FromAIToReality/OpenMicroDuck/hardware/imu_to_dxl/README.md

> **上游技术参考，不是本项目实测结论。** 来源：[fanhao375/microduck-replica](https://github.com/fanhao375/microduck-replica/blob/a23f4c18a4741a3cde5257e639960ea37bbadd8d/hardware/imu_to_dxl/README.md)。保留原作者及贡献者署名；正文中的“本项目”、实物、照片和测试记录属于上游。与我们的硬件不一致时，以[本项目说明](../../docs/hardware.md)为准。

# imu_to_dxl 原理图 + PCB · 求评审

> ⚠️ **这是第三方复刻件，不是官方设计。**
> 官方从未公开这块板的原理图、Gerber 或外形（全网零命中，见
> [硬件方案逆向](../../docs/硬件方案逆向.md)）。本目录是根据 MJCF 模型、官方运行时源码
> 和已开源的 HAT 工程反推 + 自行选型的结果，**未经打样、未经实物验证**。
> 发现问题请开 [issue](https://github.com/fanhao375/microduck-replica/issues)。

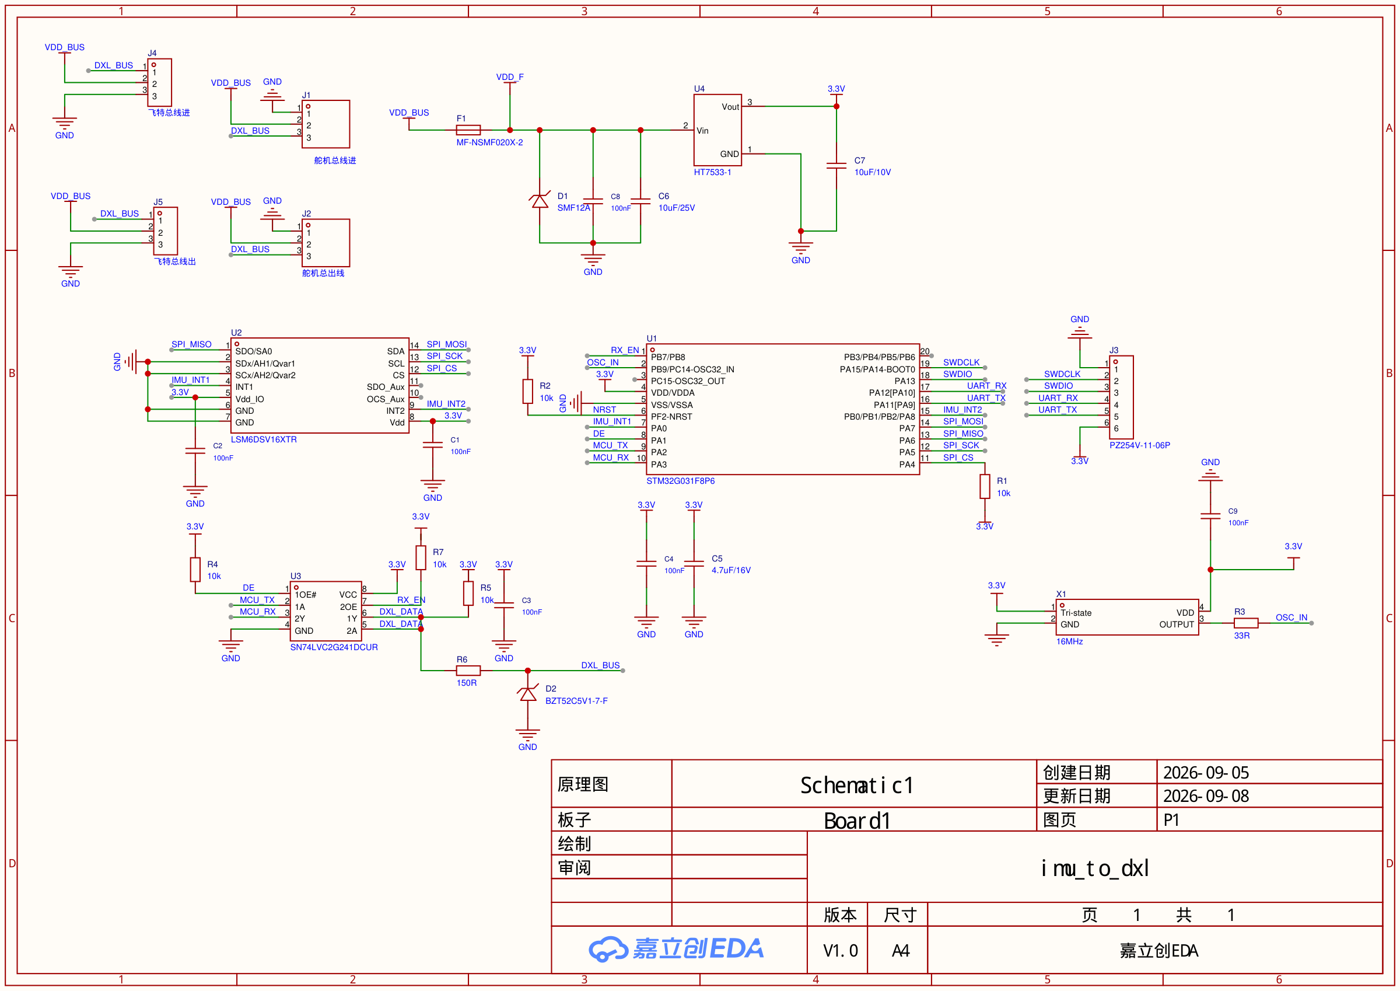
[picture p8: assets/hw/imu_to_dxl-原理图.png]
imu_to_dxl 原理图


| 文件 | 说明 |
|---|---|
| [`imu_to_dxl-原理图.pdf`](https://github.com/fanhao375/microduck-replica/blob/a23f4c18a4741a3cde5257e639960ea37bbadd8d/hardware/imu_to_dxl/imu_to_dxl-%E5%8E%9F%E7%90%86%E5%9B%BE.pdf) | 矢量 PDF，放大看细节 |
| [**`imu_to_dxl-交互式BOM.html`**](https://github.com/fanhao375/microduck-replica/blob/a23f4c18a4741a3cde5257e639960ea37bbadd8d/hardware/imu_to_dxl/imu_to_dxl-%E4%BA%A4%E4%BA%92%E5%BC%8FBOM.html) | **焊接用**：嘉立创 EDA 导出的交互式 BOM，下载后浏览器直接打开（离线可用）。点料号，板图上高亮对应位号，焊一种勾一种。GitHub 页面上直接点只显示源码 |
| [**`firmware/`**](firmware/) | STM32G031 + LSM6DSV16X 固件、Keil 工程、主机测试及一个预编译 HEX；0.2.0 起是飞特 SCS/STS 协议（ID 200），真总线尚未实测 |
| [**`总线协议.md`**](总线协议.md) | **给写固件的人**：15 字节块逐字节定义、时序要求、排队规则、主控的判据、测试向量、验收方法 |
| [`imu_to_dxl-接线表.md`](imu_to_dxl-接线表.md) | 逐网络列出每个引脚，可以直接对着核 |
| [`imu_to_dxl.eprj2`](https://github.com/fanhao375/microduck-replica/blob/a23f4c18a4741a3cde5257e639960ea37bbadd8d/hardware/imu_to_dxl/imu_to_dxl.eprj2) | 嘉立创 EDA 专业版工程，可直接打开改 |
| [`../../BOM.md`](../../BOM.md) | 完整 BOM，含立创编号与每颗器件的选型理由 |

**固件与姿态查看入口：** [`firmware/README.md`](firmware/README.md) 记录单板启动、IMU采样和验证范围。
通过 [`tools/servo-web`](../../tools/servo-web) 可将小板姿态叠加到舵机调试台的 3D 鸭子：关节角来自舵机，躯干四元数来自 IMU。
三种读法：`--imu-bus`（舵机总线，跟主控同一条 sync_read，读 ID 200 地址 56 的 15 字节块）、`--imu-swd`（ST-Link / DAPLink）、`--imu-jlink`（J-Link）。
真总线的 `imu200.py check` 验收还没做。

---

## 这块板干什么

官方 Microduck 的 15 个舵机挂在一条 Dynamixel 半双工总线上。这块小板
**作为第 16 个设备挂在同一条总线上**，对外表现成一个 Dynamixel 从机（ID 200），
主控用读寄存器的方式向它要姿态数据。

板上的 IMU 用的是 **LSM6DSV16X**，它片内有 **SFLP 硬件融合块**，
直接输出游戏旋转四元数 —— 姿态解算不占主控算力，也不占总线带宽。

```
主控（树莓派/泰山派）
      │  1 Mbps 半双工单线
      ├── 舵机 ×15
      └── imu_to_dxl（本板，ID 200）
             ├── LSM6DSV16X   SPI 四线 + 两路中断
             ├── STM32G031F8P6 收包 / 组包 / 读 IMU
             └── SN74LVC2G241 半双工收发缓冲
```

## 核心选型与理由

| 位号 | 器件 | 为什么选它 |
|---|---|---|
| **U1** | STM32G031F8P6 | ① USART 有**硬件 DE**（RS485 Driver Enable）—— 1 Mbps 下一个比特只有 1 µs，软件翻方向脚的抖动就在这个量级。对照：**STM32F401 手册全文没有 "Driver Enable"**，只能软件切<br>② 与 IMU 同厂，ST 的 `lsm6dsv16x-pid` 驱动和 SFLP 例程现成 |
| **U2** | LSM6DSV16XTR | 片内 SFLP 融合，直接出四元数 |
| **U3** | SN74LVC2G241DCUR | 双缓冲做单线半双工。通道 1 左进右出、通道 2 右进左出，正好对着走线。3.3 V 供电时**输入耐 5.5 V**，扛得住舵机 5 V 的信号 |
| **U4** | HT7533-1 | **耐压 30 V** —— 前两道保护都失效时它自己还活着 |
| **F1** | PPTC MF-NSMF020X-2 | **24 V / 200 mA 保持**。本板故障时先断自己，不拖垮整条舵机总线 |
| **D1** | TVS SMF12A | 截止 12 V > 满电 8.4 V，钳位 19.9 V < C6 的 25 V 耐压 |
| **C6** | 10 µF / **25 V** | 挂在 8.4 V 母线上。MLCC 有直流偏压衰减，6.3 V/10 V 的余量不够 |
| **C5** | 4.7 µF | 与 C4 的 100 nF 组成 ST 要求的组合 —— **DS12992 Rev 3, Figure 13** 对 `VDD/VDDA` 明确标注 `1 × 100 nF + 1 × 4.7 μF` |

## 几个可能有争议的决定

### 1. `2OE` 接常高，发送时会听到自己的回显

`U3.1 (1OE#)` 接 DE 控制发送缓冲，`U3.7 (2OE)` **直接接 3.3 V，接收缓冲常开**。

- 代价：发送时 MCU 会在 RX 上收到自己发的字节，固件按发送长度丢弃
- 好处：PA3 永远有人驱动，**不会悬空**

备选是 `2OE` 也接 DE（发送时关掉接收），但那样发送期间 RX 浮空，
重新使能时可能产生假起始位。我选了前者，**欢迎反驳**。

### 2. 没有晶振，只留了焊盘

TSSOP-20 封装**没有引出 `OSC_OUT`**（DS12992 Rev 3, Table 12：2 脚 `PC14` 的附加功能有
`OSC_IN`，3 脚 `PC15` 只有 `OSC32_OUT`），所以**无源晶振根本接不了**。

HSI16 精度（Table 41）：出厂 −0.75%/+0.5%，0–85 °C 温漂 ±1% → 最坏约 **−1.85%/+1.55%**。
1 Mbps 异步 UART 典型容差 ±3%，够用但余量不多。

板上有 **X1（16 MHz 有源晶振，HSE 旁路）+ C9 + R3**，最初默认不贴，2026-09-08 起改为**默认贴片**（固件仍以 HSI16 起步，实测 1 Mbps 有误码再切 HSE 旁路）。X1 的使能脚固定接 3.3 V，PC15 没接到它，MCU 关不掉晶振，见「评审记录 · 2026-09-16」。
另外固件可以用定时器输入捕获测主机来的比特周期，反调 `HSITRIM`（步进 0.2–0.4%/档），
误差能压到 0.3% 以内，不花钱。

### 3. J1 / J2 保留两个，靠铜皮解决过流

J1 和 J2 三根线一一并联。**本板若在链条中间，下游全部舵机电流都流过本板的连接器和铜箔。**

飞特 HD-1910-C001 官方参数：额定 **500 mA** / 堵转 **1.8 A**。

但这个约束**不是本板独有的** —— 舵机之间本来就是菊花链，它们自己的连接器承受同样的电流。
HAT 有 **4 个舵机接口**，15 个舵机分在 4 条支路上，每条最多 4 个，一条支路额定约 **2 A**，
在 3 A 以内。官方设计能接受，本板用同样的座子不会更差。

**所以保留两个座子**：想挂末端就不装 J2，想串中间就装上，灵活性几乎零成本。
PCB 上把 `VDD_BUS` 与 `GND` 从 J1 到 J2 走**大铜皮**（≥ 2 mm 或直接铺铜）即可。

> 曾有评审意见建议「只留一个 3P 座子」。那在本板确定是叶子节点时成立，
> 但**如果它是链条第一个节点**（HAT 出来先进本板、再出去给舵机），就必须两个。
> 官方拓扑无从确认，保留两个更稳。

### 4. 协议靠软件自动识别，没做跳线/拨码

飞特与 Dynamixel 的物理层完全相同（半双工单线 / 1 Mbps / 3 线 / GND-VCC-DATA），
差别只在包格式：

| | 包头 | 后续 | 校验 |
|---|---|---|---|
| Dynamixel V2 | `FF FF` | **`FD 00`** | CRC-16 |
| 飞特 SCS | `FF FF` | `ID` + `LENGTH` | `~(ID+LEN+INST+参数)` |

飞特官方协议文档写明 **Length = 参数个数 N + 2**，所以最小为 2、**永远不会是 0**；
ID 范围 0–253。→ `FF FF FD 00` 只可能是 V2，**判别无歧义**。

固件收到第一包校验通过就锁定协议，之后按锁定的收发，**运行中不自动解锁**（原想"连续 100 包失败重判"，2026-09-17 评审指出总线噪声会让小板哑 2 s、主控 3 tick 没读数就 hold，改掉；见 [`software/飞特适配架构.md` §3.5](../../software/飞特适配架构.md)）。
比拨码开关可靠（会走路的机器人里，拨码触点是振动失效点）。

### 5. J3 用 6P，把串口 printf 也引出来

按2026-09-08原理图 PDF，脚序为
`1=GND 2=SWDCLK 3=SWDIO 4=UART_RX 5=UART_TX 6=+3V3`。
SWD用 **1、2、3、6** 脚；第6脚供调试器电压参考。**旧四针排线不能整排插到1–4脚**，
第4脚是串口输入，不能当作3.3V。接线前核对实板的一脚标记与调试器引脚定义。

UART 来自 U1 脚 16/17（`PA11[PA9]` / `PA12[PA10]`），经 `SYSCFG_CFGR1` 重映射成
`USART1_TX/RX`。

**不上 USB**：G031 没有 USB 外设（手册 Development support 只写 "serial wire debug (SWD)"），
加 USB 要多一颗 CH340/CP2102，45 × 22 mm 板上不划算。
调试走 SWD + RTT（`probe-rs` 支持在 CMSIS-DAP 上跑 RTT，不停 CPU）。

> Cortex-M0+ **没有 SWO/ITM**，别指望 SWO printf。

---

## 板框与安装孔

| 项 | 值 |
|---|---|
| 板框 | **45 × 22 mm**，2 层板 |
| 四角 | **R2 圆角** |
| 安装孔 | **2 × M2 非金属化孔 φ2.2 mm**，走对角 |
| 孔位（板左下角为原点） | MH1 (2.667, 2.413)、MH2 (42.672, 19.685) mm |
| 孔距 | X 向 40.00 mm ／ Y 向 17.27 mm ／ 对角 43.57 mm |
| 孔到板边 | MH1 **1.31 mm** ／ MH2 **1.22 mm**（嘉立创要求 ≥0.4 mm） |

两孔中点 (22.67, 11.05) 与板心 (22.50, 11.00) 相差 0.17 mm，**转 180° 装基本还能对上**（偏差 0.34 mm）。

> ⚠️ **孔位在 2026-09-08 改过。** 原设计是 MH1 (5.5, 3.5) / MH2 (39.5, 18.5)、X 向 34 mm，
> 刻意对齐原版 `banana_pcb_locker` 打印件的两个定位耳间距。
> **加 `J4`/`J5` 时 MH2 的让位圈正好卡住右边那条唯一能放插件的空白带**，
> 于是把两个孔都往角上挪，X 向变成 40 mm。
> **代价是不再与原锁扣通用 —— 机械侧同步改压条。**
> 反正逆向文档里「锁扣压的就是 `imu_to_dxl`」本来也只是推断
> （见 [硬件方案逆向](../../docs/硬件方案逆向.md)），硬约束只有「IMU 刚性固连在 `trunk_base` 上」这一条。

板框文件：`imu_to_dxl-板框-45x22-R2.dxf`（单位 mm，8 段闭合：4 直边 + 4 段 90° 圆弧）。

> **为什么单独给 DXF**：这版立创EDA专业版的图元接口只接受铜层，
> 往板框层（layer 11）建线/弧一律报「参数不正确」，改层、改文档源都被挡，
> 所以板框走 DXF 导入（`文件 → 导入 → DXF`，目标层选**板框层**，单位 mm，原点对齐 0,0）。
> 两个 M2 孔不在 DXF 里 —— 它们已经作为真实的 NPTH 焊盘建在 PCB 上了。

## PCB：布局与布线

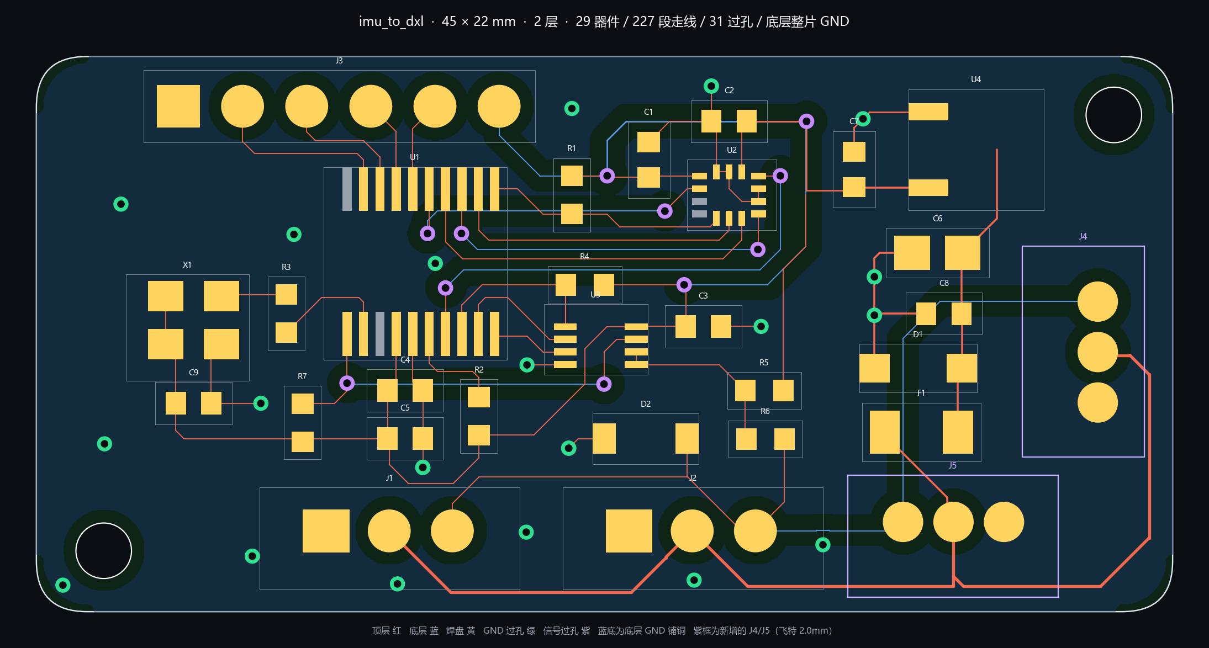
[picture p9: assets/hw/imu_to_dxl-PCB.png]
imu_to_dxl PCB 顶层装配图


*布线图，由工程实测数据渲染（顶层红 / 底层蓝 / 焊盘黄 / GND 过孔绿 / 信号过孔紫，蓝底为底层 GND 铺铜，紫框为 `J4`/`J5`）。*
*状态 2026-09-08：29 器件 · 227 段走线 · 31 过孔 · 172 泪滴，含 `R7`、`J4`、`J5`，`X1`/`R3`/`C9` 已改为实贴。*
*本目录的 `.eprj2` / PCB PDF / 原理图 PDF / STEP 与 `assets/` 下两张图，**全部已更新到 2026-09-08 的最终版**。*

**45 × 22 mm，2 层板，1 oz 铜**，四角 R2 圆角，两个对角 M2 非金属化孔。
贴片件全在正面；3 个插件连接器分两条边：`J1` `J2`（舵机总线）在下边，
`J3`（SWD + 串口）在上边。

### 分区

| 区 | 内容 | 为什么 |
|---|---|---|
| 下边 | `J1` `J2` 总线连接器（JST EH 2.5 mm） | 线束从躯干走线，就近出线 |
| 右下 | **`J5` 飞特总线出**（2.0 mm） | 与 `J1`/`J2` 同侧，四个座子的 `VDD_BUS` 直通铜皮连成一条 |
| 右边缘 | **`J4` 飞特总线进**（2.0 mm） | 全板唯一放得下插件的空白带；为它让路才把 MH2 挪走的 |
| 右侧 | `F1` → `D1` → `C6`/`C8` → `U4` → `C7` | 电源链一条路走到底，跟数字区隔开 |
| 中部 | `U3` 缓冲 + `D2` 钳位 + `R6` 串阻 | 夹在 MCU 和总线连接器之间，收发路径最短 |
| 中上 | `U1` 主控、`U2` IMU 及各自去耦 | |
| 左侧 | `X1` / `R3` / `C9` 时钟位 | 已改为实贴，放在边角不占好位置 |
| 上边 | `J3` 调试排针 | 插拔方向朝外 |

### 布线

| 项 | 值 |
|---|---|
| 元件 | **29 个**（含 09-07 新增的 `R7`、09-08 新增的 `J4`/`J5`） |
| 走线 | **227 段**（顶层 197 / 底层 30） |
| 线宽 | 信号 0.25 mm 为主；**总线直通 0.76 mm** |
| 过孔 | **31 个，φ0.6 / 孔 0.3 mm** |
| 泪滴 | 172 个 |
| 铺铜 | **底层整片 GND**，顶层不铺 |

底层 30 段走线，**地平面基本完整**——这是给 SPI 和 1 Mbps 半双工总线留的回流路径。
顶层的 GND 焊盘各自就近打过孔下到地平面。

### 复查结果 · 2026-09-08

除立创自带 DRC 外，另用脚本按**真实焊盘形状**（圆形 / 跑道形 / 矩形）重新栅格化，
独立复核了一遍：

| 检查项 | 结果 |
|---|---|
| 立创 DRC | **0 违规** |
| **连接器脚序** | **四个全对**：`J1`/`J2` = `GND`/`VDD_BUS`/`DXL_BUS`；`J4`/`J5` = `DXL_BUS`/`VDD_BUS`/`GND`（**反序**，见下方脚序一节） |
| 网络连通性 | **23 个网络全部连通**（栅格连通域 + 过孔/插件孔跨层，含底层铺铜） |
| 异网最小间距 | **0.152 mm ＝ 5.98 mil**（精确几何，非栅格）。嘉立创双面板下限 0.127 mm，余量 20% |
| 铜到板边 | 最小 **0.37 mm** |
| 孔到孔（孔壁间） | 最小 **0.751 mm**，要求 ≥0.4 mm |
| 孔到板边 | MH1 **1.31 mm** / MH2 **1.22 mm** |
| M2 让位 | MH1 让位圈 2.5 mm 内只有一个 **GND** 过孔（1.81 mm）—— 螺钉压到地还是地，无害；MH2 最近 4.59 mm |
| 过孔规格 | φ0.6 / 孔 0.3 mm，符合嘉立创双面板下限 |
| 去耦距离 | `U1.4`→`C4` 2.27、`U2.8`→`C1` 2.00、`U2.5`→`C2` 2.01、`U3.8`→`C3` 1.96、`X1.1`→`C9` 2.39 mm，均 <2.4 mm；`U4.3`→`C7` 2.94 mm。⚠️ `U4.2` LDO 输入侧的 100nF `C8` 为 **6.64 mm**（偏松，但管瞬态的 10µF `C6` 在 4.29 mm，且 LDO 是线性的无开关） |

**载流核算**：四个座子之间的 `VDD_BUS` 直通链
`J1.2 → J2.2 → J5.2 → J4.2` **全程 0.76 mm**，1 oz 铜下 ΔT=10K 约 2.0 A、ΔT=30K 约 3.2 A。
JST EH 单触点额定 3 A，**走线与连接器基本同一量级**，加宽并不能抬高整条链路的上限。
另有 4.7 mm 的 0.51 mm 段在 `J1.2 → F1.1` 这条**只喂本板自己**的支路上，
前面是 200 mA 保持的 PPTC，够用。

> **2026-09-08 抓到并修掉一处**：布 `DXL_BUS` 去 `J4`/`J5` 时，有一个 φ0.3 过孔
> 落在了 `J2.3` 的 φ1.0 插件孔正上方（孔心距 0.001 mm）。立创 DRC 报
> `Hole to Hole (DXL_BUS): J2_3 ↔ e75` —— 钻孔是机械工序，同网络也不允许重叠。
> `J2.3` 本身是贯穿孔、顶底早已连通，该过孔纯属冗余，删除后连通性不变、DRC 归零。

**仍未验证**：**没有打样，没有实物**。以上全部是几何与规则层面的核对，
不能替代实测。

### 待办

- 下单前跑一次**器件标准化**（原理图 DRC 报过「元件属性与供应商编号不匹配」）
- 丝印复核：位号是否压焊盘、`U1` 一脚 / `D1` `D2` 阴极 / `J1` 一脚标记是否齐全
- **连接器高度**：`J1`/`J2`/`J3` 是 JST EH / 2.54 排针直插，本体约 **8 mm**。若躯干内腔
  确实只有 6.65 mm，需换卧式 `S3B-EH-A`，封装与 BOM 都要跟着改 —— 用导出的 STEP 在
  装配体里比一下即可定论。
  **`J4`/`J5` 反而不用担心**：`B3B-PH-K-S` 本体约 **6.0 mm**，塞得进 6.65 mm 的内腔
- **板端座子型号待确认**：飞特规格书只写了线端是 `AMP2.0-3P`，**板端型号没给**。
  本板暂用 `B3B-PH-K-S`（JST PH，2.0 mm 立式）。焊盘阵是三孔 2.0 mm 间距，
  与其它 2.0 mm 系列通用，**将来换系列只改封装、不动焊盘、不重布线**
- **下单前重导生产文件** —— 器件从 27 变 29，立创那边的 Gerber / BOM / 贴片坐标都要重传

## 想请你重点看这几处

1. **`2OE` 常开这个取舍**（上面第 1 条）—— 回显 vs RX 悬空，哪个更糟
2. **J1/J2 过流与铜皮宽度**（第 3 条）—— 2 mm 够不够
3. **HSI16 跑 1 Mbps 的余量**（第 2 条）—— 有实测经验的说一声
4. **三道过压防线够不够** —— 8.4 V 母线 + 舵机反电动势
5. **连接器**：见下方「⚠️ 飞特脚序按型号不同，而且是反的」。`J4`/`J5` 两个 2.0 mm 座子
   已在原理图与 PCB 上落位（2026-09-08），但**板端座子的确切系列还没拿实物比过**
   —— 飞特规格书只写了线端 `AMP2.0-3P`，板端型号待厂家确认

## ⚠️ 飞特脚序按型号不同，而且是反的

**这是本板最容易致命的一处，两份厂家规格书各自都没错 —— 是两个型号真的相反。**

| | 连接器 | 脚 1 | 脚 2 | 脚 3 |
|---|---|---|---|---|
| **`HD-1910-C001`**（本仓库选用） | **`AMP2.0-3P`**（2.0 mm） | **Signal/TTL** | Vcc | **GND** |
| `HL-2915-C002`（另一型号，勿照抄） | `AMP-3` | **GND** | Vcc | **Signal/TTL** |
| 本板 `J1`/`J2`（JST EH 2.5 mm，同官方 HAT） | `B3B-EH-A` | GND | VDD_BUS | DXL_BUS |
| 本板 `J4`/`J5`（2.0 mm，对口飞特） | `B3B-PH-K-S` | **DXL_BUS** | VDD_BUS | **GND** |

四个座子的脚序已从 PCB 网表反读复核过，全部落对（2026-09-08）。
**两种间距插不进对方（2.0 vs 2.5 mm），物理上杜绝了插错，只剩「画错」这一种可能。**

出处：飞特《HD-1910-C001 串型规格书》**A/0，2026-09-07** 第 3/7 页 6-7 项；
飞特《HL-2915-C002 串型规格书》A/0，2026-02-27 第 4/8 页 6-7 项。
两份都是厂家发给客户确认的规格书，**本仓库按惯例不转载 PDF**，需要请向飞特索取。

> 本仓库此前只记了 `HL-2915` 那一行、却推荐 `HD-1910` 作为替代型号，**是个坑**，
> 2026-09-08 按 A/0 新规格书更正。
>
> ⚠️ **`HL-2915-C002` 是 9–14 V（典型 12 V）舵机，挂不上本方案的 2S 母线（6.6–8.2 V）**
> —— 它 9 V 才开始工作。当初拿它当「飞特接口惯例」的样本是权宜之计，别照着选型。
>
> ⚠️ **间距也对不上**：`AMP2.0` 是 2.0 mm，`JST EH` 是 2.5 mm，**插不进对方**。
> 好在这一点反而是保险 —— 物理上杜绝了插错，只剩「画错」这一种可能。

## 已确认 / 未验证

**已确认（一手资料）**

- **HD-1910-C001** 接口 `1=Signal/TTL · 2=Vcc · 3=GND`，连接器 `AMP2.0-3P`，线长 15±0.5 cm
  —— 飞特《HD-1910-C001 串型规格书》A/0 (2026-09-07) 第 3/7 页 6-7 项
- HD-1910-C001 走 **TTL 三针总线**，**4–8.4 V**，堵转 9/12/15 kg·cm @4.8/6/7.4 V，
  额定电流 **500/690/900 mA**，堵转电流 **1.2/1.6/2.0 A**，静态 20 mA，12 bit 磁编码，
  减速比 1/320 —— 同上规格书第 2/7、3/7 页
- **电机自带三道电子保护**（同上第 4/7 页 7-11）：
  **过流**（>0.5 A 持续 2 s 关输出，阈值与时长可自定义，**出厂默认关闭**）·
  **过压**（>10 V 或 <4 V 保护，范围可自定义，**出厂默认关闭**）·
  **过热**（>80 ℃ 关扭矩输出，**出厂默认开启**）。
  **装机前应把前两条打开** —— 异常检测在电机里做，主机不必轮询
- 反馈六项齐全：输入电压 / 负载 / 工作电流 / 工作速度 / 工作温度 / 位置（同上 7-10）。
  官方运行时确实在用：`present_current` 每 tick 随位置一起读，电压+温度约每秒一次，
  且**电压是整机唯一的电池计量手段**（`duck-control/src/{bus,model}.rs`）
- 出厂默认运行模式是**模式 4「纯位置 PD（Sim2Real）」**，正对强化学习落地（同上 7-12）
- 包格式、`Length = N+2`、校验算法、同步读 `0x82` —— 飞特官方《舵机SCS通信协议》
- 包格式、`Length = N+2`、校验算法、同步读 `0x82` —— 飞特官方《舵机SCS通信协议》
- STM32G031 无 HSE 引脚、HSI16 精度、`100 nF + 4.7 µF` 去耦要求 —— ST DS12992 Rev 3
- 原理图连通性 —— 已用脚本逐网络核对，无悬空脚、无短路、无重名网络

**未验证**

- **整块板没打样过**，没有实物
- 板框 45 × 22 mm 与 M2 孔 X 向 34 mm 间距是从打印件 `banana_pcb_locker` 反推的，非官方尺寸
- MCU 型号是本仓库的选型建议，**不是逆向所得** —— 官方那块板用什么 MCU 无从还原

---

## 评审记录

### 2026-09-16 · 外部评审八条 + 自查发现 X1 使能脚没接上

板子已在立创生产，这些都算「首板回来验什么」。

| 评审意见 | 结论 | 依据 |
|---|---|---|
| ① X1 接 PC14/OSC32_IN 是错的，PC14 只是 LSE 脚 | **不采纳，评审错了** | DS12992 Rev 3 Table 12（p.36）：TSSOP20 第 2 脚附加功能为 `OSC32_IN, OSC_IN`，两个都有；p.60：HSE 旁路模式下振荡器关闭、输入脚按普通 GPIO 电平收外部时钟。小封装不引 PF0/PF1，HSE 外部时钟输入就是安排在 2 脚。无源晶振接不了（缺 OSC_OUT）这点本目录一直写着 |
| ② U2 的 OCS_Aux / SDO_Aux 悬空是漏接 | **不采纳**，文档措辞统一 | DS13510 p.10 / p.48：两脚均「接 Vdd_IO 或悬空」，默认内部上拉（PIN_CTRL.OIS_PU_DIS = 0）。悬空是手册标准做法。v2 可留 0 Ω 位 |
| ③ 2OE 常开有回显，建议默认发送时关接收 | 硬件已支持两种，固件决定 | 9 月 7 日已把 `2OE` 改成 `RX_EN` 网络接 PB7，见下方记录 |
| ④ 逻辑支路保护不等于整机过压保护 | 同意，本就这么写的 | TVS 管尖峰、PPTC 慢、LDO 只护逻辑支路，见「对照官方 HAT 复审」 |
| ⑤ J1/J2 直通电流是系统级限制 | 同意，已写明 | 本板做链尾，EH 座 3 A |
| ⑥ J4/J5 板端座子未经实物验证 | **同意，首板前就该做** | 飞特只确认线端 AMP2.0-3P，`B3B-PH-K-S` 能不能插、锁扣方向、脚序，买几个座子拿舵机线试 |
| ⑦ 布局建议（IMU 居中、LDO 远离、测试点、J3 加 NRST） | v2 采纳 | — |
| ⑧ 首板验证清单 8 条 | 采纳，作验收 | 复位期间总线高阻、1 Mbps 收发 00/FF/55/AA、30 000 次通信统计 CRC/超时/overrun、IMU 零偏随温度、逐针测极性、X1 未装时 PC14 不被驱动 |

**自查（2026-09-16）**：按原理图 PDF 的矢量线段逐脚核对，没有接线的只有本来就该空的四个脚：U1.3（PC15）、U1.20（PB3–PB6）、U2.10（OCS_Aux）、U2.11（SDO_Aux）。X1 第 1 脚 `Tri-state` 接的是 3.3 V 常使能（符号上的小红圈是 EasyEDA 的 1 脚标记，不是未连接）。接线表里写的「3 脚（PC15）可作 `OSC_EN`」**没有画进图**：PC15 空着，X1 关不掉。首板要 MCU 能控晶振的话，飞一根线 PC15 → X1.1 并去掉 3.3 V 那根，或者不贴 X1 用 HSI16。

### 2026-09-17 · 首板到货实测

- 5 块板到货，上电 **3.3 V 输出正常**（F1 → D1 → U4 这条链没问题）。
- **J4/J5（`B3B-PH-K-S`）外壳跟飞特线插头不配**：间距 2.0 mm 是对的，插头外形进不了 PH 座的外壳。评审第 ⑥ 条说中了。首板把座子外壳削掉、只留针，能插能用。**v2 换座**：拿飞特线实物配（问飞特板端座子型号，或买几种 2.0 mm 3P 卧式座子试插）。
- X1 时钟、NRST、IMU 供电、SWD 通断还没量；固件要做什么、主控对它的全部要求在 [`software/飞特适配架构.md` §4](../../software/飞特适配架构.md#4-小板固件方案-a--imu_to_dxl)。

### 2026-09-22 · 固件跑起来了（ST-LINK/V2）

- 固件在 [`firmware/`](firmware/)（同学写的底子，PR #32；0.2.0 起是飞特协议）。ST-LINK/V2 经 J3 的 1/2/3/6 脚烧录、读回校验通过，IMU 实测：WHO_AM_I=0x70、约 121 Hz、静止时加速度合成 1.007 g、错误计数 0。
- **G0 空片的坑**：第一次烧完软件复位，程序不跑，停在 ST 自带 Bootloader（PC=0x1FFF…）—— `FLASH_ACR.EMPTY` 只在上电时更新。**断电重启一次**就好。按复位键（NRST）不重新检查，解决不了这个。
- **v2 要加**（首板调试时缺的）：
  - **复位按钮 + NRST 引到 J3**：跟评审第 ⑦ 条一起做。程序跑飞、SWD 连不上时可以按住复位再连（under-reset）救砖，也方便让固件重新跑一遍。
  - **运行指示灯**：接 **U1.20**（PB3–PB6，现在唯一完全空闲的 GPIO）+ 限流电阻。固件加心跳：正常慢闪、IMU 出错快闪，不接调试器也能一眼看出板子在不在跑。

### 2026-09-07 · 三条布局/选型建议（都不采纳，理由记下来）

评审人看了图纸提了三条：阻容换 0402、IMU 放板心、LDO 远离 IMU。逐条量了数据，
**结论是维持现状**，但每条的理由值得记下来 —— 尤其第二、三条其实指向同一件事。

**① 阻容换 0402 —— 不换，理由不在「能不能手焊」**

对方补充说「别折腾自己焊接，团一下上立创贴片省心」。这个建议本身对，但换不换 0402
的判据不在这儿：本目录 2026-09-06 那条记录第一句就写了「**理由不是 0402 手焊不了**」
—— 板上有 LGA-14 的 LSM6DSV16X（底部焊盘 3×2.5 mm），本来就必须上热风。

真正的理由是**调试期返修**：`R6` 串阻要从 150 Ω 试到 33 Ω、上拉可能要摘、去耦可能要补。
**第一版没验证过的板子必然要改几次**，这一点不因为找立创贴片而改变 —— 贴片厂只负责
第一次，改还是得自己动烙铁。

代价那边：16 个阻容换 0402 省 **12.5 mm²，占板面积的 1.3%**，而这块板**只用了 36%
的面积**，根本不缺地方。0402 的 10k/100nF 在立创同样是基础库，省料费这条对两边都成立、
不构成理由。

**② IMU 放板心 · ③ LDO 远离 IMU —— 方向都对，但量级不同**

先量数：

```
板心 (22.5, 11.0) = 两个 M2 孔的中点（当初就是这么设计的）
U2 (IMU)  离板心 7.47 mm，离两螺钉连线 3.00 mm
U3 (缓冲) 离板心 0.41 mm      ← 最刚的位置被逻辑芯片占了
U2 ↔ U4 (LDO) 中心距 6.37 mm
```

**热的量级**：板上总电流约 5–10 mA（G031 约 3 mA + LSM6DSV16X 约 0.65 mA + 缓冲约 1 mA
+ 上拉），LDO 压降 8.4 − 3.3 = 5.1 V → **耗散约 51 mW**（满电最坏）。SOT-89 在小铜箔上
θJA 约 100–160 °C/W → 结温升 **5–7 °C**；隔 6.4 mm、中间一整片底层地铜散热，传到 IMU
处**温差约 1–3 °C**。LSM6DSV16X 陀螺零偏温漂约 0.05 °/s/°C → **约 0.1 °/s 偏置**。
走路时陀螺是几十 °/s 量级，且躯干里 15 个舵机吃安培级电流，热源比 51 mW 大两三个数量级。
**方向对，但不是主导项。**

**真正值得动的是第②条的另一面**：板心正好是两螺钉中点，是全板最不易形变的位置，
而现在坐在那儿的是不在乎位置的 `U3`。把 `U2`/`U3` 对调可一箭三雕 ——
IMU 离板心 7.47 → 0.4 mm，同时离 LDO 6.37 → **11.3 mm**（翻倍）。

**为什么这次仍不动**：板子已 DRC 0 违规、全部布通；对调意味着中间区域重排 + 重布
SPI×4、2 个中断、缓冲的 DE/TX/RX/DXL_DATA。按上面的量级估算，收益是"更稳妥"而非
"解决已知问题"。**留到打样后拿实测数据再决定** —— 若实测陀螺零偏随 LDO 负载明显漂移，
或振动噪声偏大，v2 一并改。

**一个更重要的提醒**：IMU 在**机器人里**的位置与朝向是训练模型定死的，比它在板上偏
7 mm 重要得多。那个由板子怎么装进躯干决定，已查证并记在
[`docs/硬件方案逆向.md`](../../docs/硬件方案逆向.md)：`trunk = [+raw_z, +raw_y, −raw_x]`，
绕 Y 轴 +90°。板上挪位置不影响这条。

### 2026-09-07 · 给 `2OE` 留一根控制线（R7 + RX_EN）

有人建议把「那个 EN 脚」预留一根线到 MCU。指的是 `U3.7 (2OE)` —— 接收缓冲的输出使能，
此前硬接 +3V3、接收常开。**已采纳。**

**改动**

| | |
|---|---|
| 断开 | `U3.7 (2OE)` 与 `+3V3` 的直连 |
| 新增 | **R7 = 10 kΩ 0603**（`C25804`，与 R1/R2/R4/R5 同一颗料，不新增料号） |
| 新网络 | **`RX_EN` = `U1.1 (PB7/PB8)` · `U3.7 (2OE)` · `R7.1`** |
| 保留 | `R7.2 → +3V3`（上拉） |

**为什么选 U1.1**：U1 空闲的是 1 脚 (PB7/PB8)、3 脚 (PC15)、20 脚 (PB3/PB4/PB5/PB6)。
3 脚是 PC15，在 G0 上与 LSE 共用、驱动能力受限；20 脚并了四个口最灵活，留着。
1 脚是普通 GPIO，且与 `DE`/`MCU_TX`/`MCU_RX` 同在下排，走同一条通道。

**默认行为完全不变** —— MCU 复位期间 PB7 高阻，R7 把 `2OE` 拉高，接收缓冲照常开着。
固件一行不写，跟改动前一模一样。这是**预留**：想消掉发送期间的回显时，把 PB7 配成推挽
输出拉低即可，同时打开 `MCU_RX` 脚的内部上拉，避免 `2Y` 高阻时 RX 浮空 ——
这正是此前否掉「`2OE` 接 DE」方案的那个顾虑，用独立 GPIO + 内部上拉就解决了。

**改后复查**：元件 26→27、网络 23→24，`RX_EN` = 3 个脚，`+3V3` 里 `U3.7` 已移出、
`R7.2` 顶上。立创 DRC **0 违规**，异网最小间距 **0.160 mm**（改前 0.153），
其余各项与 2026-09-07 首次复查一致。

**顺带更正**：本目录 `imu_to_dxl-接线表.md` 的「悬空脚」清单此前误列了 2、16、17 脚
（它们分别接 `OSC_IN`、`UART_TX`、`UART_RX`），已改。现在真正空闲的只有 3 脚与 20 脚。

### 2026-09-07 · 关于 U3 缓冲器的三个疑问（两条不采纳，一条改画法）

评审人查了 SN74LVC2G241 手册，对 U3 的接法提了三点。逐条核过 —— 网表是从
PCB 里现读的（PCB 网络由原理图导出，等价于原理图连接）：

```
U3 脚1  1OE#  → DE          脚5  2A   → DXL_DATA
U3 脚2  1A    → MCU_TX      脚6  1Y   → DXL_DATA
U3 脚3  2Y    → MCU_RX      脚7  2OE  → 3.3V
U3 脚4  GND   → GND         脚8  VCC  → 3.3V

DXL_DATA  4 脚：R5.2 R6.1 U3.5 U3.6     ← 不含 U3.7
DE        3 脚：R4.2 U1.8 U3.1
MCU_TX    2 脚：U1.9 U3.2
MCU_RX    2 脚：U1.10 U3.3
```

**① 「A 是输入、Y 是输出，所以脚3 该接 DXL_DATA、脚5 该接 MCU_RX」—— 前提对，结论反了**

手册原文没错：器件是两路独立使能的 1 位线路驱动器，数据方向恒为 **A → Y**。
但据此换线就错了：

- `MCU_RX` 是**要被缓冲器驱动的**网络（送进 MCU 的接收脚），必须落在**输出脚 Y**
  → 现在在脚3（2Y）✅
- `DXL_DATA` 是**要被读进来的**网络（总线上舵机发的），必须落在**输入脚 A**
  → 现在在脚5（2A）✅

按建议对调后，通道2 变成 `MCU_RX(2A) → DXL_DATA(2Y)`，等于从 MCU 的接收脚
往总线上发数据 —— RX 是输入脚不输出电平；而且 `1Y` 与 `2Y` 会同时驱动
`DXL_DATA`，两个驱动器直接对打。

现在的分工是标准半双工接法：**通道1 = 发**（`MCU_TX → 总线`，受 DE 控制），
**通道2 = 收**（`总线 → MCU_RX`，常开）。**不采纳。**

**② 「2OE 该串个上拉电阻，否则上拉太强」—— 电气上不成立，但画法要改**

`2OE` 是 CMOS 逻辑输入，输入电流量级 ±1 µA，直接接 VCC 是手册的标准用法。
串电阻没有任何收益，反而给高阻输入引入干扰耦合。

「上拉太强」这个担心，只有当该节点是**数据线**时才成立 —— 它不是：
`DXL_DATA` 网络只有 4 个脚（`R5.2` `R6.1` `U3.5` `U3.6`），**不含 `U3.7`**。
总线上拉是 `R5 = 10 kΩ`，值也合适。

**但这条提醒有价值**：会产生这个误解，是因为图上「2OE 的 3.3V 符号」正好压在
`DXL_DATA` 节点正上方，视觉上像连成一片。**已列为待改项：把该 3.3V 符号移开、
走线绕行**，消除歧义。属画法问题，不改电气连接。

**③ 「要默认导通的话，1OE# 应该接低电平」—— 默认不导通是有意的，不采纳**

`1OE#` 低有效，`R4` 把它**上拉到高**，意味着通道1（`MCU_TX → 总线`）
**默认关闭**。这是刻意的：

- 上电到固件跑起来之前，以及 MCU 死机 / 复位期间，本板**绝不能驱动总线**。
  总线是 15 个舵机共用的，一旦被钉住，整条链路通信全废。
- 若把 `1OE#` 常接低，`MCU_TX` 会一直往总线上灌，空闲高电平把总线拉死，
  舵机永远回不了包 —— 半双工不成立。

发送时由 MCU 把 `DE` 拉**低**。STM32 的 USART 硬件 Driver Enable 支持该极性，
`CR3.DEP = 1` 一个位搞定，外面不用加反相器。

> 这条与 2026-09-06 第 ① 条（社区反馈要求 DE 上拉）方向一致 ——
> 那次加 R4 正是为了保证「默认不驱动总线」，此处不能反过来。

**待办**：原理图上把 `U3.7` 的 3.3V 符号挪开，避免与 `DXL_DATA` 节点视觉相连。

### 2026-09-06 · 社区反馈（三条，两条已改）

**① DE 脚要上拉 —— 已改，这是漏项**

`U3.1 (1OE#)` 是低电平使能发送。上电与复位期间 MCU 的 **PA1 是高阻**，此脚浮空；
**若浮成低电平，发送缓冲就打开，本板会往总线上灌数据、与 15 个舵机全部撞车。**

已加 **R4 10 kΩ，DE → 3.3 V**。

此前在 `SPI_CS` 上加 R1 上拉正是同一个道理，**但没有推广到 DE**，属实是疏漏。

**② 两个 `DXL_DATA` 要连一起并上拉 —— 已改**

电气上原本就是同一个网络（`U3.5 2A` / `U3.6 1Y` / `J1.3` / `J2.3`），
但图上画成了两根各自带标签的短线，**看起来像没连**，是画法不够直观。已改为显式连接节点。

上拉这条也对：总线空闲无人驱动时，`2A` 这个 CMOS 输入浮空会有穿透电流，
UART 也可能把噪声当起始位 —— 本板应当自己定义空闲电平，不该依赖主机。
已加 **R5 10 kΩ，DXL_DATA → 3.3 V**。

**③ 只留一个 3P 连接器 —— 未采纳，理由见上面第 3 条**

该建议在本板确定为叶子节点时成立；但若本板是链条第一个节点则必须两个座子，
而官方拓扑无从确认。保留两个，靠铜皮宽度解决过流。

改完复核：`DE` 由 2 脚变 3 脚，`DXL_DATA` 由 4 脚变 5 脚，
全图无悬空脚、无短路、无重名网络。

### 2026-09-06 · 对照官方 HAT 复审（补两处保护）

把 [`pollen-robotics/elec_RPI_Robot_HAT`](https://github.com/pollen-robotics/elec_RPI_Robot_HAT)
的 `dynamixel.kicad_sch` 逐器件读了一遍，和本板对比。

**HAT 的 TTL 半双工电路**

```
                        ┌── R31 10k ── +3V3
   IO_15 (RX) ◄── U6 ───┘                    ┌── R32 10k ── +3V3
              (1G125, OE# 低有效)             │
                        ▲                     ▼
   IO_14 (TX) ──┬── U7 ──────────────────────► ● ── R33 150R ──┬── TH1 100R ── J13.3 / J14.3
                │  (1G126, OE 高有效)                       D4 5V1
                └── R27 10k ── Q1 (PNP) ── Dynamixel_dir        ⏚
```

**逐项对比**

| | 官方 HAT | 本板 | |
|---|---|---|---|
| 收发缓冲 | 1G125 + 1G126 两颗 | SN74LVC2G241 一颗 | 同逻辑 |
| 方向控制 | 从 TX 自动派生（Q1 + RC） | **USART2 硬件 DE** | 本板更好，见下 |
| 总线上拉 | R32 10 kΩ | R5 10 kΩ | 一致 |
| **数据线串阻** | R33 150 Ω + TH1 100 Ω | ❌ 无 → **已补 R6 150 Ω** | |
| **数据线钳位** | D4 5V1 | ❌ 无 → **已补 D2 5V1（同料号 `C151348`）** | |
| 电源保护 | 无（`+BATT` 直通连接器） | F1 PPTC + D1 TVS | 本板更好 |

**方向控制为什么本板更好**：HAT 从 TX 派生方向，靠 RC 时序回到接收态，
**释放早了会截断最后一个停止位**——这是 TX 派生方案的通病。
本板用 `USART2` 的硬件 DE，`DEAT`/`DEDT` 可按 1/16 比特精调，不存在这个问题。

**补完之后的数据线拓扑**（与 HAT 同构）：

```
U3.6 (1Y) ──┬─ DXL_DATA ─┬── R5 10k → 3.3V
U3.5 (2A) ──┘            │
                         └── R6 150Ω ──┬── DXL_BUS ── J1.3 / J2.3
                                       │
                                    D2 5V1
                                       ⏚
```

上拉留在**缓冲侧**（R5 在 R6 之前），与 HAT 的 R32 位置一致 ——
这样即使不插总线，`2A` 这个 CMOS 输入也有确定电平。

本板只串 150 Ω（HAT 是 250 Ω），因为 HAT 侧已经有 250 Ω，
总线上串太多会拖慢边沿。

复核：`DXL_DATA`（缓冲侧）4 脚、`DXL_BUS`（连接器侧）4 脚，
全图无悬空脚、无短路、无重名网络。

**顺带纠正本文档此前一处错误**：HAT 的 `TH1 100R 热敏`串在**数据线**上，
不是电源线上。`+BATT` 到 J13/J14 的第 2 脚是**粗线直通、无限流**。

### 2026-09-06 · 阻容封装统一改 0603

所有 0402 阻容改为 **0603**，D2 从 SOD-323 改为 **SOD-123**。

理由不是「0402 手焊不了」—— 板上有 **LGA-14 的 LSM6DSV16X**（底部焊盘 3 × 2.5 mm），
本来就必须上热风或回流，有那套工具 0402 也不难。

**真正的理由是调试期返修**：串阻要从 150 Ω 试到 33 Ω、某个上拉要摘掉、
去耦要补一颗 —— 这些在 0603 上拿烙铁几秒就能做，0402 得重新架热风。
一块没打样验证过的板子，第一版必然要改几次。

代价很小：11 个器件多占约 16 mm²，不到 45 × 22 mm 板面积的 2%。
而且 0603 这几个值**全在立创基础库**（10 kΩ `C25804` · 150 Ω `C22808` ·
33 Ω `C23140` · 100 nF `C14663`），比原来 0402 的扩展库还省上料费。

> C6（10 µF/25 V）保持 0805；C5（4.7 µF）、C7（10 µF）本来就是 0603。

换封装时同坐标同角度重放，实测**引脚坐标不变、连线一根没断**。
一个坑：`SOD-123` 的符号引脚顺序与 `SOD-323` 相反，换完 **D2 极性翻了**
（阴极跑到接地侧，正常工作会把总线钳到 0.7 V），已按引脚名核对并改正。
`create()` 的 `rotation` 参数在这个 API 里符号相反 —— 传 90 存进去是 270。
