FromAIToReality/OpenMicroDuck/cad/releases/README.md

# 全部 CAD 发布附件

附件已归档到本仓库 Releases，不使用其他作者的下载地址。大文件不直接放入 Git 文件树。

| 版本 | 文件 | 大小（MB） |
|---|---|---|
| v1.0 | [SolidWorks.zip](https://github.com/FromAIToReality/OpenMicroDuck/releases/download/cad-xl330-v1.0/SolidWorks.zip) | 341.55 |
| v1.1 | [SolidWorks-XL330-v1.1.zip](https://github.com/FromAIToReality/OpenMicroDuck/releases/download/cad-xl330-v1.1/SolidWorks-XL330-v1.1.zip) | 332.78 |
| v2.0 | [STEP-changed-parts-FT.zip](https://github.com/FromAIToReality/OpenMicroDuck/releases/download/cad-ft-v2.0/STEP-changed-parts-FT.zip) | 14.99 |
| v2.0 | [SolidWorks-FT.zip](https://github.com/FromAIToReality/OpenMicroDuck/releases/download/cad-ft-v2.0/SolidWorks-FT.zip) | 373.83 |
| v2.1 | [STEP-changed-parts-FT-2026-09-25.zip](https://github.com/FromAIToReality/OpenMicroDuck/releases/download/cad-ft-v2.1/STEP-changed-parts-FT-2026-09-25.zip) | 10.32 |
| v2.1 | [STEP-changed-parts-FT-2026-09-30.zip](https://github.com/FromAIToReality/OpenMicroDuck/releases/download/cad-ft-v2.1/STEP-changed-parts-FT-2026-09-30.zip) | 11.32 |
| v2.1 | [SolidWorks-FT2026-09-25.zip](https://github.com/FromAIToReality/OpenMicroDuck/releases/download/cad-ft-v2.1/SolidWorks-FT2026-09-25.zip) | 343.46 |

[SHA-256 校验清单](manifest.json)

飞特当前选择 v2.1，XL330 当前选择 v1.1；v2.0/v1.0 仅供历史对照。不可混用两款舵机的配合零件。

作者：机械行者Robo；原发布维护：fanhao375。CC BY-NC-SA 4.0。

[返回 CAD 页面](../README.md)
