FromAIToReality/OpenMicroDuck/tools/servo-web/README.md

# servo-web · 飞特舵机网页调试台

接上串口，浏览器里拖滑块让舵机动，3D 鸭子跟着转。给装机、校零、台架验收用，也是[飞特适配架构](https://github.com/fanhao375/microduck-replica/blob/a23f4c18a4741a3cde5257e639960ea37bbadd8d/software/%E9%A3%9E%E7%89%B9%E9%80%82%E9%85%8D%E6%9E%B6%E6%9E%84.md)台架清单 0–8 项的工具。

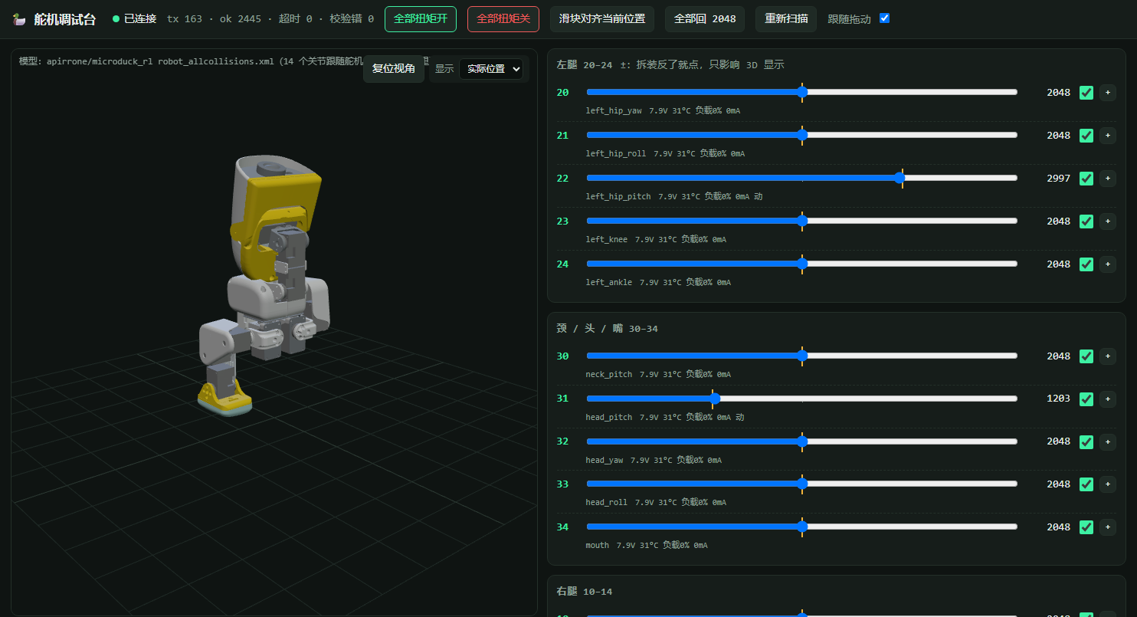
[picture p10: assets/servo-web.png]
界面


- 15 个滑块按左腿 / 头颈 / 右腿分组，黄线是舵机实际位置，每颗有扭矩开关。**开扭矩前先把目标对准当前位置**：扭矩关着时用手掰过关节、发过姿势或者校准过，目标寄存器里还是旧值，不对齐的话一开扭矩就冲过去；读不到位置的那颗不开
- 实时回读：位置、电压、温度、负载、电流、状态位（过流 / 过热 / 过载会标红）
- 3D 模型跟着实际位置动（用的是 [microduck_rl](https://github.com/apirrone/microduck_rl) 的 MuJoCo 模型，Apache-2.0）；每颗关节旁的 ± 是关节方向，存在 `directions.json` 里所有页面共用，3D、站姿、序列、灵动都按它换算，不动舵机；「复制 robotd 方向表」生成 `robotd.toml` 要的那行。实机逐颗核对过：15 颗全是反的（HD-1910 读数增大的方向跟 XL330 相反，装法照搬 XL330，所以整体反了一次）
- 姿态：把当前实际位置存成一个姿态，一键发回去；带 `steps` 的 JSON 是序列（自带「站起来」三步）。所有姿态 / 站姿 / 零位都按「过渡时间」从当前位置线性插过去，随时点「停」
- 一键校准（只给飞特做，XL330 没有这个功能）：把鸭子摆成「基准」的样子，一键把选中舵机「现在的位置」读数改成基准值。基准三种：
  - **零位 2048**：扭矩开着用滑块调到腿伸直、脚板垂直、头平视、嘴闭上，托住再点。存的姿态自动换算到新零点
  - **官方折叠（头颈摆正）**（推荐）：鸭子折好趴稳，不用悬空扶。膝折到踝刚好贴上大腿舵机（零件顶住，每次都一样），髋 pitch 用直角尺摆到跟躯干垂直，髋 yaw/roll、踝摆正，脖子竖直、头平视、嘴闭上。目标读数：腿按官方 FOLD 角度和 ± 算（± 全 −1 时 22/23 = 1025、12/13 = 3071），其余 2048；校完零点就是官方的 2048，存的姿态自动换算，15 颗一起标。头颈不按官方 FOLD 的 57°：那不是接触点，靠眼睛摆不准（见 [`tools/fold_contact`](https://github.com/fanhao375/microduck-replica/tree/a23f4c18a4741a3cde5257e639960ea37bbadd8d/tools/fold_contact)）。膝的目标按官方 1.57 rad（90.0°）算，官方几何里踝贴上大腿舵机是 89.6°，零点因此差约 0.36°（4 步）。扭矩关着用手摆就行，校完扭矩还是关着。选这个基准时 3D 自动叠加「校准用折叠」，照着摆
  - **存的姿态**（比如「缩」）：鸭子自己缩着放稳，靠机械接触定位，不用手扶。零位还是官方的 2048，官方代码和策略不用加 offset；别的姿态跟基准是同一套读数，不挪

  点按钮先弹确认框，逐颗列出「现在 → 写成、差几度」（服务端算的，跟真校准同一份）。**差 30° 以上的再确认一次，但不拦**：装舵盘时转了半圈就是差 180°，校准正好把它纠回来；方向 ± 设反了也会差 180° 左右（折叠时 ±90° 的关节），那样校进去是错的，所以提醒先核 ±（扭矩关着用手掰一点，看 3D 是不是往同一边转）。校完日志里把差得多的单独列出来。

  用 0x0B 位置校准指令（HD-1910 不认扭矩开关写 128，见下）。逐颗 解锁 → 读位置 → 关扭矩 → 0x0B → 读回 → 对上才改目标 → 扭矩复原 → 加锁；扭矩只关几毫秒，关节不会被重力压下去，也不会跳；没对上就原地不动报失败；中途出错也会加锁。原偏移备份在 `calib/`，可撤销（只挪回当次挪过的姿态）。收尾只放开速度和加速度（41、46），不再连目标 42 一起写
- 单颗操作：下拉选舵机（带关节名，离线的标出来），导出 0–86 全部寄存器（JSON / Markdown 表，做**寄存器底账**用）、重启 0x08、中位校准、改 ID（旧 ID 只列在线的，新 ID 列 15 个标准位、占用的标出来）、写寄存器（下拉带寄存器名，EEPROM 区自动勾解锁，写完回读核对）
- 串口原始收发全进日志文件（十六进制 + 寄存器名 + 舵机应答），排查飞特那些「回成功但没执行」的操作靠它
- 日志分 系统 / 总线 / 运动 / 校准 / 寄存器 / 姿态 / 方向 / IMU / 页面，警告、错误标色并计数，可按类筛选、只看警告错误、一键复制。每条同时写进 `logs/servo-web-日期.log`，出错的带 traceback；校准每颗一行：读数前后、偏移前后、每一步的应答。出问题把这个文件发过来就能查
- `sync_read` 时序测试：15 颗一次读 200 遍，报 min / avg / p99 / max 和失败数
- 舵机体检（命令行，**只读**）：`python servo_report.py --port COM5`，读出每颗的保护开关（卸载条件 19）、状态位、温度、电压、电流、偏移、角度限位，按《调试记录》第 5 步判红黄，存成 `logs/体检-时间.md` 和同名 `.json`（0–86 原值）。只接一颗用 `--ids 21`，不知道 ID 用 `--scan-all`。串口不能同时被调试台或 FD 占着
- 远程排查：[`远程排查交接.md`](远程排查交接.md) 是写给另一台电脑上的 Claude Code 的流程（体检 → 单颗排查 → 开保护 → 折叠校准），在那边说「先读 tools/servo-web/远程排查交接.md，按里面的流程带我做」
- 自检：`python selftest.py`，不接舵机。[`sim_bus.py`](sim_bus.py) 是协议级的 HD-1910 模拟器（按字节收发飞特包，模拟锁、扭矩、0x0B、HD-1910 不认 128、偏移、掉线），让真实的 `feetech.py` + `server.py` 把校准、撤销、改 ID、写寄存器、导出都跑一遍。改了跟舵机打交道的代码先跑它再上真机
- 后端不依赖飞特 SDK，[`feetech.py`](feetech.py) 直接按 2026 版协议手册发包（[`docs/飞特资料/`](https://github.com/fanhao375/microduck-replica/tree/a23f4c18a4741a3cde5257e639960ea37bbadd8d/docs/%E9%A3%9E%E7%89%B9%E8%B5%84%E6%96%99)），一百多行

## 跑起来

```bash
pip install -r requirements.txt
python server.py --port COM5                 # Windows + URT-2，串口号看设备管理器
python server.py --port /dev/ttyUSB0         # 板子上，URT-2 插板子的 USB 口
python server.py --port /dev/ttyS2           # 板子上走 40 脚的 UART2（要先接半双工转接，见下）
python server.py --fake                      # 没舵机：模拟模式，舵机是虚拟的
```

**模拟模式**（没接串口时）：虚拟舵机按真舵机的速度、加速度寄存器走梯形曲线，姿势、滑块、序列、灵动、官方姿势都会在 3D 里动，快慢跟真机一样；扭矩默认开，没有重力。右上「模拟」一栏能选 IMU：不接 / 接虚拟小板（假总线上的 ID 200，跟 `--imu-bus` 同一条路）/ 虚拟小板掉线（看调试台怎么把 200 出列、单独 PING、再接回来）。插上 USB 在顶栏选串口点「连接」就切到真舵机，这一栏自动藏起来，虚拟小板也跟着拔掉。

模拟里也能彩排一键校准和撤销：只改虚拟舵机，备份放系统临时目录，**不碰 `calib/` 和 `poses/`**（虚拟舵机的偏移要是混进 `calib/`，接上真舵机点「撤销」会写进真舵机）。存姿态、改 ± 是明确的操作，照常写文件。

串口打不开不会崩：页面照样开（假总线），顶栏会出现串口下拉，插好 USB 选一个点「连接」就接管，不用重启。

浏览器开 `http://127.0.0.1:8080`；在板子上跑就用板子 IP，手机也能开。默认管的 ID 是 `20-24,30-34,10-14`，别的用 `--ids`。3D 模型的文件在 `model/`，已经生成好；要重新生成：

```bash
python build_model.py --src <microduck_rl>/src/mjlab_microduck/robot/microduck
```

## 官方姿势：去那个姿势 / 3D 叠加对比

「官方姿势」一栏是 microduck_rl `scene.xml` 里的四个 keyframe：**零位**（全 2048）、**站**（STAND）、**坐**（SIT）、**折叠**（FOLD）。

- 「去」：按官方角度、每颗的 ± 和现在的零点换算成读数，照「过渡时间」走过去。**折叠发的时候膝只折 88°**：按精确网格算，官方几何里髋 90°、踝 0° 时膝折到 89.6° 踝就碰到大腿上的舵机，官方 90° 会让舵机顶着零件使劲（见 [`tools/fold_contact`](https://github.com/fanhao375/microduck-replica/tree/a23f4c18a4741a3cde5257e639960ea37bbadd8d/tools/fold_contact)）
- 「3D 叠加」：在 3D 里多画一只半透明蓝色的鸭子摆成官方姿势，下面逐关节列出「实际 − 官方」差多少度（>2° 黄、>5° 红）。鸭子摆成那个姿势时，差值就是零点偏了多少

## 可选：IMU 躯干姿态（舵机总线 / ST-Link / DAPLink / J-Link）

调试台可以在**同一个模型**上组合两种读数：舵机关节角继续驱动原有的关节，IMU 四元数驱动躯干姿态。沿用本服务、`/ws`、模型文件和 CDN，不启动第二个网页服务。不给 IMU 参数时隐藏该区域，原有串口功能照常。

适用已验证的 **STM32G031F8P6 + LSM6DSV16X 同款板**；J-Link 模式需要 Windows x64、Python 3.11+、自己安装的 SEGGER J-Link USB 驱动和 `JLink_x64.dll`。裸板固件与烧录步骤见 [`hardware/imu_to_dxl/firmware/`](../../hardware/imu_to_dxl/firmware/)，原理图和接线见[硬件目录](../../hardware/imu_to_dxl/)。J3.1 接 GND、J3.2 接 SWCLK、J3.3 接 SWDIO、**J3.6 接 VTref**；J3.4/5 是串口，不能接成电源参考。

1. 将 `imu-jlink.example.json` 复制为 `imu-jlink.json`，填写自己的 `dll` 和 `probe_serial`。文件已被 Git 忽略。
2. 让 Keil、J-Link Commander 等退出调试，释放探针；板上应已运行配套 HEX。
3. 在 `tools/servo-web/` 运行以下命令，浏览器仍打开 `http://127.0.0.1:8080`：

```bash
python server.py --port COM5 --imu-jlink imu-jlink.json  # 舵机串口 + 真 IMU
python server.py --fake --imu-jlink imu-jlink.json       # 只有 IMU 裸板，关节为演示值
python server.py --fake --imu-demo                       # 两者都是演示，不接硬件
```

JSON 中的路径相对于该配置文件；DLL 可使用 `E:/SEGGER/JLink/JLink_x64.dll` 这类完整路径，但必须改成自己的实际安装位置。`firmware` 可省略，默认使用仓库的 `hardware/imu_to_dxl/firmware/Build/imu_to_dxl.hex`；`hz` 为 1–20；`resume` 默认为 `false`。只在明确需要恢复暂停的 CPU 时设置 `resume: true`，也必须先通过固件校验。序列号没有默认值，不自动选择探针。

首次收到有效姿态时自动设显示零位，也可平放板子后点“归零”。安装方向默认绕 Y +90°（`DEFAULT_MOUNT`），按实物安装方向调整后重新归零。这些操作只影响网页，不写 IMU、舵机或 Flash。归零后的画面显示相对姿态；“原始姿态”也只是相对 IMU 启动参考。

### 最省事：`--imu-bus`，直接从舵机总线读

小板挂在舵机总线上（固件 0.2.0 起是飞特协议），**不用任何调试器**，URT-2 一根线舵机和 IMU 一起读：

```bash
python server.py --port COM5 --imu-bus      # 真总线：15 颗舵机 + ID 200
python server.py --fake --imu-bus           # 没硬件：假总线上挂一块假小板，看效果
```

- 发的是跟主控每 tick **同一条** sync_read：地址 56、长度 15、**ID 200 排第一**，后面跟舵机。舵机状态照旧解，200 的块按主控的判据解（全 0 四元数 = 融合没出数；norm² > 1.02 拒绝；12 字节连续 25 帧不变 = frozen；保留字节必须是 0；状态位 BIT1/BIT2 是板子自己报的故障），跟 `tools/imu200` 同一套。
- 规格里写了：板子不应答时，同一条 sync_read 里后面的舵机数据会跟着丢。所以 200 **连续 5 帧不应答就出列**，舵机单独读，每 2 秒单独 PING 一次 200，应答了再放回来 —— 没接小板时调试台照样能用，日志 IMU 分类里写明卡在哪。
- 只有网页连着的时候才轮询（跟舵机状态同一个循环）；校准期间停。台架上只接小板、扫描没扫到舵机也照样读 200。
- 调试台自己按 10 Hz 读，两次读之间块刷新了约 12 次，所以固件的 BIT3（「读得太慢」，给 50 Hz 的主控看的）每帧都会亮；这是调试台读得慢，不提示。原始状态位照样在帧里（`status_bits`）。
- 固件是 0.1.0（Dynamixel 协议）的板子不会应答，先按 [`firmware/`](../../hardware/imu_to_dxl/firmware/) 烧 0.2.0。

### 没有 J-Link：`--imu-swd`（ST-Link / DAPLink，经 pyOCD）

读法跟上面一样：先查目标电压，再逐字节比对板上 Flash，然后读同一块 RAM 快照，不烧写、不写内存。区别是走 [pyOCD](https://pyocd.io/)，**ST-Link、CMSIS-DAP（DAPLink）都能用**，不用配置文件。**J-Link 请用上面的 `--imu-jlink`**：经 pyOCD 连 J-Link 会默认从 19 脚供 5 V、可能静默升级探针固件，绕开了那条路的保护，所以 `--imu-swd` 会直接拒绝 J-Link。

```bash
pip install pyocd
python server.py --fake --imu-swd                           # 只插一个调试器：自动选
python server.py --fake --imu-swd 301612179216303030303032  # 插了多个：用 UID 指定（pyocd list 查）
python server.py --port COM5 --imu-swd                      # 舵机串口 + 真 IMU
```

- 接线同上：J3.1 GND、J3.2 SWCLK、J3.3 SWDIO、J3.6 接调试器的 **VTref / TVCC**（只测电压，不供电）。板子自己从总线口供电；调试器若有 3.3 V 输出脚（有的 ST-LINK/V2 是 19 脚），**别跟总线电源同时接**。
- ST-LINK/V2 的 20 针有不同版本：有的 4/6/8/10 脚是 GND，有的是 UART、BOOT0、SWIM。**GND 只用 12/18/20 脚**。
- 用 `attach` 模式连接：不复位、不暂停，断开时也不发 Go；不加载当前目录的 `pyocd.yaml` / 用户脚本。它仍会写调试寄存器（DHCSR.C_DEBUGEN 等），断开后 C_DEBUGEN 保持置位，所以不能算对目标零影响。实测（2026-09-22，ST-LINK/V2 V2J43S7，100 kHz）：连续连接 3 次，芯片计时跟墙钟对得上，**不会让板子重启**；刷新约 20 Hz，数据年龄 6–11 ms。
- 连芯片之前先查目标电压：只有 ST-Link 测得出来，不在 3.0–3.5 V 就拒绝（接近 0 V 会提示 VTref/TVCC 没接或板子没上电）；DAPLink 读不到电压，网页显示「—」，不拦。出错会分清是「调试器打不开」（被 Keil/CubeProgrammer 占用、ST-Link 固件太旧）还是「连不上芯片」（接线、供电）。
- 要回 Keil 或 CubeProgrammer，先停本服务，释放调试器。

连接、异常、状态变化和显示校准记入同一个 `logs/servo-web-日期.log`，分类为 **IMU**；数据不逐帧写日志。停止服务会释放调试器（J-Link / ST-Link / DAPLink）；要回 Keil 调试请先停止本服务，单独关闭浏览器标签不会释放探针。当前没有网页端探针重连或复位操作，连接异常处理完后重启服务。

### 固件校验与验证范围

- 只提交一份 `.hex`，不需要下载 `.bin` 或 `.map`。SWD / J-Link 后端校验 Intel HEX 记录和连续 Flash 镜像，解码后为 **10724 字节**（固件 0.2.0），SHA-256 为 `66bc7c532f5a1ad87e3dfff71a4b51f8c4f20840a8f62436874fa5b7c665938e`，RAM 布局 `sample=0x2000006C`、`tick=0x20000A34`。只有此镜像才使用已审核的 RAM 布局，连接后还会逐字节比对实际 Flash；不同固件拒绝读取姿态或恢复 CPU。
- 修改固件后先检查新的 MAP 中结构、地址及大小，再更新对应的已验证哈希和布局。不能只取消哈希校验。本工具不执行烧录。
- 此前 J-Link 9.78、SWD 100 kHz 实板读取约 20 Hz；SDK 建连曾导致板上程序重启，不能视为无扰动观察。当前整合版另做无硬件自检，**尚未验证真舵机与真 IMU 同时运行**，需上机核对轴向与长时间稳定性。
- **附带固件 0.2.0 已是飞特协议**（ID 200、地址 56 的 15 字节块），真协议代码在模拟总线上通过了 `imu200.py check`；但**真总线还没测**，SWD 画面正常也不代表真总线、`FeetechIo` 验收通过。上整机前跑 `imu200.py check --port`。
- 六轴 IMU 航向会漂移，网页不测平移、不判断真实脚底接触。重心和支撑区仍是模型几何估计，不能据此判定整机能够稳定站立或行走；断流时保留最后姿态并标记失效。

### 无硬件回归检查

```bash
pip install -r requirements-test.txt
python selftest.py
python -m pytest test_imu_bridge.py test_imu_server.py test_imu_swd.py test_imu_bus.py test_sim.py test_servo_report.py
node --test test_imu_attitude.cjs
```

Node.js 只用于前端数学测试，正常使用调试台不需要。固件主机测试与历史实板记录见 [VALIDATION.md](../../hardware/imu_to_dxl/firmware/VALIDATION.md)。

## 注意

- **URT-2 先插 USB，再给舵机上电。** 反了总线电平会卡在 2.1 V，扫描一颗都没有、只有广播能收到几个 0，见[踩坑记录](https://github.com/fanhao375/microduck-replica/blob/a23f4c18a4741a3cde5257e639960ea37bbadd8d/%E8%B8%A9%E5%9D%91%E8%AE%B0%E5%BD%95.md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工具)。
- **板子上用 ttyS2 前先 `sudo systemctl stop robotd`**。官方守护进程每秒都在开这个口找舵机，两边一起发会撞包。用 URT-2 走 ttyUSB0 没这个问题。
- **ttyS2 直接飞线到舵机是收不到应答的**。瑞莎的 UART 是全双工 3.3 V 两根线，飞特总线是单线半双工，中间要么三态缓冲（官方 HAT 的做法），要么拆一块 URT-2 的芯片方案。转接板做好以后先用页面上的时序测试看有没有回显：有回显会表现为全部"无应答"。
- 中位校准和改 ID 写 EEPROM，页面会弹确认。改 ID 时总线上只接那一颗。
- **HD-1910（固件 3.46）不认扭矩开关写 128**。内存表里写着能中位校准，实测 4 轮 15 颗：解锁、扭矩关着写 128，舵机回「成功」，偏移一个都没变。协议手册 4.9 的表里 HLS ≥3.43 也写着不支持。校准一律走 0x0B。
- "全部回 2048" 对扭矩开着的舵机是立刻执行的，装在腿上的先关扭矩或者一颗一颗来。
- 页面从 jsdelivr 加载 three.js，开页面的电脑要能上网；后端本身不需要。
- 嘴（ID 34）模型里没有这个关节，滑块能动舵机，3D 不显示。

## 版本

页面标题旁显示版本号。页面和服务的版本不一致时标红，并提示先重启 `server.py` 再 Ctrl+F5；这通常是浏览器还在用旧页面。改代码时 `server.py` 的 `VERSION` 和 `index.html` 的 `PAGE_VERSION` 一起加。

| 版本 | 日期 | 改了什么 |
|---|---|---|
| 0.15.1 | 2026-09-22 | 舵机体检 `servo_report.py`（只读，协议模拟器上验证过一个写指令都不发）；`远程排查交接.md`；校准确认框里踝的说法改成「脚板跟小腿成直角」（原来的「对齐」容易理解反） |
| 0.15.0 | 2026-09-22 | 按审查修（subagent 审的）：开扭矩前先把目标对准当前位置（扭矩关着校完、用手展开再开扭矩会甩回折叠）；校准收尾不再用回读的 67 重写目标 42；模拟里校准 / 撤销不碰 `calib/`、`poses/`；假总线的偏移按符号-幅值编码；接上真串口时拔掉模拟的虚拟 IMU，接 / 拔广播给所有页面。校准确认框逐颗列「现在 → 写成、差几度」，差 30° 以上再确认一次、不拦；3D 可叠加「校准用折叠」；零点没校准前别按「折叠」的提醒 |
| 0.14.0 | 2026-09-22 | 模拟模式：虚拟舵机按速度 / 加速度寄存器走梯形曲线（原来只有扭矩开着才一阶跟随），扭矩默认开，30 Hz 推状态；「模拟」一栏能随时接 / 拔虚拟 IMU 小板。3D 改成有变化才画（40 多万三角面一直按 60 帧画，点按钮半天才弹确认框）。一键校准加基准「官方折叠」：目标按官方 FOLD 角度 × ± 算，校完零点是官方 2048，存的姿态跟着换算；腿按官方折叠、头颈摆正，15 颗一起标 |
| 0.13.0 | 2026-09-22 | 「官方姿势」一栏：零位 / 站 / 坐 / 折叠四个按钮（官方 keyframe 按 ± 换算，折叠的膝少折 2° 不顶零件）；3D 叠加半透明的官方姿势，逐关节列「实际 − 官方」的角度差，用来看零点偏了多少 |
| 0.12.0 | 2026-09-22 | 可选 `--imu-bus`：直接从舵机总线读 IMU 小板，跟主控同一条 sync_read（地址 56、长度 15、200 排第一），按主控判据解块（未就绪、拒绝、frozen、保留字节、板子故障位）；200 连续 5 帧不应答就出列、每 2 秒单独 PING，没接小板时舵机照样读；`--fake --imu-bus` 有假小板可看效果。配套固件 0.2.0（飞特协议），SWD/J-Link 观察器的 HEX 哈希和 RAM 地址跟着更新 |
| 0.11.0 | 2026-09-22 | 可选 `--imu-swd`：经 pyOCD 用 ST-Link / DAPLink 读 IMU 姿态，不用 J-Link DLL 和配置文件（J-Link 仍走 `--imu-jlink`，`--imu-swd` 会拒绝它）。跟 J-Link 路径同一套保护：连芯片前先查电压、比对板上 Flash、只读 RAM、CPU 暂停不自动恢复；attach 模式连接，实测不会让板子重启。只插一个调试器时自动选，多个时要写 UID。ST-Link 顺带显示目标电压；pyOCD 的警告也记进 IMU 日志。网页标签显示实际调试器名 |
| 0.10.0 | 2026-09-21 | 可选 `--imu-jlink`：同一个 WebSocket、日志和 3D 模型组合舵机关节角与 IMU 躯干姿态；保留安装方向/显示归零，支持无硬件 `--imu-demo`，未启用 IMU 时原界面不变。配套固件与硬件资料放在一起，仓库只保留 HEX |
| 0.9.1 | 2026-09-20 | 串口原始收发进日志文件：每包发了什么、舵机回了什么，十六进制 + 寄存器名（`→ #32 位置校准 ff ff 20 02 0b f2` / `← #32 状态0x00 …`）。飞特不支持的操作照样回「成功」，只有对着原始字节才分得清「真做了」和「装作做了」。10 Hz 的状态轮询不记，不然日志全是它 |
| 0.9.0 | 2026-09-20 | 按代码审核重写校准（subagent 审出来的，全是"会把关节拉走"那一类）：判据从「读数等于目标」改成「偏移寄存器变没变」，因为飞特不支持的操作照样回成功；**重力下垂补偿** —— 关扭矩那几毫秒关节会掉（实测颈部 0.62 步/ms，而 USB 串口一个来回 1~16 ms），下垂量由「校准前读数、目标、偏移变化」算出来再补回去，16 ms 慢总线下零位误差从 99 步降到 0；关扭矩后回读确认（这包丢了会导致 0x0B 在扭矩开着时执行，偏移一改就满速拉）；目标位置永远写当前读数、绝不写目标值；出错也在 finally 里写目标、恢复扭矩、加锁；校准期间独占总线并压低加速度和速度；偏移符号方向开机探一次（±1 步）不再每颗试错；寄存器 31/42/46 改用符号-幅值编码（原来负数写成补码会被理解成 -32763 撞限位）；偏移量程收到 ±2047；撤销时校准后新存的姿态也跟着挪回；备份原子写、先落盘再挪姿态。模拟器加了重力下垂和总线延迟，这类 bug 现在测得出来 |
| 0.8.1 | 2026-09-20 | 串口打不开也把页面起起来（USB 没插、口号变了、被占用都不再崩），退到假总线并在日志里列出现有串口；顶栏加串口下拉和「连接」按钮，插好 USB 点一下就接管，不用重启服务 |
| 0.8.0 | 2026-09-20 | 校准从写 128 换成 0x0B 指令（HD-1910 实测不认 128，0.7.x 的「成功」其实是读数本来就接近 2048）；成功要读数真的变成目标；可以选存的姿态当基准（「缩」着校准）；扭矩只关几毫秒（0.7.x 关着等 30–130 ms，颈部被压下去 80 步）；撤销只挪当次挪过的姿态（0.7.x 撤销把之后新存的「站」「缩」反向挪了，已按日志恢复）；备份文件名带毫秒；单颗校准按基准走 |
| 0.7.3 | 2026-09-20 | 修 0.7.1 校准 15 颗全失败（`'_thread.lock' object is not callable`：串口互斥锁叫 `self.lock`，盖住了加 EEPROM 锁的 `lock()` 方法）；导出读到 86 为止（原来读到 90，真机回「short read」）；校准中途出错也加锁，出错不恢复扭矩；日志分类 + 写文件 + 筛选复制；单颗操作改下拉；协议级模拟器和自检 |
| 0.7.2 | 2026-09-20 | 姿态可以删除（× 按钮，挪进 `poses/.trash/` 能找回）；同名姿态按钮带日期 |
| 0.7.1 | 2026-09-20 | 修中位校准：0.7.0 在扭矩开着、锁着时写 128，舵机回"成功"但根本没校准，随后把目标写成 2048 反而把关节拉回旧零位。改成逐颗 解锁 → 关扭矩 → 写 128 → 读回确认 → 目标 → 扭矩复原 → 加锁；没校准成功就原地不动 |
| 0.7.0 | 2026-09-20 | 一键中位校准（全部或指定 ID）+ 撤销；顶栏在线数、刷新率、平均电压；每颗显示关节角度（借鉴群友的调试台）；方向 15 颗全反 |
| 0.6.0 | 2026-09-20 | 关节方向存到 `directions.json`，所有页面共用；实机核对 23、13、30–34 反向；「复制 robotd 方向表」；页面禁止浏览器缓存；版本号 |
| 0.5.0 | 2026-09-19 | 「灵动」头部动作；平滑运动改成不阻塞后端；修相位 BIT3=0 时速度寄存器写 0 等于停 |
| 0.4.0 | 2026-09-18 | 3D 里的重心投影和支撑区；平滑运动（舵机自己走梯形曲线）；目标位置回读核对、没到的重发 |
| 0.3.0 | 2026-09-18 | 姿态存取、「缩起来」「站姿」按钮、站起来 / 缩回去序列、过渡时间 |
| 0.2.0 | 2026-09-17 | 嘴的铰链、扭矩没开时的提示、官方站姿按钮、默认端口改 8080 |
| 0.1.0 | 2026-09-17 | 第一版：滑块、实时回读、3D 跟随、寄存器导出、时序测试、改 ID、中位校准 |

## 文件

| 文件 | 干什么 |
|---|---|
| `server.py` | HTTP + WebSocket 服务，starlette + uvicorn |
| `feetech.py` | 飞特协议：PING / READ / WRITE / SYNC_READ / SYNC_WRITE / REBOOT，寄存器名表 |
| `sim_bus.py` / `selftest.py` | 协议级舵机模拟器 / 后端自检 |
| `servo_report.py` / `test_servo_report.py` | 舵机体检（只读）/ 对着 `sim_bus` 的测试 |
| `远程排查交接.md` | 给另一台电脑上的 AI 的排查、校准流程 |
| `logs/` `calib/` | 运行日志、校准前的偏移备份，本机的，不进仓库 |
| `index.html` | 单文件前端，three.js 从 CDN 来 |
| `imu_bridge.py` / `test_imu_bridge.py` | J-Link / pyOCD 读取、固件验证、样本解码及无硬件测试 |
| `test_imu_swd.py` | `--imu-swd`（pyOCD）读取器测试：用假 pyocd 模块，不接探针 |
| `imu_bus.py` / `test_imu_bus.py` | `--imu-bus`：从舵机总线解 ID 200 的块、出列/重试、假小板；测试走真 `feetech.py` + `sim_bus` + `imu200.SimImu200` |
| `imu_attitude.js` / `test_imu_attitude.cjs` | IMU 四元数、安装方向与显示参考转换及回归测试 |
| `imu-jlink.example.json` / `test_imu_server.py` | 个人配置模板 / 现有服务的 IMU 整合测试 |
| `build_model.py` | MuJoCo XML + STL → `model/model.json` + `model/meshes.bin`（顶点 int16 量化，21 MB 变 2.9 MB） |
| `model/` | 生成好的模型，14 个关节 |
