FromAIToReality/OpenMicroDuck/docs/资料导航.md

# 机器鸭技术资料导航

本轮补齐的是 **fanhao375/microduck-replica 的技术参考**，不是把上游经历改写成我们的测试记录。固定提交 `a23f4c18a4741a3cde5257e639960ea37bbadd8d`。来源和逐文件校验值见 [补充导入清单](../provenance/reference-import-manifest.json)。

我们采用 ZERO 3W + HD1910，CAD 以飞特版为准。本文提供的旧版 XL330、官方 HAT 和不同电池方案只用于理解设计；不代表已选用或已购买。

## 1. 硬件入门与采购

- [我们已确认的硬件](hardware.md)：先看本项目边界。
- [上游硬件入门](硬件入门.md)、[硬件规格速查](硬件规格速查.md)、[执行器选型](执行器选型.md)。
- [整机 BOM](../BOM.md)、[机械采购清单](机械采购清单.md)、[电控采购清单](电控采购清单.md)。
- [螺丝与紧固件反推](紧固件反推.md)：属于上游分析，采购数量仍需按所用 CAD 复核。

## 2. 打印与装配

- [飞特 CAD 全套、3MF 和装配说明入口](../cad/README.md)。
- [七张装配视图／爆炸图](../assembly-drawings/)：原 Microduck 参考，不代替飞特版配合尺寸。
- [原作者构建日志](../构建日志.md)：包括实物图片，不能当作我们的装机照片。
- [孔位分析数据](hole_analysis.json)、[相关分析脚本](../scripts/)和 [STL 查看器](../tools/stl_viewer.html)。
- 未重新导入原版 XL330 的旧打印件及装配 STL，以免与我们选定的飞特 CAD 重复、混装。

## 3. 供电、接线与 IMU

- [不打 HAT 的接线参考](不打HAT.md)、[交互接线图](不打HAT-接线图.html)。这是备选参考，不是我们自研 HAT 的成品设计。
- [硬件方案逆向](硬件方案逆向.md)、[硬件原理图集](../assets/hw/)。
- [IMU 桥接说明](../hardware/imu_to_dxl/README.md)、[接线表](../hardware/imu_to_dxl/imu_to_dxl-接线表.md)、[总线协议](../hardware/imu_to_dxl/总线协议.md)。
- [上游 IMU PCB 工程、PDF 和 STEP](https://github.com/fanhao375/microduck-replica/tree/a23f4c18a4741a3cde5257e639960ea37bbadd8d/hardware/imu_to_dxl)：本地原版已有；本次不将许可边界尚待核实的独立设计文件重新发布，保留技术下载入口。不是本项目已验证可打板文件。

## 4. ZERO 3W 系统

- [瑞莎做卡工具说明](../tools/radxa/README.md)、[系统镜像使用说明](../tools/radxa/镜像使用说明.md)。
- 脚本和 `card.conf` 已放入仓库，**本轮没有运行烧卡、刷机或镜像修改脚本**。
- 核对板卡版本和 Wi-Fi 芯片；示例 `duck1234` 是公开默认密码，使用前必须更改。不要上传自己的 Wi-Fi 密码或配置。
- 大型系统镜像仍使用上游说明中的 Release 下载链接，不重复塞入 Git。

## 5. 飞特协议与舵机调试

- [飞特资料索引](飞特资料/README.md)、[SCS 通信协议](飞特资料/SCS通信协议-v1.0-2026-06-09.md)。
- [STS 内存表](飞特资料/磁编码STS内存表手册-v1.1-2026-08-27.md)、[SMS 内存表](飞特资料/磁编码SMS内存表手册-v1.1-2026-08-27.md)：不同协议和型号不要混用。
- [网页调试工具](../tools/servo-web/README.md)、[我们的模拟测试结果](release-validation.md)。
- [HD1910 Rust 工具](../tools/FeeTech_HD1910M_Servo/README.md)、[教程](../tools/FeeTech_HD1910M_Servo/TUTORIAL.md)、[STS 测试工具](../tools/sts3215Servo_testtool/README.md)。新增工具仅导入源码，未在本机编译或连接实机。
- [折叠接触分析](../tools/fold_contact/README.md)、[上游调试记录](../调试记录.md)、[踩坑记录](../踩坑记录.md)。
- [飞特官方 Windows 工具原始来源](https://gitee.com/ftservo/fddebug)：macOS 用户不能直接运行 Windows 程序；本轮不导入安装器。

## 6. 适配与训练

- [飞特运行时适配架构](../software/飞特适配架构.md)、[上游软件说明](../software/README.md)。
- [训练前数据清单](HD-1910训练前数据清单.md)、[M6 参数来源](HD-1910-M6参数来源.md)。
- [已导入的 HD1910 训练基线](../software/training/README.md)。

## 本轮取舍

导入采购、接线、协议、系统、装配与调试资料和对应图片。没有导入上游加群二维码、社区动态、推广段落、原作者 AI 工作计划、Windows 安装包或 XL330 重复模型。2026-10-11 已撤下首页旧群二维码；CAD 资料已更新并清理推广入口。

技术文档保留上游内容并增加参考提示、修正链接；尚未逐项复核采购价格、供应商信息、电气设计或硬件可用性。上传资料不代表建议立即购买或按图通电。
