FromAIToReality/OpenMicroDuck/docs/执行器选型.md

> **上游技术参考，不是本项目实测结论。** 来源：[fanhao375/microduck-replica](https://github.com/fanhao375/microduck-replica/blob/a23f4c18a4741a3cde5257e639960ea37bbadd8d/docs/%E6%89%A7%E8%A1%8C%E5%99%A8%E9%80%89%E5%9E%8B.md)。保留原作者及贡献者署名；正文中的“本项目”、实物、照片和测试记录属于上游。与我们的硬件不一致时，以[本项目说明](hardware.md)为准。

# 执行器选型与参数

> 🔌 舵机总线的协议对照（含飞特 STS/SCS 与 HD-1910 规格）见 [硬件方案逆向](硬件方案逆向.md)。

**简体中文** · [English](actuator-selection.en.md)

## 电机：Dynamixel XL330，整机 15 个

| | |
|---|---|
| 型号 | **Dynamixel XL330-M288-T**（证据见下） |
| 数量 | **15 个**（`xl330` 网格在整机 MJCF 中被引用 15 次） |
| 受控 | **14 个**进策略动作空间：左腿 5 + 颈头 4 + 右腿 5 |
| 第 15 个 | 驱动喙 / 下颚，走 `passive_*` 连杆，**不进动作空间** |
| 安装 | M2 螺丝（本体 Ø2.0×4 过孔 + Ø1.6×8 攻丝孔） |
| 供电 | ⚠️ **舵机额定 3.7–6.0 V，实际总线 6.6–8.2 V —— 超压运行**，见下节 |

## ⚠️ 电压真相：XL330 被超压运行

> **勘误（2026-09-04）**：本文此前把 XL330 写成「标称 7.4V 级舵机」。**这是错的**，
> 而且它连带影响了下面对飞特 STS3032 的否决理由和力矩对比结论。

**Robotis 官方规格**（[XL330-M288-T e-manual](https://emanual.robotis.com/docs/en/dxl/x/xl330-m288/)，2026-09-04 核）：

| 项目 | 官方值 |
|---|---|
| 输入电压 | **3.7 – 6.0 V** |
| 推荐电压 | **5.0 V** |
| 堵转力矩 | 0.42 N·m @3.7 V ／ **0.52 N·m @5.0 V** ／ 0.60 N·m @6.0 V |
| 减速比 | 288.4 : 1 |
| 尺寸 / 重量 | 20 × 34 × 26 mm ／ 18 g |

**而 Microduck 实际给舵机的电压是 6.6 – 8.2 V**，三处源码互相印证：

| 来源 | 值 |
|---|---|
| `microduck_constants.py` 的 BAM 配置 | `vin_range=(6.5, 8.2)`、`vin_min=6.0` |
| `robotd` 电压自适应 | 钳位 **6.0 – 9.5 V** |
| 电池 | NP-F550 为 2S 锂电，标称 7.4 V，满电 8.4 V |

#### 直接证据：官方 HAT 原理图

有人会问「XL330 不是 5 V 输入吗，哪来的超压」。5 V 是 **ROBOTIS 数据手册的推荐值**，
不是 Microduck 的实际接法。官方 HAT 是开源的（`pollen-robotics/elec_RPI_Robot_HAT`，
Apache-2.0），原理图第 4/6 页 `dynamixel.kicad_sch` 写得很清楚：

| 电路 | 实际连接 |
|---|---|
| 三个 Dynamixel 接口 J11 / J13 / J14 | 电源脚接 **`+BATT`**（电池原电压），图上标注 `3A max`，串 TH1 100R 热敏保护 |
| `+BATT` 到舵机之间 | **没有任何降压** —— J13/J14 经 TH1 100R 热敏、J3/J11 直连。<br>（U10 LM5050-1 理想二极管在 buck **之后**的 `+5V` 那一路，不是电池输入端） |
| 板上唯一的降压 | **U9 AP63205** + **L4 6.8 µH**（Fsw 1.1 MHz，2 A）→ 输出 `+5V` |
| `+5V` 去哪 | **树莓派 40 针排针 J4**、音频功放 PAM8406D、EEPROM —— 原理图旁边就附着树莓派功耗表（Pi 5: 9–10 W／Pi 4B: 6–7.6 W／Pi Zero 2W: 1.5 W） |

**整张 HAT BOM（47 行）里只有一颗 buck、一个电感。** 没有第二路降压。
也就是说 5 V 那一路是**给树莓派的**，舵机直接挂在电池上 —— 2 A 的 AP63205
本来也带不动 15 个 XL330（单个堵转就约 1.5 A）。

**结论：Pollen 让 XL330 长期工作在其额定上限（6.0 V）之上，最高约 8.2 V。**

### 这意味着什么

- ✅ **力矩比官方标称更大** —— 堵转力矩随电压近似线性上升，8 V 下会明显高于 0.52 N·m。
  这大概是他们敢用 18 g 舵机扛 800 g 整机的原因之一。
- ⚠️ **寿命与发热是代价** —— 超压运行对绕组和 MOSFET 都是额外负担。官方从未公开
  这方面的数据，**以下为推断**：这可能与社区反馈的舵机发热、以及官方开始考虑
  卖维修包有关（见 [社区动态](https://github.com/fanhao375/microduck-replica/blob/a23f4c18a4741a3cde5257e639960ea37bbadd8d/docs/%E7%A4%BE%E5%8C%BA%E5%8A%A8%E6%80%81.md)）。
- ⚠️ **复刻时你要自己做这个决定**。照抄 = 同样超压；想稳妥就加一级降压到 5–6 V，
  代价是力矩下降，**可能需要重训策略**（官方 ONNX 是在超压条件下训出来的）。

> 这也解释了为什么固件里有「电压自适应」：`scale × (7.4 / 实测EMA)`。
> 电池从 8.4 V 掉到 6.5 V 的过程中，同样的 PWM 输出的力矩差很多，
> 不做补偿的话策略在电量不同时表现会飘。

---

## 关节行程

| 关节 | 行程 | 弧度 |
|---|---|---|
| `hip_yaw` | -25° ~ +30° | -0.436 ~ 0.524 |
| `hip_roll` | ±22° | ±0.384 |
| `hip_pitch` / `knee` / `ankle` / `head_pitch` | ±90° | ±1.571 |
| `neck_pitch` | -90° ~ +60° | -1.571 ~ 1.047 |
| `head_yaw` | ±170° | ±2.967 |
| `head_roll` | ±25° | ±0.436 |

> 右腿 `hip_yaw` 是左腿的镜像：-30° ~ +25°。

## BAM M6 执行器配置（当前使用）

来自 `robot/microduck_constants.py`：

```python
_BAM_ACTUATOR_KWARGS = dict(
    motor_name="xl330",
    model="m6",
    target_names_expr=(r"^(?!passive_).*",),   # 排除被动关节
    kp_fw=200.0,             # 固件位置环刚度（microduck 保留 200，microban 用 125）
    vin_range=(6.5, 8.2),    # 每个环境启动时采样的电池电压
    vin_drop_gain_range=(0.0, 0.2),   # 负载压降 V_drop = gain * sum(|tau|)
    vin_min=6.0,             # 压降后的电压硬下限
    delay_min_lag=3,         # 指令延迟（控制步）
    delay_max_lag=6,
)
```

BAM M6 是**电压级**模型：不是简单 PD，而是模拟固件 PD → PWM → 电压 → 电流 → 力矩的完整链路，
再叠加负载相关的摩擦（库仑 + Stribeck + 载荷项）。这是 sim2real 的核心。

### 三个关键的域随机化

| 项目 | 范围 | 物理含义 |
|---|---|---|
| `vin_range` | 6.5 – 8.2 V | 电池从满电到亏电的全过程 |
| `vin_drop_gain_range` | 0.0 – 0.2 | **负载压降** —— 多个舵机同时出力时母线电压跌落 |
| `delay_min/max_lag` | 3 – 6 步 | 指令到执行的通信+固件延迟 |

`actuator/friction_dr_bam.py` 额外加了 **per-env `friction_scale`**，
只缩放**与速度无关**的摩擦预算（静摩擦 / 齿轮箱），黏性项保持标称 ——
因为静摩擦才是 sim2real 不确定性的主要来源。

### 齿轮回差建模

`BacklashEncoderBamActuator` 复现了一个真实但容易被忽略的细节：

> 真实舵机的磁编码器装在齿轮间隙的**输出侧**，所以固件位置环闭环在
> `主关节角 + 回差角` 上。舵机在死区里空转时，**测到的位置不变，PD 误差也不变**。

实现上把 `cmd.pos` 改成 `qpos[main] + qpos[backlash]`。
速度 `cmd.vel` 故意保持电机侧 —— 它驱动反电动势和摩擦，那是转子物理量，不是编码器信号。

回差模型见 `robot_allcollisions_backlash.xml`，每个舵机串一个
`passive_<joint>_backlash` 被动铰链。

## 五组标定过的 MuJoCo 原生 PD 参数（备用）

`joints_properties.xml` 里留了 5 组，都是 BAM 实测标定的结果。
**如果你不用 BAM 而用 MuJoCo 内置 PD，直接抄这些数**：

| class | damping | frictionloss | armature | kp | forcerange (N·m) |
|---|---|---|---|---|---|
| `chosen_actuator` ⭐ | 0.053 | 0.0048 | 0.0018 | 0.55 | ±0.96 |
| `chosen_actuator_antoine` | 0.044 | 0.013 | 0.0017 | 0.43 | ±0.75 |
| `chosen_actuator_old` | 0.048 | 0.006 | 0.002 | 0.52 | ±0.91 |
| `chosen_actuator_new` | 0.041 | 0.032 | 0.002 | 0.386 | ±0.67 |
| `perfect_actuator` | 0.15 | 0.1 | 0.001 | 10.0 | ±20.0 |

⭐ = 当前默认（注释标注 "marc"）。`ctrlrange` 统一 ±10.0。
`perfect_actuator` 是理想电机，仅用于对照，**不要拿它训练要上真机的策略**。

被动关节：`passive_wheel` / `passive_joint` —— damping 0，frictionloss 0，armature 0.0001。

## 为什么是 XL330：一切都由重量预算决定

XL330 不是因为「力气大」被选中的，是因为**在 18 g 里塞下了一整套东西**：

```
电机 + 288:1 减速箱 + 编码器 + 驱动器 + 位置环 + 总线接口  =  18 g
```

整机才 737 g，15 个舵机就占 270 g（37%）。这个盒子里放不下别的方案。

### 力矩从哪来：减速箱，不是电机

### 型号是怎么定下来的

官方从未在任何公开材料里点过具体子型号 —— 源码里只有 `motor_name="xl330"`，**没有后缀**。
但有一条独立证据链可以定到 **M288-T**：

1. `microduck_rl` 的仿真用 **BAM** 执行器模型，配置是
   `motor_name="xl330"`, `model="m6"`（`microduck_constants.py`），
   加载 `bam/params/xl330/m6.json`
2. BAM 出自 [`Rhoban/bam`](https://github.com/Rhoban/bam)，其 README 的
   「**已辨识模型库**」列表里，这颗舵机的条目写的是
   **`Dynamixel XL330-M288-T`**
3. 也就是说，**训练策略所依据的摩擦模型，是在一颗实物 XL330-M288-T 上台架辨识出来的**

旁证：2026-09-03，韩国机器人行业观察者 [@Allyakutaku](https://x.com/Allyakutaku/status/2095331280233926948)
称从官方视频中辨认出的电机型号为 XL330-M288-T。

> ⚠️ 严格说，上述证据直接证明的是**仿真标定所用的舵机**是 M288-T。
> 实物用同型号是极强推断，但**不是 Pollen 的官方声明**。

型号里的 **288 就是减速比 288.35:1**（同系列还有 M077，77.9:1）。

里面那颗空心杯电机本身只能出几个 **毫**牛·米，靠 288:1 放大到
MJCF 里标定的 **±0.96 N·m**（约 9.8 kg·cm）。

**代价直接写在模型里**：减速比越大回差越明显 —— 所以 `robot_allcollisions_backlash.xml`
给每个关节串了 `passive_*_backlash` 被动铰链，建模 **±1.0°** 的齿轮间隙。

---

## 为什么不能用闭环步进

这是个常见的想法，在**静态定位**场景（CNC、3D 打印机）确实合理，
但足式机器人上有几条硬伤：

### 1. 重量 —— 直接判死刑

| | 单个重量 | 含什么 |
|---|---|---|
| **XL330** | **18 g** | 电机 + 减速箱 + 编码器 + 驱动器 + 控制环 + 总线，**全在里面** |
| NEMA 8 步进 | ~60 g | **裸电机**，不含编码器、驱动器、减速箱 |

15 个裸 NEMA 8 就 900 g —— **光电机超过整机总重（737 g）**，还没算外围。

### 2. 保持功耗

步进保持位置**必须持续通额定电流**。双足站立时 15 个关节都要持续出力矩，
而电池只有 2600 mAh 2S、续航约 1 小时。

舵机是位置闭环，**误差小、负载轻时电流接近零**。站着几乎不耗电。

顺带还有热：15 个步进在 25 cm 密闭塑料壳里持续通额定电流，散不掉。

### 3. ⭐ 反驱性 —— 最关键，也最容易被忽略

足式机器人**必须能吸收冲击**。看官方 `robotd.toml` 里的 `limp_fall`：

> 检测到要摔倒时，**把增益从 200 降到 `gain_limp = 50`**，
> 让关节「顺着外力走而不是跟地板较劲」，软着陆之后再用 600 ms 拉回站姿。

**步进做不到这件事。** 它只有两个状态 —— 通电锁死、断电自由转（断电还有齿槽力矩），
**中间没有可调阻抗**。

闭环步进能纠正丢步，但那是**事后恢复**，不是**实时柔顺**。
落脚冲击的瞬间需要的是顺从，不是一次纠偏瞬态。

整套 sim2real 配方（BAM 模型、`kp_fw=200`、增益梯度、软着陆）建立在
**「舵机是一个刚度可调的弹簧」** 这个前提上。步进不是弹簧，是位置锁。

### 4. 布线

15 个舵机 = **一条 3 线菊花链**。
15 个步进 = 15×4 相线 + 15 根编码器线 + 15 个驱动板。
在 25 cm 的身体里、脖子还要转 —— 塞不进去。

### 5. 市面上没有这个规格

18 g、288:1 减速箱、集成编码器与驱动器、总线菊花链 —— **这个东西不存在**。

---

## 换成飞特 STS3215 会怎样

STS3215（深圳飞特）单价约 **¥60–70**，是 XL330（约 ¥299）的**五分之一**，
而且 **力矩还更大**（1.86 N·m vs 0.96 N·m）。看起来是显然的降本方案。

**但它重 3 倍（约 55–60 g vs 18 g）。** 下面是实测后果。

### 硬数据：同架构、换舵机，整机质量变化

两边都是 15 个刚体的双足机器鸭，MJCF 里的质量总和：

| | 舵机 | **整机质量** | 身高 |
|---|---|---|---|
| **Microduck** | XL330 | **737.2 g** | 25 cm |
| **Open Duck Mini v2** | STS3215 | **2107.1 g** | 42 cm |

**2.86 倍。**

> 💡 **Open Duck Mini v2 就是「STS3215 版的答案」。**
> 同一个工程师（Antoine Pirrone，Pollen R&D）、同样的双足鸭架构 ——
> 换了舵机之后，整台机器人只能做成 42 cm、2.1 kg。

### 执行器参数：每一项都差一个数量级

| 参数 | XL330 (`chosen_actuator`) | STS3215 (`sts3215`) | 差距 |
|---|---|---|---|
| **kp** | 0.55 | **17.8** | **32×** |
| **forcerange** | ±0.96 N·m | **±3.35 N·m** | **3.5×** |
| **damping** | 0.053 | **0.60** | **11×** |
| **frictionloss** | 0.0048 | **0.052** | **11×** |
| **armature** | 0.0018 | **0.028** | **15.5×** |
| 回差建模 | **±1.0°** | ±0.5° | — |

> 数据来源：`microduck_rl/.../joints_properties.xml` 与
> `Open_Duck_Playground/playground/open_duck_mini_v2/xmls/joints_properties.xml`
>
> 📌 反直觉的一点：**XL330 建模的回差反而更大**（±1° vs ±0.5°）。
> 可能是两个项目的建模口径不同，也可能是 288:1 高减速比的代价。

**这不是微调，是两种完全不同的执行器。**

### 不改机械件能换吗：不能

| 约束 | 说明 |
|---|---|
| **尺寸** | XL330 实测外形 **29 × 20 × 34 mm**（量自 `xl330.stl`）。机械件的舵机腔按此挖出，STS3215 是明显更大的一档，塞不进去 |
| **安装接口** | 舵机盘螺孔分度圆、输出轴规格、外壳固定孔位全不同 —— 本仓库反推的那套 M2 孔位（Ø2.2 过孔 + Ø4.4 沉孔）是照 XL330 的 |
| **质量预算** | 15 × (57−18) ≈ **多出 585 g**，还不算为承重而加粗的结构件。737 g 的机器人加 585 g，重心、关节力矩需求、结构强度全部推倒 |

**这不是「换个舵机」，是「换一台机器人」。**

### 会失效的 / 能保留的

| 失效 | 保留 |
|---|---|
| ❌ 官方 9 个 ONNX 策略 | ✅ **61 维观测契约 + 14 维动作** |
| ❌ BAM M6 标定（给 XL330 做的辨识） | ✅ 训练框架（microduck_rl / Playground） |
| ❌ 上文 5 组 `chosen_actuator` 参数 | ✅ sim2real 方法论（BAM 辨识、域随机化、回差建模） |
| ❌ 回差模型（要重测） | |
| ❌ MJCF 质量惯量（全部重算） | |
| ❌ 通信协议（飞特 SCS/STS，非 Dynamixel V2） | |

> **通信这条有个好消息**：Open Duck Mini 用的是 `rustypot.feetech(port, 1000000)` ——
> **同一个 `rustypot` 库，只是换协议模块**，波特率同样 1 Mbps。
> 所以 Rust 运行时里换掉 `Xl330Controller` 是可行的，不必重写通信层。

**要改的是「机器人模型」和「执行器模型」，不是算法本身。**

---

## 同级别舵机横向对比：那个空档为什么还没被填上

「有没有更便宜的 XL330」是最常被问的问题。答案是：**同重量级的确实存在，
但没有一个能同时满足力矩和电压。**

| 型号 | 重量 | 尺寸 (mm) | 堵转力矩 | 电压 | 编码器 | 减速比 |
|---|---|---|---|---|---|---|
| **Dynamixel XL330-M288-T** ⭐ | **18 g** | **20 × 34 × 26** | **0.52 N·m @5 V**<br>0.60 @6 V / 0.42 @3.7 V | **3.7–6.0 V**<br>推荐 5 V | 12-bit | 288.4:1 |
| **飞特 STS3032** | 20 g | **23.2 × 12.1 × 28.5** | 0.44 N·m<br>(4.5 kg·cm @6V) | **4.8–6 V** | 12-bit | — |
| **飞特 SCS0009** | **11 g** | — | 0.23 N·m<br>(2.3 kg·cm) | 6 V | 10-bit | 1:416 金属齿轮 |
| 飞特 STS3215 | ~55–60 g | 大一档 | 1.86 N·m<br>(19 kg·cm) | 7.4 V | 12-bit | — |
| Dynamixel XL330-M077 | 18 g | 同 M288 | 低（高速版） | 同 M288 | 12-bit | 77.9:1 |
| **宇树 S288** ⭐ | **19.5 g** | **34 × 20 × 23** | **存疑（见下）** | **12.6 V** | **15-bit 双编码器<br>+ 输出端编码器** | **288.35:1** |
| 宇树 J288 | 35 g | 34 × 20 × 23 | 存疑（金属齿轮版） | 25.2 V | 同 S288 | 288.35:1 |

> **本表统一用厂商标称堵转力矩**（2026-09-04 核自各家官网），可以横向比。
>
> 本仓库 MJCF 里那个 `forcerange = ±0.96` 是 **MuJoCo 的仿真力限，不是厂商值**，
> 已从本表移出 —— 此前版本拿它和别家的堵转值并排比较，是错的。
>
> XL330 尺寸以 Robotis 官方 20×34×26 mm 为准；量自 `xl330.stl` 的 29×20×34
> 包含舵盘和线座，比本体大。
> 尺寸量自 `xl330.stl`。
> 其余为厂商公开规格。**价格因地区差异极大，此处不列** ——
> 同一颗 STS3032 在印度进口零售约 ₹3,451，在国内是完全不同的价位。

### ⭐ 宇树 S288：唯一一个全面对标 XL330 的产品

2026 年出现的新选项。**机械参数几乎逐项对上 XL330**，连型号里的 "288" 都一样：

| | XL330-M288 | 宇树 S288 | |
|---|---|---|---|
| 重量 | 18 g | **19.5 g** | ✅ |
| 尺寸 | 20 × 34 × 26 mm | **34 × 20 × 23 mm** | ✅ |
| **减速比** | **288.35:1** | **288.35:1** | ✅ **完全相同** |
| 固定螺丝 | M2 | **M2** | ✅ |
| 总线物理层 | 单线半双工 TTL | **单线半双工 TTL (1-Wire)** | ✅ |
| 波特率 | 1 Mbps | **6 Mbps** | ⬆️ 6× |
| 电机 | 有刷空心杯 | **无刷 FOC** | ⬆️ |
| 编码器 | 12-bit，转子侧 | **15-bit 双编码器 + 输出端编码器** | ⬆️⬆️ |
| 控制方式 | 位置环 + kp | **力矩前馈 + 可调刚度/阻尼** | ⬆️⬆️ |
| **电压** | ~7.4 V (2S) | **12.6 V (3S)** | ⚠️ **不兼容** |
| **总线容量** | 253 个地址 | **15 个（0~14，15 为广播）** | ⚠️ |
| 力矩 | **0.96 N·m** | **存疑** | ⚠️ |

> S288 的尺寸、接口、协议与控制方式均取自官方
> [《无刷数字舵机 J288/S288 使用手册》](https://www.unitree.com/images/%E6%97%A0%E5%88%B7%E6%95%B0%E5%AD%97%E8%88%B5%E6%9C%BAJ288S288%E4%BD%BF%E7%94%A8%E6%89%8B%E5%86%8C.pdf)（11 页，已通读）；
> 重量、电压、编码器位数取自[官网产品页](https://www.unitree.com/cn/DigitalServo/)。

#### 两个实质升级

**1. 阻抗控制，不是位置伺服**

手册给出的混合控制律：

```
τ = τ_ff + k_p × (p_des − p) + k_d × (ω_des − ω)
```

**力矩前馈 + 可调刚度 + 可调阻尼**，底层是 FOC 闭环。

Microduck 的 `limp_fall` 靠把 kp 从 200 降到 50 换取柔顺 —— 用 S288 可以**直接给力矩前馈**，
比调增益干净得多，而且这正是足式机器人真正需要的关节力控。

**2. 有输出端编码器 —— 直接消灭回差问题**

返回数据结构里有 `uint16_t OutPos : 13`（输出端传感器，2^13 表示 1 圈）。

XL330 的编码器在**转子侧**，齿轮间隙测不到 —— 所以 `microduck_rl` 才必须
建 `passive_*_backlash` 被动铰链，还要在仿真里复现「固件位置环透过回差读数」
这个细节（见上文 `BacklashEncoderBamActuator`）。

**S288 直接测真实关节角，这一整套复杂度可以省掉。**

反馈还包括壳体温度、绕组温度、舵机端电压、转子扭矩/速度/位置，以及 22 位故障码
（过流、过压、欠压、芯片/MOS/壳体/绕组过热、三路编码器错误……）。比 XL330 丰富得多。

#### 三个硬约束

**① 电压 12.6 V vs 7.4 V**
Microduck 是 2S（NP-F550），S288 要 **3S**。电池、供电、HAT 全要重做。

**② 总线只能挂 15 个舵机**
地址空间 **0~14**（15 为广播）。Microduck 正好 15 个舵机 —— **刚好用满**，
但它总线上还挂着 **IMU 板（ID 200）**。
**S288 方案下 IMU 必须另走 SPI/I2C。**

> 这与本仓库在 [硬件方案逆向](硬件方案逆向.md) 中给出的建议一致：
> 把 IMU 从舵机总线挪到主控 SPI，可靠性反而更好。

**③ ⚠️ 力矩数据存疑 —— 这是决定性参数，尚未解决**

官网标 S288 堵转扭矩「同向 **0.07 N·m** / 反向 **0.2 N·m**」，但手册明确写：

> 「协议中的所有参数均为**转子端**数据，减速比为 288.35，
> 若需将转子数据换算为输出端数据，则需乘以或除以该减速比。」

两种解读都说不通：

| 解读 | 输出端力矩 | 判断 |
|---|---|---|
| 那两个数是**转子端** | 20 / 58 N·m | ❌ 19.5 g 的舵机不可能 |
| 那两个数是**输出端** | 0.2 N·m | ❌ 只有 XL330（0.96）的 1/5，不构成平替 |

**必须向宇树确认或实测。** 建议问清楚这四点：

1. 「堵转扭矩」标的是**转子端**还是**输出端**？
2. 「同向 / 反向」具体指什么（正反转？还是驱动 / 反驱？）
3. **输出端**的额定持续力矩和峰值力矩各是多少？
4. 12.6 V 是额定还是上限？能否降压到 7.4 V 使用（力矩会掉多少）？

> 旁证推测：J288 是 35 g 金属齿轮版，标 0.5 / 1.5 N·m。若 1.5 为输出端，
> 对 35 g 无刷 + 288:1 是合理的，还强过 XL330。按比例外推 S288 输出端可能在
> 0.5 N·m 上下 —— **但这只是推测，不可据此决策。**

#### 结论：机械像平替，电气和协议不是

| | |
|---|---|
| ✅ **机械** | 尺寸、重量、减速比、M2 孔位高度对应，机械件可能不用大改 |
| ⚠️ **电气** | 12.6 V vs 7.4 V，电池和供电系统要重做 |
| ❌ **协议** | 宇树自定义 20 字节命令 / 26 字节返回 + CRC32 @ 6 Mbps，与 Dynamixel Protocol V2 完全不同；`rustypot` 不支持，通信层要重写 |
| ❌ **策略** | 官方 9 个 ONNX 作废 —— 力矩特性与控制模式都变了 |
| ✅ **换来的** | 关节力控、输出端编码器、6 Mbps 总线、丰富的温度与故障反馈 |

**如果力矩问题能确认过关，这是目前唯一值得认真评估的 XL330 替代方案。**

### STS3032：尺寸合格，力矩和电压不合格

这是最接近的候选：**比 XL330 还小**（23.2×12.1×28.5 vs 29×20×34），
重量几乎一样（20 g vs 18 g），12-bit 编码器同级，半双工总线同架构。

**但两个问题 —— 注意，此前本文对这两条的判断都过重了：**

1. **力矩约为 85%，不是 46%** —— 同电压口径下 0.44 N·m @6 V vs XL330 0.52 N·m @5 V。
   此前写的 46% 是拿 0.44 去比仿真力限 0.96，两个量不可比。
2. **电压上限 6 V —— 但 XL330 的上限同样是 6 V。**
   区别不在舵机规格，而在 **Pollen 选择了超压运行**（见上节）。
   要照搬 STS3032，要么同样超压（风险自负），要么加一级降压到 5 V。

### 能不能混搭

| 关节组 | 数量 | 力矩需求 | STS3032 够不够 |
|---|---|---|---|
| 腿（髋 yaw/roll/pitch、膝、踝） | 10 | 高 —— 要支撑 737 g 整机并吸收落地冲击 | ❌ **不够** |
| 颈 / 头（pitch、yaw、roll） | 4 | 中 —— 驱动 189 g 头部总成 | ⚠️ 可能够 |
| 嘴 | 1 | 低 | ✅ 够 |

**混搭在理论上可行，全换不行。** 但混搭要解决 7.4 V → 6 V 的降压，
而且两种舵机的 BAM 参数、回差、响应延迟都不同 —— 训练时要按关节分组建模，
复杂度上升不少。

### 一个旁证：Pollen 自己就在用飞特

**SCS0009 用在 Pollen 的 [Amazing Hand](https://github.com/pollen-robotics/AmazingHand)
和 HopeJR 上。**

说明他们**不是不知道便宜方案，是 Microduck 的腿真的需要那个力矩** ——
手指关节 0.23 N·m 够用，双足机器人的膝盖不够。

### 空档在哪

```
需求：18–20 g · ≥0.5 N·m @额定 · 能耐 2S 直供或自带降压 · 总线菊花链 · 集成编码器与驱动器
现状：Robotis XL330 全部满足，但需超压到 6.6–8.2 V 使用
      宇树 S288  重量/尺寸/减速比/总线均满足，额定 12.6 V (3S) 是唯一障碍
      飞特 STS3032 重量/尺寸满足，力矩约 85%，与 XL330 同为 6 V 上限
```

**空档正在被挤压 —— 宇树 S288 已经补上了大半。** 卡住的是电压等级（3S vs 2S）
和尚未澄清的力矩标注。若宇树出一个 2S 版本、或力矩确认达到 0.9 N·m 级别，
这个位置就被填上了。

飞特的产品线正在往这个方向走 —— **SCS0009（11 g）→ STS3032（20 g）
是一条明确的「小型化 + 总线化」路径**，壳子已经做到位了，
缺的是把减速比或电压等级提上去、把力矩做到 0.9 N·m 级别。

叠加两个市场信号：

- **LeRobot 生态**（Hugging Face）已把 STS3215 推成机械臂的事实标准
- **Microduck 发布 7 小时销售额破百万美元**，证明了 18–20 g 级别的真实需求

> ⚠️ **这是趋势判断，不是预测。** 截至 2026-08-31 没有任何厂商新品公告。
> 但空档明确、壳子现成、需求被验证 —— 这个位置被补上是有可能的。

**如果真出现了**，本仓库的价值反而放大：机械几何、装配关系、电控方案、
执行器参数都已摸清，做适配是几天的事，而不是从零开始。

---

## 结论：没有中间路线

| 路线 | 结果 |
|---|---|
| **保 XL330** | 机械件可直接用本仓库导出的 CAD，官方策略直接跑。舵机成本约 **¥4500** |
| **换 STS3215** | 舵机成本降到约 **¥1000**，但机械件全部重做 + 策略全部重训 —— **实际上就是去做 [Open Duck Mini v2](https://github.com/apirrone/Open_Duck_Mini)**（它全套开源：BOM、Onshape CAD、36 个 STL、装配指南、现成走路策略） |
| **换宇树 S288** | 机械几乎对得上（19.5 g / 34×20×23 / 288.35:1 / M2），且带来关节力控与输出端编码器。但要换 3S 电池、重写通信层、重训策略，**且力矩标注存疑必须先确认** —— 见上文专节 |
| **等** | 空档正在被挤压。若出现 2S 版本或力矩确认达标，本仓库的机械与电控资料可直接复用 |

**同重量级里，力矩够的只有 Robotis 一家。** 飞特 STS3032 尺寸更小、重量相当，
但力矩约为 **85%**（0.44 N·m @6 V vs XL330 0.52 N·m @5 V，同电压口径）且电压上限 6 V；SCS0009 更轻（11 g）但只有 0.23 N·m。
详见上一节的横向对比。

## 成本提醒

Dynamixel XL330-M288-T 的渠道差价极大（2026-09-04 实查）：ROBOTIS 国际站 **$23.90**、
美国站 **$27.49**、Generation Robots 含税 **€40.20**、MyBotShop **€41.95**。
15 个合计 **$359 / $412 / €603 / €629**；
国内价约 ¥299/个，15 个约 **¥4500** —— 均已超过整机 **$399** 售价。
$399 是规模化价格，个人零散采购拿不到。
