FromAIToReality/OpenMicroDuck/docs/硬件方案逆向.md

> **上游技术参考，不是本项目实测结论。** 来源：[fanhao375/microduck-replica](https://github.com/fanhao375/microduck-replica/blob/a23f4c18a4741a3cde5257e639960ea37bbadd8d/docs/%E7%A1%AC%E4%BB%B6%E6%96%B9%E6%A1%88%E9%80%86%E5%90%91.md)。保留原作者及贡献者署名；正文中的“本项目”、实物、照片和测试记录属于上游。与我们的硬件不一致时，以[本项目说明](hardware.md)为准。

# Microduck 硬件方案逆向

**简体中文** · [English](hardware-teardown.en.md)

**方法**：官方开源了 Rust 运行时，而运行时要驱动真实硬件，就必须写死设备路径、
I2C 地址、寄存器偏移、波特率和协议。**代码即规格书**。
本文所有结论都来自 `pollen-robotics/microduck` 仓库的源码、设备树和配置文件。

---

## 一、整体架构

> 📍 **先说一条最容易搞错的**：**主控板、HAT、摄像头三者都在头里**（MJCF 的 `jaw_soft` 刚体，`robot_walk.xml:235` 与 `:247`），摄像头距主控板中心约 13 mm 且中间没有关节。躯干内腔基本被两颗髋部偏航舵机占满，电池外挂在机身后下方。
> 穿过三自由度脖子的只有两束线：舵机总线和 `+BATT` 供电。
> 详见 [电控采购清单 · 板子都装在哪](电控采购清单.md#先搞清楚板子都装在哪)。

```
                    ┌──────────────────────────────┐
                    │   Radxa Zero 3W (RK3566)     │  65 × 30 mm
                    │   Armbian / 内核 6.1.115      │  Pi Zero 形态
                    └──┬────────┬─────────┬────────┘
          /dev/ttyS2   │        │ 40-pin  │ MIPI CSI
          1 Mbps UART  │        │         │
        ┌──────────────┘        │         └── IMX219 摄像头（转 90°）
        │                       │
        │              ┌────────▼─────────────────┐
        │              │  Pollen RPI Robot HAT    │  65×30mm 自制板(已开源)
        │              │  i2c3 @ 400kHz           │
        │              │   ├ TLV320AIC3104  0x18  │ 音频 codec
        │              │   ├ BMI088   0x19/0x68   │ 焊了但没用
        │              │   └ Stemma J5 → ToF 0x29 │
        │              │  电池经此板供电            │
        │              └──────────────────────────┘
        │
   ═════╪═══════════ Dynamixel 总线 (Protocol V2, 1 Mbps) ═══════════
        │
        ├── 15 × Dynamixel XL330    ID: 左腿20-24 / 颈头嘴30-34 / 右腿10-14
        └── imu_to_dxl v2 板         ID: 200      ← 第二块自制板
              └ LSM6DSV16X
```

**核心设计思想**：**一条 Dynamixel 总线搞定一切**。IMU 不走 I2C，而是做成 Dynamixel
从机挂在舵机总线上，和舵机在**同一次 `sync_read` 事务**里被读出来。
电池电压也不用电量计——直接读舵机报告的自身供电电压。

---

## 二、主控：Radxa Zero 3W

| 项目 | 值 | 来源 |
|---|---|---|
| SoC | **RK3566** | `compatible = "radxa,zero-3w", "rockchip,rk3566"` |
| 形态 | Pi Zero，65×30mm，40 针排针 | 与 `pcb__raspberry_pi_zero_2_w.stl` 尺寸一致 |
| 系统 | **Armbian**（Debian 系），vendor 内核 6.1.115 | `armbianEnv.txt`、overlay 注释 |
| 舵机串口 | **`/dev/ttyS2`** | `deploy/robotd.toml` |
| NPU | **0.8 TOPS / INT8 / 单核**，节点 `npu@fde40000`，**Armbian 默认关闭** | `npu-bringup.md`；overlay + `setup-npu.sh` + 重启，详见 [§七之二](#七之二npu-与板载视觉推理) |
| 推理 | ONNX Runtime ≥1.23（安装 1.28.0），`dlopen` 加载 | `Cargo.toml` workspace metadata |
| NPU 推理 | rknn-toolkit2 运行时 | 同上 |

> 💡 **这是最重要的一条**：主控不是什么定制载板，就是**市售的 Radxa Zero 3W**。
> 我之前判断「RK3566 定制载板买不到」是错的 —— 它是现货模块。

---

## 三、`imu_to_dxl` v2 —— 唯一需要自己画的板

**最巧妙的设计，也是最容易自己复刻的一块。**

| 项目 | 值 |
|---|---|
| IMU 芯片 | **LSM6DSV16X**（ST 6 轴，带 SFLP 硬件传感器融合块） |
| 接口 | **Dynamixel 总线**（不是 I2C！） |
| 总线 ID | **200** |
| 寄存器地址 | **124** |
| 控制环读取 | 12 字节 |
| 完整诊断块 | 20 字节（另含原始加速度、采样计数、状态标志） |

### 12 字节块布局

| 字节 | 内容 |
|---|---|
| `0..6` | gyro x/y/z，`i16` 小端原始计数，量程 **±500 dps**，**17.5 mdps/LSB** |
| `6..12` | SFLP 四元数 x/y/z，**IEEE 半精度 (fp16)**；`w = √(1 − x² − y² − z²)` |

### 为什么这么设计

1. **不占用额外总线** —— 和 15 个舵机在同一次 `sync_read` 里读回，零额外开销
2. **主机不用跑姿态融合** —— LSM6DSV16X 的 SFLP 块在芯片内直接输出游戏旋转四元数，
   还自己估计陀螺零偏
3. **只传 w 的三个分量** —— 单位四元数省一个字节对，12 字节刚好塞进一次事务

### 📍 这块板装在躯干，不在头里 —— 而且朝向是写死的

**这条最容易搞错**，因为主控板和 HAT 都在头里，很容易以为三块板都在头里。四条证据：

**① 官方运行时源码明说了**

`duck-control/src/imu.rs` 开头第一行就是 `//! The imu_to_dxl v2 board (LSM6DSV16X), decoded.`，
而它输出的三个量全部标注为躯干坐标系：

```rust
pub struct ImuData {
    /// Angular velocity in the trunk frame, rad/s.
    pub gyro: [f64; 3],
    /// Projected gravity in the trunk frame, unit vector. Upright is `[0, 0, -1]`.
    pub gravity: [f64; 3],
    /// Orientation, trunk→world, scalar-first `[w, x, y, z]`.
    pub quat: [f64; 4],
}
```

**② 安装朝向是常量，不是随便装**

```rust
/// The board is mounted so that trunk = `[+raw_z, +raw_y, −raw_x]`, a +90° rotation about Y.
pub const DEFAULT_MOUNT: [f64; 4] = [FRAC_1_SQRT_2, 0.0, FRAC_1_SQRT_2, 0.0];
```

即 **躯干 X = 芯片 +Z，躯干 Y = 芯片 +Y，躯干 Z = 芯片 −X**（绕 Y 轴 +90°）。
解码时 `rotate(self.mount, gyro_sensor)` 把传感器读数转到躯干系。

**③ MJCF 里策略用的传感器全绑在躯干**

| 站点 | 所属 body 链 | 有无传感器绑定 |
|---|---|---|
| **`imu`** | **`trunk_base`** | ✅ `framequat` / `gyro` / `accelerometer` 全绑它 |
| `head_imu` | `trunk_base > neck > neck_pitch > yaw_roll_motion > jaw_soft` | ❌ 一个都没有 |

`banana_pcb_locker` 在全文**只出现一次**，也在 `trunk_base`（`robot_walk.xml:92`）。

**④ 头里那颗 IMU 是 HAT 的 BMI088，软件不用**

设备树注释原文写的是「**dormant** BMI088」「(**unused** but still connected) BMI088」
（`deploy/audio/i2c3-pihat.dts:11,31`），对应上表中没有任何传感器绑定的 `head_imu` 站点。

#### 为什么物理上也必须在躯干

策略的 61 维观测里，来自 IMU 的只有 **角速度** 和 **投影重力** 两项，
**它们只取决于 IMU 所固连刚体的姿态，与 IMU 装在刚体上的哪个点无关**。

而头挂在 `neck → neck_pitch → yaw_roll_motion` **三个串联关节**之后。
装头里读到的是头的姿态，与躯干差着三个关节，而观测里没有脖子角度补偿项 ——
仿真绑躯干、实物装头上，sim-to-real 直接失配。

→ **位置在躯干内可以自由选，朝向必须确定并已知。**
朝向若与官方不同，改 `SflpDecoder::new(mount)` 传入自己的四元数即可，该构造函数就是留给这个用的。

#### 锁扣在躯干背面，不在内腔

把 `robot_walk.xml` 里 `trunk_base` 各零件的 `pos`/`quat` 应用到对应 STL 后实测（躯干坐标系，mm）：

| 零件 | X | Y | Z | 尺寸 |
|---|---|---|---|---|
| **`banana_pcb_locker`** | **−32.3 … −28.5** | −27.0 … +27.0 | +31.5 … +38.1 | 4 × 54 × 7 |
| `right_shell` 后缘 | **−27.8** | | | |
| `np_f970` 电池 | −55.3 … −16.7 | ±10.3 | −39.3 … +31.6 | 39 × 21 × 71 |
| `xl330` ×2 髋部偏航 | −8.5 … +20.5 | ±(7.5…27.5) | −13.0 … +21.0 | 29 × 20 × 34 |
| `imu` 站点 | −21.0 | +0.07 | −14.7 | — |

**锁扣的 X 范围整个落在右壳后缘之外**（−32.3 < −27.8），往后 0.7～4.5 mm ——
它是贴在**壳体背面、电池顶部**的一根横压条，**不在躯干内腔**。
在内腔里找不到它是正常的。

> ⚠️ 「锁扣压的就是 `imu_to_dxl`」仍是推断 —— MJCF 里没有这块板本身的任何几何。
> 硬约束只有一条：**IMU 必须刚性固连在 `trunk_base` 上**。
>
> ⚠️ 网格文件名叫 `np_f970.stl`，但实测 39 × 21 × 71 mm 是 **NP-F550** 的尺寸，
> 真 F970 厚约 60 mm。见 [BOM 的电池型号勘误](../BOM.md)。

### 自己做这块板要什么

- LSM6DSV16X（或引脚兼容的 ST 6 轴）
- 一颗小 MCU 做 Dynamixel Protocol V2 从机（STM32G0 / CH32V 之类足够）
- 半双工 TTL 收发器（Dynamixel 总线是单线半双工）
- 供电从总线取

**这是整个项目里最值得自己画的一块板**，元件少、逻辑清晰、协议公开。

---

## 四、Pollen RPI Robot HAT —— **官方已开源，不必自己画**

> 📌 **勘误（2026-09-03）**：本节此前按「未开源、需逆向」处理。**这是错的。**
> 这块板在 [`pollen-robotics/elec_RPI_Robot_HAT`](https://github.com/pollen-robotics/elec_RPI_Robot_HAT)
> 有完整开源工程（**Apache-2.0**）：KiCad 9 原理图与 PCB、Gerber、BOM、贴片坐标、STEP、
> 以及全部器件手册。当时只检索了 `microduck` 主仓，漏掉了同组织下 `elec_` 前缀的硬件仓库。

**结论：这块板直接下载官方 Gerber 打样即可，本节保留作为「逆向 vs 实物」的对照记录。**

### ⚠️ 打样前必读的四条警告

**1. 这块板没有充电电路，也没有 USB-C 输入。**

仓库里有张 `pwr_supply_charge.kicad_sch`，很容易让人以为板上带充电。**它是孤儿图纸** ——
`main.kicad_sch` 只实例化了 `audio / dynamixel / power / sensors` 四张子图，没有挂它；
图纸标题栏写的还是别的项目（`Chromapi's Power Supply & Charge`）。

生产 BOM 实测核对：`CN3302`（锂电充电 IC）、`HY2120`（保护）、USB-C 母座、
电源开关、指示 LED、`AO4435`/`FDS6630A` —— **一个都没有**。

板上真实存在的电源器件只有两颗：

| 位号 | 器件 | 作用 |
|---|---|---|
| `U10` | **LM5050-1** | 理想二极管 OR-ing ＋ 关机检测（IO_06）。⚠️ 它在 buck **之后**的 `+5V` 那一路，不是电池输入端的防反接，见下方电源树勘误 |
| `U9` | **AP63205** | 降压变换器 |

> **结论：电池必须用外部充电器充。** 插 USB-C 不会给机器人充电。

### HAT 的电源树（原理图第 4/6 页 `dynamixel.kicad_sch` 核对）

```
NP-F550 电池 ──► +BATT ──┬──► J13 / J14  Dynamixel-3（TTL 3P，JST EH 2.5mm）
  2S，6.6–8.2V           │      经 TH1 100R 热敏，原理图旁注「3A max」
                         │
                         ├──► J3 / J11   Dynamixel-4（RS-485 4P，JST EH 2.5mm）
                         │      直接 +BATT，由 U8 SIT3088E 驱动
                         │
                         └──► C19 10µF/63V ──► U9 AP63205 + L4 6.8µH ──► Q2 / U10 LM5050-1 ──► +5V
                                                 2A / Fsw 1.1MHz         理想二极管 ORing         │
                                                                         + 关机检测 (IO_06)       │
                                                                                                  ├─► 树莓派 40 针 J4
                                                                                                  ├─► 音频功放 PAM8406D
                                                                                                  └─► U3 XC6206P182 → +1V8（codec）
```

> `+3V3` 反过来由主控侧经 40 针供给 HAT，不是 HAT 自己产生的。
>
> ⚠️ **勘误（2026-09-04）**：本文此前把 U10 LM5050-1 画成 `+BATT` 的**前级**，**位置错了一级**。
> 按原理图 Power 页各符号的实际 X 坐标排序：
> `+BATT(153) → C19(219) → U9 AP63205(302) → L4(392) → Q2(558) → U10 LM5050-1(568) → +5V(635)`
> —— **U10 与 Q2 在 buck 之后的 `+5V` 那一路**（配合 IO_06 的「Switch off detection」），
> 不是电池输入端的防反接。**「舵机吃 `+BATT` 电池原压」这个结论不受影响。**

**要点：舵机吃的是 `+BATT`，不是 `+5V`。** 板上只有一颗 buck（U9）和一个电感（L4），
5 V 那一路是给树莓派的，2 A 也带不动 15 个 XL330。这就是
[XL330 被超压运行](执行器选型.md#-电压真相xl330-被超压运行)的原理图级证据。

顺带：HAT 的输入侧按高压设计（`C19 10µF/63V`、`C20 100nF/50V`，注释写着
`Power 24V 5A i.e. 7s/25c, from 21V to 29V`）—— 因为它是 Pollen 给
「small/medium size robots」做的**通用 HAT**，不是 Microduck 专用。
所以舵机总线电压完全取决于你插什么电池；Microduck 插的是 2S。

**2. 打开 KiCad 工程需要另一个仓库。**

HAT 仓库里**没有** `sym-lib-table`、`fp-lib-table` 或任何 `.pretty` 目录，
但原理图引用了 `Library_Pollen`、`LCSC_parts_lib`、`Lib_Pollen`。这些在
[`pollen-robotics/lib_KiCAD`](https://github.com/pollen-robotics/lib_KiCAD) 里
（`Symbols/Library_Pollen.kicad_sym`、`Footprints/Lib_Pollen.pretty`、`LCSC_parts/`）。

不装它直接打开，会是一片未解析的符号。
**只想打样的话不需要** —— 直接用 `production/` 里的 Gerber。

**3. 四层板，118 个贴片位，必须走 SMT 服务。**

`kicad_pcb` 的层定义是 `F.Cu / In1.Cu / In2.Cu / B.Cu`。BOM 47 行 123 颗元件，
含 **VQFN-32 的 codec** 和 **LGA-16 的 BMI088** —— 手焊不现实，下单时直接选贴片。

DNP（不贴）共 5 行：`C25`、`R10/R11`、`R16/R17/R41`、`R36/R37`、以及 **`U4`**。

**4. `U4 = CAT24C32` 不贴 → 这不是自识别 HAT。**

EEPROM 位置空着，所以它不符合 `hat-plus-specification` 的自动探测流程，
系统不会自动认出这块板。设备树 overlay 得手动配。

### 补充：Dynamixel 侧其实是双制式

| 位号 | 接口 | 说明 |
|---|---|---|
| `J13 / J14` | **TTL 3P**（JST EH 2.5mm） | Microduck 的 XL330 走这路 |
| `J3 / J11` | **RS-485 4P**（JST EH 2.5mm） | 由 `U8 = SIT3088E` 驱动 |
| `TH1` | 100R 热敏电阻 | 过流保护 |

也就是说这块板**同时能驱动 TTL 和 485 两种 Dynamixel，以及飞特舵机**（换线即可）。

### 补充：它不是 Microduck 专用板

这是一块「小/中型机器人通用 HAT」，已知三个使用者：

- **Microduck**（本项目）
- Pollen 自家的 **Grabette / Casquette**（跑在 Pi 4 上）
- 第三方 **[`Rhoban/microban`](https://github.com/Rhoban/microban)** —— 19×XL330 + Pi Zero 2W + 2×18650 的双足机器人，
  **有一份完整公开的 BOM + 装配 + 打印指南**（整机约 $567），采购时值得对照

> `Rhoban/microban` 的 BOM 里对这块板的描述值得记住：
> *"与其他元件不同，RPI Robot Hat 不是现成货：这是一块开源板，你需要自己送厂制造。"*
> —— **开源 ≠ 买得到**，还是得打样。

### 逆向结论与官方 BOM 的比对

| 本文逆向推出 | 官方 BOM 实际 | 结果 |
|---|---|---|
| 音频 codec @ `0x18` | `U2 = TLV320AIC3104IRHBR` | ✅ |
| BMI088 @ `0x19/0x68`，焊了没用 | `U11 = BMI088` | ✅ |
| 上拉「单对 10k，**R12/R13**」 | `R12, R13 = 10k` | ✅ **位号完全命中** |
| 「Stemma **J5** 接口」 | `J5–J8 = JST SH 1mm 4P` | ✅ |
| Pi Zero 形态 40 针 | `J4 = 2x20 rasp HAT zero SMD` | ✅ |

### 逆向时**没能看出来**的部分（源码里不体现）

| 器件 | 作用 |
|---|---|
| `U1 = PAM8406D` | D 类音频功放 |
| `MK1` | **板载 MEMS 麦克风**（LCSC `C7587901`）。⚠️ 官方 BOM 的 Value 只写 `Microphone_MEMS`，原理图旁只有「Onboard Mic.」，**未给型号**；此前写的 LMA2718 无出处，已撤回 |
| `U10 = LM5050-1` | 理想二极管控制器（防反接 / OR-ing） |
| `AP63205` | 降压变换器 |
| `CAT24C32` | EEPROM —— Raspberry Pi HAT+ 规范要求的身份识别 |
| `J1/J2/J9 = Wago-2` | 免螺丝端子：外接喇叭、第二个麦克风 |
| `J3/J11`、`J13/J14` | Dynamixel 4P / 3P 连接器（JST EH 2.5mm） |

官方 README 还给出了两条源码里读不到的信息：

- **供电范围 5–28 V**，设计上就是**从电机接口取电**
- Dynamixel **TTL 与 RS485 都支持**（换线即可，也能驱动飞特舵机）

### 板载器件

| 器件 | I2C 地址 | 说明 |
|---|---|---|
| **TLV320AIC3104** | `0x18` | TI 音频 codec，I2S 数据 + I2C 控制 |
| **BMI088** | `0x19` / `0x68` | **真的贴了片但软件不用**（BOM `U11`；注释原文 "dormant"、"unused but still connected"）。外界说 Microduck「有两颗 IMU」指的就是它 |
| **ToF** | `0x29` 或 `0x52` | 不在板上，通过 **Stemma/Qwiic J5** 外接。固件**同时支持 VL53L5CX 和 VL53L8CX**，按 revision ID 自动识别 |

- I2C 总线：40 针的 **pin 3 / pin 5**（`GPIO1_A0` = SDA，`GPIO1_A1` = SCL）
- 总线速率 **400 kHz**（受限于 codec 和 BMI088；VL53L5CX 本可以跑 1 MHz）
- 上拉：**单对 10k，R12/R13**
- 音频时钟：MCLK **12 MHz** 固定晶振，I2S sysclk **12.288 MHz**（256 × 48kHz）
- **机器人内部供电经此板**（电池 → HAT → 主控）

### ⚠️ 一个他们自己踩过的坑（注释里写得很清楚）

RK3566 的 `i2c3` 控制器在原厂 DTB 里跑在 **M1 pinmux**（`GPIO3_B5/B6`，靠近 USB-C 口），
服务 **FUSB302 USB-C PD 控制器**。而 HAT 要用的 pin 3/5 正好是 `i2c3` 的 **M0 pinmux**。

他们的 overlay 把控制器重新 mux 到 M0，并禁用 fusb302 节点。后果：

- **失去 USB-C PD 协商**
- 但 FUSB302 上电默认在两条 CC 线上呈现 Rd（`SWITCHES0 = PDWN1|PDWN2`），
  所以 USB-C 充电器（无论 PD 还是普通）**仍然给 5V** —— 板子本来就只要 5V
- 机器人内部供电走电池经 HAT，与此无关
- maskrom 刷机是 ROM code，不受影响

> 早期版本用的是 **bit-bang I2C**（`i2c-gpio-pihat`），CPU 占用高。
> 改成硬件 I2C 后才让 **15 Hz 的 ToF 流**变得可负担。
> 两种模式互斥，`install.sh` 通过 `MICRODUCK_I2C_MODE=hw|bitbang` 选择。

### 稳定设备节点

`/dev/i2c-3` 通过 udev 规则软链为 **`/dev/i2c-pihat`**，两种模式下消费者代码不用改。

---

## 五、舵机总线

| 项目 | 值 |
|---|---|
| 电机 | **Dynamixel XL330 × 15** |
| 协议 | **Dynamixel Protocol V2** |
| 波特率 | **1 Mbps**（寄存器 `baud_rate = 3`） |
| 串口 | `/dev/ttyS2` |
| Rust 库 | [`rustypot`](https://github.com/pollen-robotics/rustypot)（Pollen 自家的） |
| 控制环 | **50 Hz** |

### ID 分配

```
左腿   20  21  22  23  24     hip_yaw / hip_roll / hip_pitch / knee / ankle
颈头嘴 30  31  32  33  34     neck_pitch / head_pitch / head_yaw / head_roll / mouth
右腿   10  11  12  13  14     （左腿的镜像）
IMU 板 200                    imu_to_dxl v2
```

> **第 15 个舵机是嘴（ID 34，索引 9）。** 所有 alpha 策略都是
> `obs[1,61] → actions[1,14]`，动作向量**跳过这一个索引**——嘴由上层逻辑控制，
> 不由策略控制。
>
> 这套 ID 分配和 **Open Duck Mini v2 完全一致**（20-24 / 30-33 / 10-14），
> 只是多了一个 34。血统印证。

---

## 五之二、通讯方案（逐条确认）

### 主总线：单线半双工 TTL UART —— **不是 RS232，也不是 RS485**

| 项目 | 值 | 依据 |
|---|---|---|
| 电气层 | **3 线 TTL 半双工**（数据线 + VDD + GND） | XL330 产品规格：3-pin JST，TTL |
| 逻辑电平 | **3.3 V** | RK3566 IO 电平 |
| 协议 | **Dynamixel Protocol V2** | `.with_protocol_v2()` |
| 速率 | **1 Mbps** | `BAUD_RATE = 1_000_000`，EEPROM 寄存器 `baud_rate = 3` |
| 端口 | `/dev/ttyS2` = RK3566 **UART2，M0 pinmux** | `robotd.toml`，`uart2-m0` overlay |
| 挂载设备 | **16 个**：15 舵机 + 1 块 IMU 板 | `ids = [200, 20..24, 30..34, 10..14]` |
| 单次事务 | 一个 `sync_read` 覆盖全部 16 个设备，寄存器 **124–136** | `bus.rs` |

> ❗ **不是 RS485**。RS485 是差分双线，Dynamixel 的 XM/XH 系列才用（4-pin）。
> XL330 是 **TTL 单线半双工**（3-pin）。全仓库搜 `rs485|rs232|half-duplex|direction pin`
> **零命中** —— 代码里没有方向控制 GPIO，说明**方向切换由硬件自动方向电路完成**，
> 这部分电路在 HAT 板上。

### ⚠️ Armbian 的坑：UART2 默认跑着登录控制台

> `robotd-design.md` §原文：Armbian 默认在 UART2 上跑 `serial-getty@ttyS2`，
> `agetty` 会占着串口。必须 `systemctl mask serial-getty@ttyS2`。
> 官方是用 `fuser -v /dev/ttyS2` 查出来是 `agetty` 干的。

### 其余接口一览

| 接口 | 用途 | 参数 |
|---|---|---|
| **UART2 (ttyS2)** | 舵机 + IMU 板 | 1 Mbps TTL 半双工 |
| **I2C3 (M0，pin 3/5)** | 音频 codec / ToF /（未用的 BMI088） | 400 kHz |
| **I2S3 (i2s3_2ch)** | 音频数据 | MCLK 12 MHz，sysclk 12.288 MHz |
| **MIPI CSI** | IMX219 摄像头 | I2C 控制地址 0x10 |
| **蓝牙** | 手柄（`padd`）、手机 App（`btd`） | Radxa Zero 3W 板载 |
| **WiFi** | WebRTC 视频、配网（`configd`） | 板载 |
| **USB-C** | 供电 + maskrom 刷机 | PD 协商被 overlay 牺牲掉了 |
| **Unix socket** | 各守护进程间 JSON-RPC | 不是硬件 |

---

### 飞特 STS/SCS 协议对照

很多人问：**换成飞特舵机之后，「把 IMU 做成总线上第 16 个设备」这套还成不成立？**

**成立。** 飞特 STS/SCS 有自己的批量读指令 `SYNC READ`（`0x82`），用法与 Dynamixel 一致。
差别只在**应答怎么回来**。

| | Dynamixel V2（XL330） | 飞特 STS/SCS |
|---|---|---|
| 物理层 | 半双工单线 TTL、3 线、1 Mbps | **完全相同** |
| 接头 | JST EH 2.5 mm | 5264，同为 2.5 mm（⚠️ 间距相同，壳体卡扣细节建议拿实物确认） |
| 包头 | `FF FF FD 00` | `FF FF` |
| 校验 | CRC-16 | `~sum`（取反和） |
| 批量读 | `sync read`（**官方实际用的**）<br>另有 `fast sync read` 0x8A，但**未被使用** | **`sync read` 0x82** |
| 应答方式 | 每设备**一个独立包** | 每设备**一个独立包** |
| 总线转向／周期 | 17 次 ⚠️ | 17 次 ⚠️ |
| ID 范围 | 0–252 | 0–253（寄存器 5） |
| 波特率设定 | 寄存器 `baud_rate = 3` | 寄存器 6，`0 = 1M` |

**证据**：`scservo_sdk/group_sync_read.py` —— `syncReadTx()` 发一条指令包，
`syncReadRx()` 收回一段缓冲，再由 `readRx()` 按 `[0xFF, 0xFF, scs_id]` 逐个匹配包头切分：

```python
result, rxpacket = self.ph.syncReadRx(self.data_length, len(self.data_dict.keys()))
while (rx_index + 6 + data_length) <= rx_length:
    if (headpacket[2] == 0xFF) and (headpacket[1] == 0xFF) and headpacket[0] == scs_id:
        break
```

> ⚠️ **「17 次」是协议推论（1 条指令 ＋ 16 个设备各回一包），不是实测。**
> 换算成毫秒取决于三态缓冲切换速度、包间隙与实际读取的寄存器长度 —— 到货用 FE-URT-1 实测。

#### 关键更正：官方**没有**使用 `fast sync read`

Protocol V2 的 `fast sync read`（`0x8A`）确实能把所有应答拼成一个包、把总线转向压到 2 次。
**但 Microduck 的运行时没有用它** —— 全库检索 `fast_sync_read` / `0x8A` **零命中**，
`duck-control/src/bus.rs:236` 调的是普通的 `sync_read_raw_data`：

```rust
.sync_read_raw_data(&self.ids, READ_ADDR, READ_LEN)
.map_err(|e| IoError::Bus(format!("combined imu+motor sync_read: {e}")))?;
```

这也和 `model.rs:84-86` 那句「500 µs **per device** × 16 devices ＝ 8 ms」自洽 ——
**如果应答拼成一个包，per-device 的转向延迟就不会乘以 16。**

**所以两边的应答机制是一样的**：都是一条指令包出去、每个设备各回一个独立状态包。
飞特并非「没有批量读」，Dynamixel 也并没有在用它那个更快的变体。
真正的差别只剩两条：**包格式**，以及下面这条出厂默认值。

#### ⚠️ 一个反直觉的发现：出厂延时上飞特反而占优

STS 内存表第 `7 (0x07)` 号 **Return Delay Time**：**默认 0**，备注 **"Not functional on STS"**。

而 XL330 出厂是 `250`，即 **500 µs／设备** —— `duck-control/src/model.rs:84-86` 原文：

> `return_delay_time` … the XL330 ships at 250, which is 500 µs of turnaround **per device**.
> Across **16 devices** that is **8 ms per tick — 40% of a 20 ms budget**

官方必须把这个寄存器写 0 才能消掉。**飞特天然没有这笔开销**，它多出来的转向成本很大程度被这一条抵掉。

#### 飞特侧另一个该调的寄存器

STS 内存表第 `8 (0x08)` 号 **Response Level**，默认 **1**（所有命令都应答）。
改成 **0** 之后只有 read 与 ping 回包，普通写指令不再占用总线时间 ——
与官方对 XL330 写 `return_delay_time = 0` 是同一类动作。

> **出厂默认值是给通用场景的，高频控制回路必须自己调。**

---

### 替代型号：飞特 HD-1910-C001

> 📄 **数据源已升级（2026-09-08）**：此前用的是预售期产品页的单值，现改用厂家正式规格书
> **《HD-1910-C001 串型规格书》A/0，2026-09-07 初次发行**（厂家发给客户确认的文档，
> 本仓库按惯例不转载 PDF）。多项数值与旧记录不符，逐条更正如下。

飞特按 **4.8 / 6 / 7.4 V** 三档给参数。本方案 2S 母线是 **6.6–8.2 V**，
**最接近 7.4 V 那一列**，下表以它为准、括号内给 6 V：

| 项 | XL330-M288-T | **HD-1910-C001** | 判断 |
|---|---|---|---|
| **电压范围** | 3.7 – **6.0** V（推荐 5.0） | **4 – 8.4 V** | ✅ 总线 6.6–8.2 V **完全落在额定区间内**<br>⚠️ 旧记录写 5 V 起，实为 **4 V** 起 |
| **外形尺寸** | 20 × 34 × 26 mm | **34 × 20 × 23 mm** | ✅ 前两维同组数，第三维**薄 3 mm** |
| **重量** | 18 g | **21 ± 2 g** | ⚠️ 单只 +3 g，**15 只 ＝ +45 g**（旧记录 22.5 g 有误） |
| **堵转力矩** | 0.52 N·m @5V／0.60 @6V | **15 kg·cm ＝ 1.47 N·m** @7.4V<br>（12 kg·cm ＝ 1.18 N·m @6V） | ✅ 约 2.5 倍。旧记录「10 kg·cm」是产品页的保守值 |
| 空载转速 | ~103 RPM @5V | **113 RPM**（0.088 s/60°）@7.4V<br>（92 RPM @6V） | 相当 |
| 额定负载 | — | **3.7 kg·cm ＝ 0.363 N·m** @7.4V<br>（3.0 kg·cm @6V） | |
| **堵转电流** | ~1.5 A @5V | **2.0 A** @7.4V（1.6 A @6V） | ⚠️ 旧记录「1.8 A」无此档位，见下方电流核算 |
| **额定电流** | — | **900 mA** @7.4V（690 mA @6V） | ⚠️ 旧记录「500 mA」是 **4.8 V** 那一列 |
| 空载电流 | — | ≤210 mA @7.4V（≤180 mA @6V） | |
| 静态电流 | — | **20 mA** | |
| Kt 常数 | — | 7.5 kg·cm/A | |
| 角度传感器 | — | **12 bit 磁编码**（0.088°/step） | |
| 减速比 / 齿轮虚位 | — | 1/320 ／ ≤0.5° | |
| 寿命 | — | >100000 次 | |
| 外壳 / 齿轮 | — | **PA66+GF43%** ／ 金属齿 | 旧记录「PA + Fiber」不够具体 |

#### 电机自带三道电子保护（规格书 7-11）

**异常检测在电机固件里做，主机不必轮询。** 但出厂默认状态需要注意：

| 保护 | 动作 | 出厂状态 |
|---|---|---|
| **过流** | 电流 >0.5 A 持续 2 s → 关闭输出；重发位置指令清标志；**阈值与时长可自定义** | ❗ **默认关闭** |
| **过压** | >10 V 或 <4 V → 保护；电压回正常自动解除；**范围可自定义** | ❗ **默认关闭** |
| **过热** | >80 ℃ → 关闭扭矩输出 | ✅ 默认开启 |

→ **装机前应把过流、过压打开。** 8.4 V 满电落在 4–10 V 窗口内，不会误触发。

反馈六项齐全（7-10）：**输入电压 / 负载 / 工作电流 / 工作速度 / 工作温度 / 位置**，
与 Dynamixel 同构，官方运行时用到的那几项都能读（见 [§六 · 官方确实在读舵机遥测](#六官方确实在读舵机遥测)）。

出厂默认运行模式是**模式 4「纯位置 PD（Sim2Real）」**（7-12）—— 正是强化学习落地要用的那个，
XL330 无对应模式。另有模式 0 角度伺服 / 1 恒速 / 2 恒流 / 3 PWM 开环。

> ⚠️ **别拿 `HL-2915-C002` 当参考。** 本仓库早期引用过这份规格书（用于「飞特接口惯例」），
> 但它是 **9–14 V（典型 12 V）** 舵机，**挂不上本方案的 2S 母线** —— 9 V 才开始工作。
> 而且它的**连接器脚序与 HD-1910 完全相反**（`1=GND / 2=Vcc / 3=Signal`，连接器 `AMP-3`），
> 照抄会接错线。详见
> [`hardware/imu_to_dxl/README.md` · 飞特脚序按型号不同](../hardware/imu_to_dxl/README.md)。

**电压这一条把两条路线的定性反了过来。** 同一套 2S 供电：

- **XL330 是超压运行**（额定上限 6.0 V，实跑 6.6–8.2 V，超出约 37%）——
  Pollen 用发热与寿命换力矩，这是妥协，见 [执行器选型 · 电压真相](执行器选型.md#-电压真相xl330-被超压运行)
- **HD-1910 是额定匹配** —— 带载区间 6.6–8.2 V 完整落在 5–8.4 V 内，不存在超压。
  ⚠️ **但要注意余量**：电池**满电 8.4 V** 恰好等于 HD-1910 的电压上限，也就是**零余量**。
  本仓库对自制板的要求是「耐压至少 2 倍工作电压」，对舵机显然做不到这一点，
  但至少它是在厂商额定内工作，而 XL330 是在额定之外

> ⚠️ 此处**不与 MJCF 的 `forcerange` 比较** —— 那是 MuJoCo 的仿真力限，不是厂商值，
> 拿它和厂商标称堵转值并排比较是错的，见 [执行器选型](执行器选型.md) 该表下方的口径说明。
>
> 也注意区分：HD-1910 的 **0.98 N·m 是堵转**，**额定负载是 3.0 kg·cm ＝ 0.294 N·m**。

#### ✅ 电气接口：已确认与 Dynamixel 同构

| 结论 | 依据 |
|---|---|
| **TTL 串行总线，三针接口** | 飞特官方产品页（预售）上舵机本体标注「三针接口 · TTL串行总线」，特性栏列 "TTL总线"。该页标题即「**开源小鸭舵机** —— 专为小鸭子 AI 玩偶定制开发」 |
| 连接器 **`AMP-3P`** | `HD-1910-C001.stp` 装配体零件名单 |
| 脚序 **`1=GND / 2=Vcc / 3=Signal/TTL`** | 飞特《HL-2915-C002 串型规格书》A/0 (2026-02-27) 第 4 页 6-7 项，连接器类型 `AMP-3`。该装配体亦出现在 HD-1910 的 STEP 里，两款共用平台 |
| 半双工异步、**8 bit / 1 stop / 无校验** | 同规格书 7-2 项 |
| 波特率 38400 ~ 1 Mbps，**出厂默认 1 Mbps** | 同规格书 7-4 项 |
| ID 0–253，**出厂默认 ID 1** | 同规格书 7-3 项 |
| **信号高电平 2–5 V**，低电平 0–0.45 V | 同规格书第 8 页第 12 项 |

→ **与 Dynamixel TTL 物理层完全同构**（半双工单线 / 1 Mbps / 3 线 / GND-VCC-DATA），
`imu_to_dxl` 的硬件不需要为飞特改动，差别只在包格式。

> ⚠️ 「飞特 = TTL 单线」**只对 STS / SCS / HL 这一支成立**。
> 官方内存表手册（<http://doc.feetech.cn>）写明 **SMS 系列走 RS485、默认 115200**，
> SHC 系列走 CANopen。换系列前必须先查它自己的手册。

#### ⚠️ 规格书还缺的四项（须向厂家书面确认）

| 缺什么 | 为什么要紧 |
|---|---|
| **10 kg·cm 是在几伏下测的** | 最要紧。若为 @8.4 V，则电池掉到 6.6 V 时约降至 0.7 N·m。**直接决定策略重训的力矩模型**（BAM 的 `vin_range` 与力矩曲线全依赖它） |
| **减速比** | XL330 是 288.4:1。BAM 执行器辨识模型里减速比是关键项 |
| **编码器分辨率** | 口头称 12-bit，规格书未列，需书面确认 |
| **回差（backlash）** | MJCF 有专门的 `*_backlash` 建模变体，此参数影响仿真到实机的迁移 |

#### ⚠️ 电流核算：一条本来就该做、此前没做的核算

**这不是飞特路线新增的问题。** 堵转 **1.8 A × 15 ＝ 27 A**，
而 XL330 的 **~1.5 A × 15 ＝ 22.5 A** 同样远超四个接口 × 3 A ＝ 12 A。
而 HAT 的 Dynamixel 接口旁注是 **「3A max」**，J13/J14 还串了 TH1 100R 热敏。

实际行走不会全部同时堵转 —— 官方续航约 1 小时、NP-F550 容量约 2200–2900 mAh，
反推平均电流约 2.5 A。但**起身、摔倒自恢复、踢球这类动作会有多个关节同时大电流**。

**15 个舵机分在四个连接器上，每个口的电流分配与线径要重新核算。**

---

## 五之三、为什么必须用 Linux SoC，不能用 STM32 / ESP32

主控要同时干这些事：

| 任务 | 负载 |
|---|---|
| ONNX Runtime 跑策略 | `obs[1,61] → act[1,14]` @ **50 Hz** |
| WebRTC 视频推流 | 720p30 H.264，**Rockchip MPP 硬件编码** |
| RKNN NPU 目标检测 | `duck_detect.rknn`，2 Hz（**热限制**，满速 95°C） |
| GStreamer 管线 + 拥塞控制 | `rtpgccbwe` 占 7.6% 一个核 |
| 蓝牙手柄 + 手机 App + WiFi | BlueZ 协议栈 |
| 签名固件更新 / 回滚 | `updaterd` |

**MCU 做不了这些** —— 光是 WebRTC + H.264 硬编 + ONNX 推理就必须 Linux + 硬件编码器 + NPU。

所以选型是：**RK3566 四核 Cortex-A55 + Mali-G52 + NPU，跑 Armbian**。

> 📌 但注意：**原型阶段用的是树莓派 Zero 2W**。
> `robotd.toml` 注释原文：50 Hz 控制环 *"is inherited from the prototype, where it was
> chosen on a Raspberry Pi Zero 2W. It has never been re-derived on the Radxa."*
> Open Duck Mini v2 至今仍在用树莓派 Zero 2W —— 因为它不做视觉和 WebRTC。

### 那 `imu_to_dxl` 板上是什么 MCU？

**仓库里没有** —— 那是板子自己的固件，不在这个开源仓库里。
但从它要干的活可以反推需求：

- 做 **Dynamixel Protocol V2 从机**（响应 `sync_read`，ID 200，寄存器 124）
- 读 **LSM6DSV16X**（SPI 或 I2C）
- **1 Mbps UART** + 半双工方向切换
- 把 SFLP 四元数打包成 fp16

**STM32G0 / STM32G4 / CH32V203 / ESP32 都够用。** 这块正好是可以自由选型的地方 ——
只要在总线上表现得像个 Dynamixel 从机，主控不关心里面是什么芯片。

---

## 六、电源与电池

| 项目 | 值 |
|---|---|
| 电池 | **索尼 NP-F550**（L 系列摄像机电池），**2S 锂离子** |

> ⚠️ **是 NP-F550，不是 F970。** 上游网格文件名为 `np_f970`，但其包围盒实测
> **70.8 × 38.6 × 20.6 mm**，正是 NP-F550/F570 的尺寸；源码中也只出现 NP-F550。
> 真 NP-F970 厚约 60 mm、重约 300 g，**装不进去且严重超重**。详见 [BOM](../BOM.md)。
| 标称 | 7.2 V |
| 满电（负载下） | **8.2 V** |
| 空（负载下） | **6.6 V** |
| 电量计 | **无** |
| ADC | **无** |

### 电压怎么测的

> 注释原文：*"There is no fuel gauge and no ADC. The only measurement available is
> what the servos report as their own supply."*

**直接通过 Dynamixel 协议读舵机报告的自身供电电压**，即"从总线上看到的电池"。
所以这个值**会随负载下沉、静止时回升** —— 6.6~8.2V 这个区间是
**「带载可用区间」**，不是电芯化学量程。

电池 EMA（约 10 秒时间常数）跌到 6.6V → **自动优雅坐下并关机**。

> 这个设计对复刻很友好：**你不需要设计任何电池监测电路**。

---

## 七、传感器

### ToF 深度

| 项目 | 值 |
|---|---|
| 芯片 | **VL53L5CX** 或 **VL53L8CX**（ST 多区测距，两代同一套接口） |
| 地址 | `0x29` |
| 总线 | HAT 的 i2c3 |
| 帧率 | 15 Hz |

用途：`theremin` 特性 —— 手在喙前的距离映射成音高，嘴随音高张合。
可用带 0.10–0.70 m。

### 摄像头

| 项目 | 值 |
|---|---|
| 传感器 | **IMX219**（= 树莓派 Camera v2） |
| I2C 地址 | `0x10` |
| 设备树 overlay | `radxa-zero3-rpi-camera-v2` |
| 安装 | **转 90°** —— `mediad/src/main.rs:82` 的 `--rotate` 默认 90，注释原文<br>「the head camera is mounted **a quarter turn off**, and this is the one place that fact is written down」。<br>⚠️ `docs/project/media-bringup.md:472` 里的 **180° 是 alpha 机**的过时数据 |
| 传感器模式 | 钉在 1920×1080@30（避开开机默认模式的 21 fps 上限） |
| 默认输出 | 720p30，2 Mb/s |
| 编码 | GStreamer + **Rockchip MPP 硬件编码器** → WebRTC |
| HFOV | ~62° |

### 音频

| 项目 | 值 |
|---|---|
| Codec | TLV320AIC3104 |
| ALSA 卡名 | `aic3104` |
| 麦克风 | 接 **Mic3R**（单声道，右 PGA），其余输入全关 |
| 输出 | Line out，音量 9/9 |

---

## 七之二、NPU 与板载视觉推理

> 本节据上游 `docs/project/npu-bringup.md` 与 `duck-detect/` 整理。
> 这是目前唯一一份把「RK3566 的 NPU 到底能干什么」写实的材料。

### NPU 规格

| 项目 | 值 | 来源 |
|---|---|---|
| 算力 | **0.8 TOPS，INT8，单核** | `npu-bringup.md` 开篇 |
| 设备树节点 | `npu@fde40000` | Armbian 出厂 `status = "disabled"` |
| 运行时 | rknn-toolkit2 运行时 `librknnrt.so` | 驱动 0.9.8 / 运行时 2.3.2（实测） |

### ⚠️ 两条会卡死复刻的硬约束

**1. 驱动只存在于厂商内核，mainline 没有。**

> 原文：*"The driver is the gate: it is part of the vendor kernel, mainline has none,
> and nothing in userspace can work around its absence."*

这条比「NPU 默认关闭」严重得多。换成主线内核的发行版（大部分 Debian/Ubuntu 官方镜像），
**NPU 直接没有，用户态无解**。复刻时系统镜像不能随便换。

**2. Armbian 在每一块 Radxa Zero 3 上都把 NPU 节点关着。**

所以一块「原厂」板子是：硬件有、内核有、驱动有，**但没有 NPU**。

```bash
# 上游做法：随 robotctl update 的 preinstall hook 自动跑，失败不致命
sudo sh /opt/robot/daemon/current/scripts/setup-npu.sh
# 写 overlay → 必须重启 → 确认：
dmesg | grep rknpu
```

脚本要跑**发布包里那一份**，不能跑 `/usr/local/sbin/robot-setup-npu` ——
overlay 源文件和脚本放在一起，单独那份首次运行时旁边什么都没有。

### 鸭子检测器

模型训练在另一个仓库 `pollen-robotics/duck_detector`，到这边时已经是量化好的 `.rknn`。

> ⚠️ **该仓库并不公开**（2026-09-04 实测 404）。官方文档引用了它，但外部拿不到训练代码，
> 只能拿到成品 `.rknn`。想自己训就得从零搭 YOLO 训练流程。

| 项目 | 值 |
|---|---|
| 网络 | `yolo11n` @ **320×320** |
| 类别 | **1 类**（就是鸭子） |
| 训练集 | **3 个 session 共 150 帧** |
| mAP50 | **0.976**（留出 session 上） |
| INT8 量化后体积 | **3.9 MB** |
| 量化损失 | 桌面实测 2/2 检出，框重叠 95%（对比 float 模型） |

> 150 帧就能到 0.976 —— 单类别、固定目标、场景受限，这个量级的数据要求
> 对复刻者是好消息。

### 实测性能（Radxa Zero 3，2 Hz 节流，30 帧 × 3 轮）

| 项目 | 实测 | 说明 |
|---|---|---|
| 延迟 p50 / p95 | **25.7 ms / 58.4 ms** | 推理 + 解码，不含 JPEG 解码 |
| 每帧 CPU | 20.7 ms | **注意：这不是 NPU 的开销**，见下 |
| SoC 温度 | **63 °C** | 节流跑完时 |

**那个 CPU 数字很容易被误读。** 延迟列算的是 `infer` + `decode`；
CPU 列是整个循环的进程 CPU 除以帧数，因此**还包含 `letterbox_rgb`**——
一次 1280×720 → 320×320 的重采样，跑在 CPU 上，且完全不在延迟列里。
剩下的部分是不是 `rknn_run` 忙等（把 NPU 等待算到 CPU 头上），上游自己也还没测清楚。

> 2 Hz 下无论如何都只是**单核的 4%**。但在引用「感知的代价」之前，这两块得分开测。

关于 2 Hz 为什么是 2 Hz，见 [§八 值得抄的两个工程细节](#值得抄的两个工程细节)——
那是**热限制不是偏好**，满速会到 95 °C。

### 三个工程决策值得抄

**1. `dlopen` 而不是链接。** `librknnrt.so` 是厂商 blob，不在任何 Debian 源里；
一旦链接它，CI 里就没法交叉编译。代价是多写一个 `duck-detect/src/rknn.rs`，
好处是 `cargo board --bins` 在笔记本上照样能跑。`robotd` 加载 ONNX Runtime 用的是同一套办法。

**2. 让运行时做反量化。** 量化模型的输出张量是 int8 + scale + zero point。
`rknn_outputs_get` 可以直接转成 float，上游选择让它转 ——
另一条路是把 scale 带进解码器，**总有一天会悄悄算错一次**。

**3. 排查顺序是「能不能跑 → 还认不认得出 → 花多少钱」。**
`duck-bench` 就是按这个顺序报的。一个能跑但检不出任何东西的模型，
看起来和正常的一模一样。

> ⚠️ **量化模型的分数是另一套刻度。** float 模型的 0.5 不是这个模型的 0.5。
> 检不出东西时，先把 `--threshold` 调到 **0.2** 再怀疑转换坏了。

### 目前还缺什么

**机器人上没有任何东西能拿到一帧图像。** `mediad` 里有一条专为此存在的
raw NV12 tee 分支，但**没有 IPC 暴露它** —— 这也是为什么采集数据集必须先停掉 `mediad`
才能抢到摄像头。

上游给了两条路（不互斥）：一是加 `media.frame` 调用，返回单帧；
二是把检测器搬进 `mediad`，订阅 raw 分支、几 Hz 跑一次、把检测结果发到状态流上。

> 第二条是终局形态：**感知放在传感器旁边，输出特征而不是搬像素**。

### 对复刻者的结论

1. **系统镜像不能随便换** —— 必须是带 Rockchip 厂商内核的（Armbian 系）
2. 拿到板子第一件事是**开 NPU 节点并重启**，否则一切推理都在 CPU 上
3. 想自己训模型，**150 帧起步**就有可用精度，门槛比想象中低
4. 别指望现在就能从机器人上取帧做二次开发 —— **这条链路上游自己还没打通**

---

## 八、软件侧关键参数（复刻时必须对齐）

| 参数 | 值 | 说明 |
|---|---|---|
| 控制环 | **50 Hz** | 继承自原型（树莓派 Zero 2W 上定的），在 Radxa 上**从未重新验证过** |
| 策略接口 | `obs[1,61] → actions[1,14]` | 加载时校验，51 维旧版会被拒绝 |
| `action_scale` | 0.9（走）/ 0.8（轮滑） | |
| 位置 P 增益 | **200** | 站立时 ×0.8 |
| 动作低通 | head **0.5** / legs **0.7** | **必须与训练时一致**，否则迁移性能下降 |
| 电压自适应 | 默认关 | 开启后 `scale × (7.4 / 实测EMA)`，钳位 6.0–9.5 V |

### 值得抄的两个工程细节

**1. 预测性软着陆（`limp_fall`）**

不是等摔倒了才反应，而是**外推**：投影重力随躯干旋转，其变化率正好是
`-(ω × g)`，用同一个 12 字节 IMU 块里的陀螺数据外推 **300 ms**。
当机器人**已经**倾斜超过约 26°、**且仍在继续倒**、且外推落点越过阈值 →
立刻把增益从 200 降到 **50**，让关节顺着外力走，**软着陆**。
停稳后（用陀螺判断静止，不是定时）再用 600ms 把姿态拉回站姿，
最后才交还给站立策略。

> 理由写得很好：站立策略「很会站起来，很不会摔倒」——
> 从静止的俯卧/仰卧能干净地起身，但从动态摔倒中它会反复尝试并失败，
> 用走路的增益跟地板较劲，电机为每一次尝试买单。

**2. NPU 检测的 2 Hz 是热限制**

> 注释原文：*"2 is a thermal limit, not a preference"* —— 满速跑会到 **95°C**，
> CPU 降频到 **408 MHz**，那就成了「为了看得清而走不好」的机器人。

---

## 九、自己复刻这套电控要做什么

### ✅ 直接买现成的

| 部件 | 型号 | 备注 |
|---|---|---|
| 主控 | **Radxa Zero 3W** | 市售模块，**不是定制板** |
| 舵机 | Dynamixel XL330 × 15 | |
| 电池 | **索尼 NP-F550** + 卡座 | 通用摄像机电池，配件遍地。**别买 F970，装不进去** |
| 摄像头 | 树莓派 Camera v2（IMX219） | |
| ToF | VL53L8CX 模块（Stemma/Qwiic） | |

### 📥 直接下载官方工程的一块板

**RPI Robot HAT —— 不用画。**
[`pollen-robotics/elec_RPI_Robot_HAT`](https://github.com/pollen-robotics/elec_RPI_Robot_HAT)（Apache-2.0）
里有 `production/` 目录，Gerber、BOM、贴片坐标齐全，直接下单打样贴片即可。

若想简化（不要录音和喇叭），也可以整块不做 —— **但不能只省不补**：

- **舵机总线的半双工方向电路是必需的**（U5/U6/U7 那组三态缓冲，本文 §五之二 已论证「代码里没有方向控制 GPIO，这部分电路在 HAT 板上」）→ 需另配一块 ST/SC 系列总线转接板
- 配电 → 现成 5V UBEC
- ToF → 直接挂 i2c3

代价是失去板载音频与 Pi HAT+ 身份识别。采购见 [电控采购清单 §六](电控采购清单.md#六两块-pcb)。

### 🔧 唯一需要自己画的板

**`imu_to_dxl`** —— 全网无公开工程，这是**唯一必须自己重建**的一块。
LSM6DSV16X + 小 MCU（Dynamixel V2 从机）+ 半双工 TTL 收发器。
协议和 12 字节寄存器布局本文已完整给出，照着实现即可。

### ⚠️ 必须注意的坑

1. **i2c3 与 FUSB302 冲突** —— 用 pin 3/5 的硬件 I2C 就会失去 USB-C PD 协商
   （但普通 5V 充电仍可用）。见第四节。
2. **NPU 默认关闭** —— Armbian 出厂不开，要跑 rknn 模型得刷 overlay 并重启。
3. **摄像头装歪了四分之一圈** —— 软件里要 `rotate=90`，用硬件编码器做，别用
   `videoflip`（那是对每一帧做全 CPU 遍历）。
4. **控制环 50 Hz 在 Radxa 上没验证过** —— 官方自己承认是从树莓派 Zero 2W
   继承来的数字。

---

## 十、结论：这套电控是可以复刻的

我此前判断「RK3566 定制载板买不到，PCB 是硬墙」——**这个判断需要修正**：

- 主控是**市售的 Radxa Zero 3W**，不是定制载板
- **HAT 板官方已完整开源**（KiCad + Gerber + BOM），根本不用画
- 剩下的 `imu_to_dxl` 元件极少、协议已完整还原，是唯一要自己做的一块

**真正剩下的门槛是软件**：Rust 运行时虽然开源（Apache-2.0），但绑定
Radxa Zero 3W 的具体接线；如果你照着同样的主控做，**运行时可以直接跑**。

> 数据来源：`pollen-robotics/microduck` 的 `duck-control/src/{model,imu,bus}.rs`、
> `deploy/robotd.toml`、`deploy/audio/*.dts`、`deploy/overlays/*.dts`、
> `tof/src/*.rs`、`mediad/src/*.rs`、`docs/project/media-bringup.md`。
