FromAIToReality/OpenMicroDuck/docs/紧固件反推.md

> **上游技术参考，不是本项目实测结论。** 来源：[fanhao375/microduck-replica](https://github.com/fanhao375/microduck-replica/blob/a23f4c18a4741a3cde5257e639960ea37bbadd8d/docs/%E7%B4%A7%E5%9B%BA%E4%BB%B6%E5%8F%8D%E6%8E%A8.md)。保留原作者及贡献者署名；正文中的“本项目”、实物、照片和测试记录属于上游。与我们的硬件不一致时，以[本项目说明](hardware.md)为准。

# 紧固件反推

> 🛒 螺丝套装、热熔螺母与压头、螺纹胶的采购链接见 [机械采购清单](机械采购清单.md)。

**简体中文** · [English](fastener-reconstruction.en.md)

上游没有机械 BOM，也没有螺丝清单（HAT 板有电子 BOM，但不含结构件）。本文档是**从 47 个 STL 网格的几何特征反推**出来的结果。

## 方法

`scripts/analyze_holes.py`：

1. 焊接重复顶点，建面片邻接图
2. 按二面角 35° 切割，region-grow 出「光滑曲面片」（锐边处断开）
3. 每片拟合圆柱 —— 圆柱面法向都垂直于轴，所以**轴 = 法向协方差矩阵的最小特征向量**
4. 顶点投影到垂直轴的平面，Kåsa 代数圆拟合求直径，相对残差 >3% 的丢弃
5. 法向指向轴心 = **孔**；背离轴心 = 轴/凸台，排除
6. 统计包角，只保留 ≥300° 的完整圆孔

47 个零件全部扫描，耗时 2.5 秒。

## 结论：整机是 M2 螺丝系统

结构件上完整圆孔的直径分布：

| 直径 | 数量 | 判读 |
|---|---|---|
| **Ø2.2** | **77** | **M2 过孔**（标准 M2 clearance 2.2–2.4） |
| **Ø4.4** | **28** | **M2 沉头孔**（M2 内六角柱头 Ø3.8，沉孔 4.0–4.5） |
| **Ø1.6** | **20** | **M2 攻丝底孔**（M2 标准底孔正好 1.6） |
| Ø2.4 | 22 | M2 松配过孔 |
| Ø2.0 | 12 | M2 紧配过孔 |
| Ø2.7 / Ø2.8 | 20 | M2.5 过孔（少量） |
| Ø4.8 | 10 | M2 沉头孔（另一种沉孔深度） |
| Ø5.4 / Ø6.0 | 16 | 轴孔 / 轴承座，非螺丝 |

**Ø2.2 与 Ø4.4 成对出现**在 `yaw2roll`、`leg`、`ankle_left`、`neck_pitch`、`yaw_roll_motion` 上 ——
这是典型的**过孔 + 沉头孔**组合，确认用的是 **M2 内六角圆柱头螺丝**。

交叉验证：`xl330.stl` 自身有 **Ø2.0×4 + Ø1.6×8**，与 Dynamixel XL330 的 M2 安装孔一致。

## 逐件孔位统计

按各网格在整机中的实际引用次数加权：

| 网格 | 整机用量 | M2 过孔 | M2 底孔 | 沉头孔 |
|---|---|---|---|---|
| `xl330` | **×15** | 4 | 8 | — |
| `hip_l` | ×2 | 9 | — | 6 |
| `yaw2roll` | ×2 | 8 | — | 6 |
| `leg` | ×2 | 6 | — | 6 |
| `neck_pitch` | ×1 | 12 | — | 4 |
| `face_part` | ×1 | 10 | 4 | — |
| `ankle_left` / `ankle_right` | ×1 各 | 5 | — | 5 |
| `yaw_roll_motion` | ×1 | 4 | — | 6 |
| `power_support` | ×1 | — | 8 | — |
| `left_shell` / `right_shell` | ×1 各 | 7 / 6 | — / 1 | — |
| `bearing_roll` | ×2 | 4 | — | — |
| `neck` | ×2 | 4 | — | — |
| `upper_leg_rigidity_plate` | ×2 | 4 | — | — |
| `jaw` | ×1 | 5 | — | — |
| `trunk_base` | ×1 | 4 | — | — |
| `bottom_head_shell` / `top_head_shell` | ×1 各 | 4 / 3 | — | — |
| `m12_lens_holder` | ×1 | 3 | — | — |

> **`xl330` 出现 15 次** —— 整机 15 个舵机，不是 14 个。
> 14 个受策略控制，第 15 个驱动喙/下颚（在 `passive_*` 连杆里，不进动作空间）。
> 这与官方 README 的 "15 servos" 一致。

## 采购估算

- 整机 M2 级孔（Ø1.9–2.5 mm、包角 ≥300°）**按装配体用量加权合计 237 个**，
  其中 60 个在舵机本体上（15×4）、21 个在轴承/PCB/电池等标准件上，结构件上约 156 个

  > ⚠️ **勘误（2026-09-04）**：此前写「213 个」复算不出来。差异有两个来源：
  > 早期统计**未按装配体用量加权**（`leg` 实际 ×4、`hip_l`/`yaw2roll` 等 ×2），
  > 且**混入了未被任何 MJCF 引用的网格**。下面的孔径与深度分布表是**不加权**口径
  > （每个 STL 数一次），两张表不能直接相加。
- 扣掉舵机和外购件（轴承/PCB/电池），**结构件过孔约 146 个**

**建议采购量**（含损耗和试装）：

| 规格 | 建议数量 | 用途 |
|---|---|---|
| M2×4 内六角圆柱头 | 60 | 薄壁位（孔深 0–3mm 占 51/79） |
| M2×6 内六角圆柱头 | 80 | 主力规格 |
| M2×8 内六角圆柱头 | 40 | 孔深 3–5mm 位（24/79） |
| M2×12 内六角圆柱头 | 15 | 少量深孔（8–12mm，4 处） |
| M2 螺母 | 50 | 无攻丝处 |
| M2 热熔螺母 | 60 | 打印件推荐替代直接攻丝 |
| M2.5×6 | 20 | 少量 Ø2.7 孔位 |

螺丝长度依据 Ø2.2 孔的实测深度分布推算：0–3mm 共 51 个，3–5mm 共 24 个，8–12mm 共 4 个。

## 轴承

| 来源文件 | 实测尺寸 |
|---|---|
| `seeed_bearing__configuration__22x16x4` | **外径 22 × 内径 16 × 厚 4 mm** |
| `seeed_bearing__configuration_default` | 外径 15 × 内径 ~10 × 厚 3 mm（整机用 ×3） |

## ⚠️ 局限性

1. **这是从仿真网格反推的，不是工程图纸。** 仿真网格只保证外形与惯量正确，
   不保证配合公差、螺纹细节完整。
2. **打印收缩会改变实际孔径。** Ø2.2 的设计孔在 FDM 上通常打出来偏小 0.1–0.3mm，
   实际装配前务必先打试件校验。
3. **沉头孔与过孔可能被重复计数**（同一颗螺丝的两个特征），
   螺丝数量以「过孔」为准，沉头孔不单独计。
4. **未识别的特征**：非圆形孔（腰孔、异形槽）、包角 <300° 的部分圆弧、
   直径 >14mm 的大开口均不在统计内。
5. 螺丝**长度**是按孔深推算的区间，非实测值。
