FromAIToReality/OpenMicroDuck/docs/status.md

# 安全与验证状态

日期：2026-09-28。

## 本轮范围

资料筛选、来源保留、同内容参数去重、文档链接整理及 CAD 附件完整性验证。仓库发布不意味着机器人已经可安全运行。

## 安全边界

- `tools/servo-web/directions.json` 和 `poses/` 是上游样例，不是我们实机标定。第一次只能使用模拟模式或经审查的只读检查。
- 该工具有开扭矩、写寄存器、改 ID、零点校准功能。没有核对机械状态和供电前不要启用。
- 未通过逐关节验证，不直接运行站立、折叠或训练策略；运动前卸载或可靠支撑，具备断电手段。
- IMU 预编译 HEX 是上游产物，本轮未重新编译或刷入。针序和板卡必须一致，不能把传感器模块当完整桥接板。
- 训练工程中的测试记录是上游作者的记录。本地做过的检查仅以本仓库发布验证文档为准。

## 后续里程碑

- [ ] 确认供电、控制模块和舵机固件/模式。
- [ ] 单舵机读回、低速小幅运动、中位及方向验证。
- [ ] 完成 IMU 与 ZERO 3W 接入。
- [ ] 测量整机质量、零位、方向、限位，更新训练模型。
- [ ] GPU 配置检查和短训练；检查 ONNX 输入输出和关节顺序。
- [ ] 带保护的实机部署与步态验证。
