FromAIToReality/OpenMicroDuck/docs/HD-1910-M6参数来源.md

> **上游技术参考，不是本项目实测结论。** 来源：[fanhao375/microduck-replica](https://github.com/fanhao375/microduck-replica/blob/a23f4c18a4741a3cde5257e639960ea37bbadd8d/docs/HD-1910-M6%E5%8F%82%E6%95%B0%E6%9D%A5%E6%BA%90.md)。保留原作者及贡献者署名；正文中的“本项目”、实物、照片和测试记录属于上游。与我们的硬件不一致时，以[本项目说明](hardware.md)为准。

# HD-1910 M6 参数来源与应用

2026-09-24：本项目采用 **LuwuDynamics 公开的 1910 BAM M6 动力学参数**，作为
HD-1910 仿真训练的初始模型。感谢 LuwuDynamics 的分享。参数不是本项目自行
辨识或测量的结果；本项目目前做的是接入和验证，实机测试由维护者后续进行。

## 引用与许可

| 项目 | 固定来源 |
|---|---|
| 作者 / 发布组织 | [LuwuDynamics](https://github.com/LuwuDynamics) |
| 仓库 | [xgoduck_rl](https://github.com/LuwuDynamics/xgoduck_rl) |
| 版本 | `326d77a1122870bdefa2c36403937502c958e69c` |
| 参数 | [`src/mjlab_microduck/robot/xgoduck/params/1910_m6.json`](https://github.com/LuwuDynamics/xgoduck_rl/blob/326d77a1122870bdefa2c36403937502c958e69c/src/mjlab_microduck/robot/xgoduck/params/1910_m6.json) |
| 训练配置 | [`xgoduck_constants.py`](https://github.com/LuwuDynamics/xgoduck_rl/blob/326d77a1122870bdefa2c36403937502c958e69c/src/mjlab_microduck/robot/xgoduck_constants.py) |
| 许可证 | [Apache-2.0](https://github.com/LuwuDynamics/xgoduck_rl/blob/326d77a1122870bdefa2c36403937502c958e69c/LICENSE) |
| 参数原文件 SHA-256 | `ef2d51adfb1cc0831b9b02ca19aa9176fceecdf725148d084378d7d9a64afceb` |

模型和辨识框架来自 [Rhoban/BAM](https://github.com/Rhoban/bam)；本地训练框架和
Microduck 几何来自 [Pollen Robotics/microduck_rl](https://github.com/pollen-robotics/microduck_rl)。
以上项目的来源和许可分别保留。使用这套参数自行训练策略，仍需引用 LuwuDynamics
的舵机参数；只有以后独立辨识得到的新参数，才可另行标注为本项目辨识结果。

## 怎么用

训练代码、参数、模型和接入修复统一放在本仓库 **[`software/training/`](../software/training/)**，
克隆或下载本仓库即可取得完整工程。[使用说明与验证记录](../software/training/docs/hd1910-baseline.md)
包含命令、测试结果，以及飞特控制器目标历史初始化问题的原因和修复。

- 参数文件原样保存，保留 `model: "m6"` 和 `actuator: "sts3215"`；后者选择
  BAM 的飞特控制器实现。上游把型号写作 HLS1910，维护者已确认采用同款 1910。
- 配套训练设置：P=5、电压随机范围 7.4–8.0 V、压降下限 7.0 V、延迟 3–6 个
  仿真步。`max_velocity=100` 用于放开目标斜率限制，并不是舵机真实空载转速。
- 新增独立的 `Mjlab-Velocity-{Flat,Rough}-MicroDuck-HD1910` 训练入口，便于与
  原 XL330 基线比较。当前接入保留本地 Microduck 几何、关节顺序和默认姿态。
- 实机逐关节零位、方向和限位仍使用本项目校准结果；不复制对方整机的编码器
  零位或现成 ONNX 作为可直接上机的策略。

## 当前验证边界

公开参数使我们可以开始仿真接入，不再把完整自建辨识台架作为启动仿真的前置。
本项目尚未用实机验证这组参数。还需核对本机增益、供电、响应延迟、质量惯量、
IMU 和主控通信时序；先用小幅阶跃响应比较仿真与实物，再决定是否重新辨识。

其他静态和动态数据要求见[训练前数据清单](HD-1910训练前数据清单.md)。
当前新增的训练基线使用这里注明来源的 M6 参数。
