FromAIToReality/OpenMicroDuck/tools/radxa/镜像使用说明.md

> **烧卡风险：** 本轮未执行脚本或验证板卡兼容性。写卡可能清空目标存储，请先核对设备；示例账户密码公开，首次使用必须更改。

> **上游技术参考，不是本项目实测结论。** 来源：[fanhao375/microduck-replica](https://github.com/fanhao375/microduck-replica/blob/a23f4c18a4741a3cde5257e639960ea37bbadd8d/tools/radxa/%E9%95%9C%E5%83%8F%E4%BD%BF%E7%94%A8%E8%AF%B4%E6%98%8E.md)。保留原作者及贡献者署名；正文中的“本项目”、实物、照片和测试记录属于上游。与我们的硬件不一致时，以[本项目说明](../../docs/hardware.md)为准。

# Radxa Zero 3W · 能开机的 Armbian 卡（镜像使用说明）

这张镜像解决一件事：**Armbian 官方镜像在 Radxa Zero 3W V1.12 上起不来**（灯双闪、永远进不了系统、局域网里找不到），
换上瑞莎自家的引导程序就好了。内核和系统一个字节没改，还是 Armbian 官方的。

镜像烧完开机 1~2 分钟就能用，**不带 WiFi 配置**（公开镜像不方便写别人的 WiFi 密码），板子插电脑的那根 USB 线同时是串口，进去自己连网。

- 适用：**Radxa Zero 3W V1.12**（2024-11 以后出厂、AIC8800D80 WiFi 那批），别的批次见下面第 6 节
- 底包：Armbian 26.2.1 Trixie vendor 内核 6.1.115 minimal（官方原版）
- 为什么会这样、怎么定位的：[踩坑记录](../../踩坑记录.md#软件)

## 1. 跟官方 Armbian 镜像的区别

只改了四处，都是踩出来的：

| 改了什么 | 为什么 |
|---|---|
| 引导程序换成瑞莎 `u-boot-rk2410`（`idbloader.img` @扇区 64、`u-boot.itb` @扇区 16384） | Armbian 配的主线 U-Boot 2025.10 + 2024-01 的内存初始化固件在 V1.12 上起不来；瑞莎是 rk U-Boot 2017.09 + DDR v1.23 + BL31 v1.45 |
| 写 `/boot/extlinux/extlinux.conf` | 瑞莎 U-Boot 走 extlinux，不读 Armbian 的 `boot.scr` |
| 挂 `uart2-m0` 和 `dwc3-peripheral` 两个 overlay，内核控制台放 `tty1` | 前者出 `/dev/ttyS2`（40 脚上的串口，接舵机用），后者让 OTG 口插电脑变成串口；内核日志不再往舵机总线上打 |
| 开 `g_serial` + `ttyGS0` 登录控制台，关掉 `ttyS2` / `ttyFIQ0` 上的登录控制台 | 插电脑就能登录，没网也能救；`agetty` 占着 `ttyS2` 舵机怎么都不通 |

## 2. 烧卡

用 Rufus、balenaEtcher、Armbian Imager 任意一个，8 GB 以上的卡。先校验一下下载对不对：

```powershell
# Windows PowerShell
Get-FileHash .\armbian-26.2.1-zero3w-v1.12-bootfix-20260920.img.xz -Algorithm SHA256
```

```bash
# Linux / macOS
sha256sum armbian-26.2.1-zero3w-*.img.xz
```

跟 release 页面上的 `SHA256` 对得上再烧。Rufus 能直接烧 `.img.xz`，不用自己解压。

## 3. 第一次开机

1. 卡插板子，USB 口（靠中间那个，标 USB 3.0 的）用数据线插电脑。
2. 等 1~2 分钟，电脑设备管理器里会多一个 **COM 口**（USB 串口设备）。用 PuTTY / MobaXterm / 串口助手打开，**115200 8N1**，回车。
3. 登录：用户名 `duck`，密码 `duck1234`（root 密码也是 `duck1234`）。
4. **第一件事改密码**：

```bash
passwd            # 改 duck 的
sudo passwd root  # 改 root 的
```

串口里看不到启动日志是正常的：内核日志被放到 `tty1` 了，串口只给登录用。

## 4. 连 WiFi

板子没有网口，只能 WiFi。登录后按下面这套写（**V1.12 + AIC8800 实测能连的就是这套**，板子上 `/root/先连WiFi.txt` 里有同样的内容）：

```bash
sudo tee /etc/wpa_supplicant/wpa_supplicant-wlan0.conf >/dev/null <<'CONF'
ctrl_interface=DIR=/run/wpa_supplicant GROUP=netdev
update_config=1
country=CN

network={
    ssid="你的WiFi名"
    psk="你的WiFi密码"
    key_mgmt=WPA-PSK
    pairwise=CCMP
    ieee80211w=0
    scan_ssid=1
    priority=10
}
CONF
sudo chmod 600 /etc/wpa_supplicant/wpa_supplicant-wlan0.conf
sudo systemctl enable --now wpa_supplicant@wlan0
ip a show wlan0     # 看有没有拿到 IP
```

拿 IP 靠系统自带的 `/etc/netplan/10-dhcp-all-interfaces.yaml`，不用另外配。

**`pairwise=CCMP` 和 `ieee80211w=0` 这两行别删。** AIC8800 不支持 GCMP-256，路由器开 WPA2/WPA3 混合模式时，
WPA3 那半用 GCMP-256，不写这两行握手直接失败。真连不上就把路由器改成纯 WPA2。2.4G、5G 都能连。

也可以 `sudo nmtui` 图形界面选（系统里装了 NetworkManager）。连不上就回到上面那套，多半还是 WPA3 的问题。

连上以后路由器里找 `radxa-zero3`，之后 `ssh duck@板子IP` 就行，不用再插串口。

嫌麻烦不想每次手动连：用仓库里的做卡脚本，烧卡前就把 WiFi 写进去 ——
[`build-armbian-card.sh`](build-armbian-card.sh)，`card.conf` 里填上 WiFi 名和密码，自己生成一张带网的卡（这张公开镜像就是用同一个脚本、WiFi 留空做的）。

## 5. 舵机串口

`/dev/ttyS2` 已经准备好了（40 脚的 8 号 TX、10 号 RX），登录控制台和内核日志都从上面拿掉了。

注意：**RK3566 的 UART 是全双工 3.3 V 两根线，飞特 / Dynamixel 总线是单线半双工**，中间要加三态缓冲或者转接板，直接飞线是收不到应答的。见[踩坑记录](../../踩坑记录.md#飞线不打-hat-时)。

## 6. 如果你的板子不是这一批

Zero 3W 出过好几批，板子上的 WiFi 模块和设备树都换过。判断方法：这张卡烧进去进不了系统，但**瑞莎官方镜像能起**。

### V1.12J（2026-09 这批，AIC8800DS2）—— 已经有人跑通了

一位群友实测：**光换引导还不够，设备树也得用瑞莎的**。Armbian 自带的 `rk3566-radxa-zero3.dtb` 不认这批板子，
瑞莎 B1 镜像里那份（Zero 3W AIC8800DS2）认；两边都是 6.1 的 vendor 内核，所以瑞莎的 DTB 能配 Armbian 的内核跑。
成品是：**B1 的引导 + B1 的 DTB + Armbian 6.1.115 内核 + Trixie 系统**。

三步（`/dev/sdX` = 烧好瑞莎 B1 官方镜像的卡，`/dev/sdY` = 烧好这张 Armbian 卡的卡，**别搞错盘**）：

```bash
# 1) 扒 B1 的引导，写进 Armbian 卡
sudo dd if=/dev/sdX of=idbloader.img bs=512 skip=64    count=16320
sudo dd if=/dev/sdX of=u-boot.itb    bs=512 skip=16384 count=16384
sudo dd if=idbloader.img of=/dev/sdY bs=512 seek=64    conv=notrunc
sudo dd if=u-boot.itb    of=/dev/sdY bs=512 seek=16384 conv=notrunc

# 2) 把 B1 的 DTB 拷到 Armbian 卡（文件名以 B1 镜像里的为准，找 Zero 3W 那份）
sudo mount /dev/sdX1 /mnt/b1 ; sudo mount /dev/sdY1 /mnt/armbian
ls /mnt/b1/boot/dtbs/*/rockchip/ | grep -i zero3
sudo cp /mnt/b1/boot/dtbs/*/rockchip/rk3566-radxa-zero3.dtb /mnt/armbian/boot/dtb/rockchip/rk3566-radxa-zero3-b1.dtb

# 3) extlinux 的 fdt 指向它
sudo sed -i 's|^  fdt .*|  fdt /boot/dtb/rockchip/rk3566-radxa-zero3-b1.dtb|' /mnt/armbian/boot/extlinux/extlinux.conf
sync; sudo umount /mnt/b1 /mnt/armbian
```

换成瑞莎的 DTB 以后**验两件事**，因为 overlay 是 Armbian 那边的，节点对不对得上要看：

- `ls /dev/ttyS2` 在不在（40 脚的舵机串口，`uart2-m0` overlay 起没起作用）
- 板子插电脑还有没有 COM 口（`dwc3-peripheral` overlay）

对不上就把 `fdtoverlays` 那行去掉，改用瑞莎自己的 overlay（B1 镜像的 `/boot/dtbo/` 里），或者直接在瑞莎的 DTB 上改。

### 其它批次

同样的思路：**引导 + DTB 都从你自己能启动的那张官方卡里拿**，内核和根文件系统留 Armbian 的。
还是不行就接 40 脚的调试串口（3.3 V USB-TTL，1500000）看 U-Boot 输出，或者在
[issue](https://github.com/fanhao375/microduck-replica/issues) 里说清楚板子版本、WiFi 模块、卡在哪一步。

### 已知问题

- **V1.12J 冷启动插着 HDMI 起不来**（群友反馈，按上面三步改好之前的状态）。如果碰到：先不插 HDMI 冷启动，
  起来后再插；或者在 extlinux 的 `append` 末尾加 `video=HDMI-A-1:d` 关掉 HDMI 输出。
  我们这张镜像的内核控制台是 `console=tty1`（走显示），跟这个有关。

## 7. 来源与许可

- 底包：[Armbian 官方 Radxa Zero 3 镜像](https://www.armbian.com/radxa-zero-3/)，26.2.1 Trixie vendor 6.1.115 minimal，原样使用，GPL 及各自许可
- 引导：瑞莎 [`u-boot-rk2410`](https://radxa-repo.github.io/bookworm/pool/main/u/u-boot-rk2410/) `2017.09-64-39cd993`，取 `idbloader.img` 和 `u-boot.itb`，GPL-2.0
- 改动全部在 [`build-armbian-card.sh`](build-armbian-card.sh) 里，脚本是开源的，可以自己跑一遍复现这张镜像

这张镜像是社区自制的，**跟 Armbian 和瑞莎官方都没关系**，出了问题别去找他们，来这个仓库开 issue。
