FromAIToReality/OpenMicroDuck/assets/community/wechat-diy-2026-09-28.png

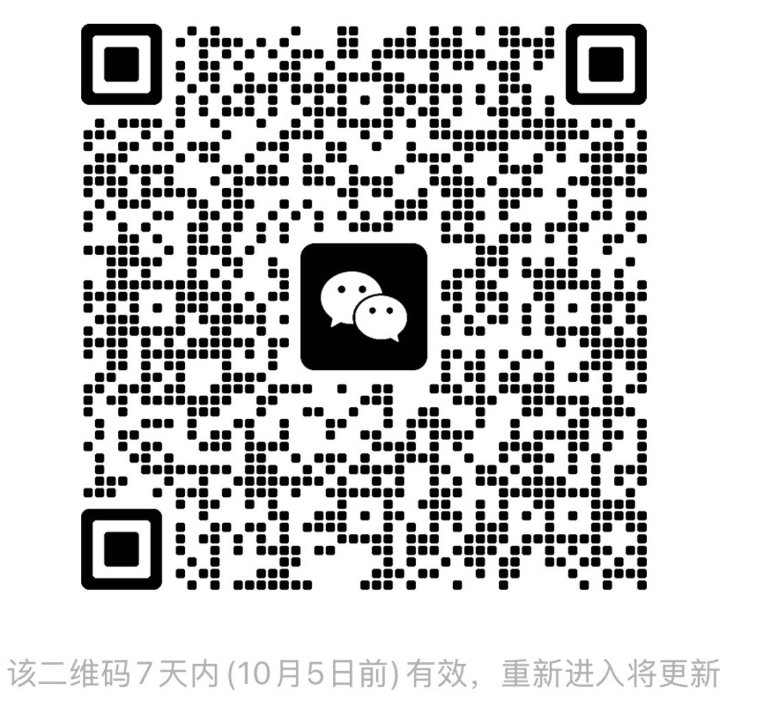
assets/community/wechat-diy-2026-09-28.png
