FromAIToReality/OpenMicroDuck/docs/HD-1910训练前数据清单.md

> **上游技术参考，不是本项目实测结论。** 来源：[fanhao375/microduck-replica](https://github.com/fanhao375/microduck-replica/blob/a23f4c18a4741a3cde5257e639960ea37bbadd8d/docs/HD-1910%E8%AE%AD%E7%BB%83%E5%89%8D%E6%95%B0%E6%8D%AE%E6%B8%85%E5%8D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)。保留原作者及贡献者署名；正文中的“本项目”、实物、照片和测试记录属于上游。与我们的硬件不一致时，以[本项目说明](hardware.md)为准。

# HD-1910 训练前数据清单 · 已填版

**简体中文**

> 算法侧给的采集清单（2026-09-11，单舵机版）—— 这份是**把仓库里已有的数全填上、标明出处**，剩下真要上台架的标 **待实测**。
> 算法拿到的不该是空表：几何、质量、惯量、关节、舵机规格、IMU 安装，仓库早就有。

**标记**：【MJCF】上游 `robot_walk.xml` · 【规格书】飞特《HD-1910-C001 串型规格书》A/0 · 【源码】上游 `duck-control/src/model.rs` · 【逆向】[硬件方案逆向](硬件方案逆向.md) · 【STL】仓库 STL 实量 · **待实测**

> ⚠️ **几何、质量、惯量全部是 XL330 版的仿真值。** 换飞特之后至少四处不一样：
>
> | | XL330 | HD-1910 | 影响 |
> |---|---|---|---|
> | 单只质量 | 18 g | **21 g** | 15 颗 +45 g，各刚体质心挪 |
> | 外形 | 20 × 34 × 26 | **34 × 20 × 23** | 薄 3 mm，压腿处结构件已改 |
> | 堵转力矩 @7.4V | 0.6 N·m | **1.47 N·m** | BAM 模型重新辨识 |
> | 减速比 / 回差 | 未公开 | **320:1 / ≤0.5°** | 摩擦、回差模型重测 |
>
> **装机后实称实量覆盖这里的数** —— 差多少就是重训的理由。

---

## 一、静态数据

### 1. 机器人几何 —— 零位姿态、躯干坐标系（X 前 · Y 左 · Z 上）、mm

| 项 | 值 | 出处 |
|---|---|---|
| **两髋中心距离** | 髋 **yaw** 轴距 **35.0**；髋 **pitch** 轴距 **85.0**（腿运动学用这个） | 【MJCF】正向运动学 |
| **左 / 右大腿**（髋 pitch → 膝） | **42.2** / **42.2** | 【MJCF】 |
| **左 / 右小腿**（膝 → 踝） | **49.4** / **49.4** | 【MJCF】 |
| 髋 yaw → roll / roll → pitch | 20.7 / 31.1 | 【MJCF】 |
| **脚底尺寸**（`sole_left`，打印件包围盒） | 长 **54.0** × 宽 **41.1** × 厚 **12.9** | 【STL】左右对称；实际接触面看 foot + sole 装配后的底面 |
| **躯干尺寸**（`01_躯干主体` 装配体包围盒） | 长 **86.1** × 宽 **81.3** × 高 **64.0** | 【STL】含壳和髋部舵机 |
| 电池（NP-F550）位置 | X −55.3 … −16.7，Y ±10.3，Z −39.3 … +31.6 → 中心 **(−36, 0, −4)**，39 × 21 × 71 | 【逆向】MJCF 变换后实测 |
| `imu_to_dxl` 板位置 | 锁扣 `banana_pcb_locker` 处，X −32.3 … −28.5，Y ±27，Z +31.5 … +38.1，**竖装** | 【逆向】 |
| 主控 Radxa + 转接板 | *待装机后量* —— 不打 HAT 时位置自定 | **待实测** |

**关节轴位置与方向**（零位姿态、躯干系）：

| 关节 | 中心 X / Y / Z | 轴向 | 关节 | 中心 X / Y / Z | 轴向 |
|---|---|---|---|---|---|
| `left_hip_yaw` | 6.0 / 17.5 / −5.0 | −Z | `right_hip_yaw` | 6.0 / −17.5 / −5.0 | −Z |
| `left_hip_roll` | 22.5 / 17.5 / −17.5 | +X | `right_hip_roll` | 22.5 / −17.5 / −17.5 | +X |
| `left_hip_pitch` | 4.0 / 42.5 / −17.5 | +Y | `right_hip_pitch` | 4.0 / −42.5 / −17.5 | −Y |
| `left_knee` | −31.8 / 38.5 / −39.5 | −Y | `right_knee` | −31.8 / −38.5 / −39.5 | +Y |
| `left_ankle` | −31.8 / 64.5 / −81.5 | +Y | `right_ankle` | −31.8 / −64.5 / −81.5 | −Y |
| `neck_pitch` | 26.0 / 14.5 / 32.4 | −Y | `head_yaw` | 26.0 / 0.0 / 101.1 | +Z |
| `head_pitch` | 26.0 / 14.5 / 82.4 | +Y | `head_roll` | 8.1 / 0.0 / 115.6 | −X |

左右腿 pitch / knee / ankle 的轴向**符号相反** —— 镜像装配，MJCF 里就这么定义的。实物 +5° 核对方向时对着这张表。

### 2. 质量、重心与惯量 —— 【MJCF】XL330 版仿真值

| 刚体 | 质量 g | 质心（躯干系 mm） | 对应算法清单里的 |
|---|---|---|---|
| `trunk_base` | **199.2** | −22.6 / 0.0 / 2.8 | 躯干 |
| `yaw2roll` ×2 | 23.0 | 7.0 / ±17.5 / −21.9 | 髋 yaw 件（含舵机） |
| `hip_l` ×2 | 6.2 | 14.2 / ±32.3 / −17.5 | 髋 roll 件 |
| `upper_leg_left/right` | **48.2** | −18.9 / ±56.0 / −24.3 | **大腿** |
| `leg` / `leg_2` | **21.6** | −31.8 / ±48.0 / −71.4 | **小腿** |
| `ankle_left/right` | **30.0** | −25.6 / ±48.8 / −95.2 | **脚** |
| `neck` | 36.8 | 26.0 / 0.3 / 57.4 | 头颈 ┐ |
| `neck_pitch` | 5.7 | 26.0 / 0.0 / 94.1 | 头颈 │ 合计 **279.9** |
| `yaw_roll_motion` | 48.6 | 25.8 / −5.0 / 118.9 | 头颈 │ |
| `jaw_soft` | 188.8 | 40.6 / 1.2 / 120.2 | 头颈 ┘（含头壳、摄像头、HAT 那颗 BMI088） |
| **整机** | **737.1** | | 与 [执行器选型](执行器选型.md) 的 737 g 一致 |
| 电池 NP-F550 | *待称*（典型 ~100 g；是否已含在 trunk_base 里**待核**） | | |

**转动惯量**（kg·m²，各刚体自身质心系，MJCF `fullinertia` 顺序 Ixx Iyy Izz Ixy Ixz Iyz）：

```
trunk_base       1.240e-4  1.459e-4  1.154e-4   7.2e-8  -2.07e-5   1.3e-7
upper_leg_left   1.688e-5  1.037e-5  1.983e-5  -4.42e-6  2.28e-7   3.89e-7
leg              5.251e-6  2.155e-6  4.339e-6   0        0         7.65e-7
ankle_left       5.915e-6  1.115e-5  7.740e-6  -2.05e-7  8.2e-8    5.7e-8
yaw2roll         4.196e-6  3.418e-6  2.327e-6   0        0        -5.1e-8
hip_l            8.606e-7  1.158e-6  6.516e-7   0        3.90e-7   0
neck             1.729e-5  3.127e-6  1.637e-5   0        0         0
neck_pitch       1.092e-6  9.669e-7  5.121e-7   0        0         0
yaw_roll_motion  6.979e-6  8.103e-6  9.579e-6   3.22e-7 -3.5e-8    3.43e-7
jaw_soft         3.208e-4  2.541e-4  1.499e-4  -6.3e-7   6.57e-6   4.18e-6
```

右侧刚体对称（Ixy、Iyz 变号）。**HD-1910 装机后**：按实称质量缩放，或用同事的 SolidWorks 装配体（[microduck-replica-cad](https://github.com/fanhao375/microduck-replica-cad)）重算质量属性。

### 3. 14 个策略关节标定

动作序号 = 策略 14 维输出的下标（【源码】`JOINT_NAMES` 顺序，嘴不在内）。默认站立角 = 【源码】`DEFAULT_POSITION`。安全极限 = 【MJCF】`range`。

| 序号 | 关节 | 舵机 ID | 正方向 | 编码器零位 | 软件偏置 | 默认站立角 | 机械最小 | 机械最大 | 安全最小 | 安全最大 |
|---:|---|---|---|---|---|---|---|---|---|---|
| 0 | `left_hip_yaw` | **20** | *待标（+5° 核对）* | 2048（中位校准后） | 0（校准后）／官方 `motor.rs` 待读 | **+0.0°** | *待测* | *待测* | -25° | 30° |
| 1 | `left_hip_roll` | **21** | *待标（+5° 核对）* | 2048（中位校准后） | 0（校准后）／官方 `motor.rs` 待读 | **-5.0°** | *待测* | *待测* | -22° | 22° |
| 2 | `left_hip_pitch` | **22** | *待标（+5° 核对）* | 2048（中位校准后） | 0（校准后）／官方 `motor.rs` 待读 | **-26.2°** | *待测* | *待测* | -90° | 90° |
| 3 | `left_knee` | **23** | *待标（+5° 核对）* | 2048（中位校准后） | 0（校准后）／官方 `motor.rs` 待读 | **-0.3°** | *待测* | *待测* | -90° | 90° |
| 4 | `left_ankle` | **24** | *待标（+5° 核对）* | 2048（中位校准后） | 0（校准后）／官方 `motor.rs` 待读 | **+26.0°** | *待测* | *待测* | -90° | 90° |
| 5 | `neck_pitch` | **30** | *待标（+5° 核对）* | 2048（中位校准后） | 0（校准后）／官方 `motor.rs` 待读 | **+20.0°** | *待测* | *待测* | -90° | 60° |
| 6 | `head_pitch` | **31** | *待标（+5° 核对）* | 2048（中位校准后） | 0（校准后）／官方 `motor.rs` 待读 | **+20.0°** | *待测* | *待测* | -90° | 90° |
| 7 | `head_yaw` | **32** | *待标（+5° 核对）* | 2048（中位校准后） | 0（校准后）／官方 `motor.rs` 待读 | **+0.0°** | *待测* | *待测* | -170° | 170° |
| 8 | `head_roll` | **33** | *待标（+5° 核对）* | 2048（中位校准后） | 0（校准后）／官方 `motor.rs` 待读 | **+0.0°** | *待测* | *待测* | -25° | 25° |
| 9 | `right_hip_yaw` | **10** | *待标（+5° 核对）* | 2048（中位校准后） | 0（校准后）／官方 `motor.rs` 待读 | **+0.0°** | *待测* | *待测* | -30° | 25° |
| 10 | `right_hip_roll` | **11** | *待标（+5° 核对）* | 2048（中位校准后） | 0（校准后）／官方 `motor.rs` 待读 | **+5.0°** | *待测* | *待测* | -22° | 22° |
| 11 | `right_hip_pitch` | **12** | *待标（+5° 核对）* | 2048（中位校准后） | 0（校准后）／官方 `motor.rs` 待读 | **+26.2°** | *待测* | *待测* | -90° | 90° |
| 12 | `right_knee` | **13** | *待标（+5° 核对）* | 2048（中位校准后） | 0（校准后）／官方 `motor.rs` 待读 | **+0.3°** | *待测* | *待测* | -90° | 90° |
| 13 | `right_ankle` | **14** | *待标（+5° 核对）* | 2048（中位校准后） | 0（校准后）／官方 `motor.rs` 待读 | **-26.0°** | *待测* | *待测* | -90° | 90° |

**零位定义**：机器人笔直站立（腿是直柱、脚平、颈竖直、头平视）= 所有关节 0 = 舵机 2048。站立角是从零位加的偏移，**不是零位**。标定步骤见 [调试记录 · 第 9 步](../调试记录.md)。

嘴（ID 34）不在策略里：闭 −5° / 开 +30°（【源码】`MOUTH_CLOSED / MOUTH_OPEN`）。

### 4. HD-1910 基础参数 —— 【规格书】A/0，7.4 V 档（括号内 6 V）

| 项 | 值 |
|---|---|
| 精确型号 | **HD-1910-C001**（机械图纸标 HD-1910M-C001，2026-09-02） |
| 工作电压 | **4 – 8.4 V** ⚠️ NP-F550 满电 8.4 V 正好顶格 |
| 编码器分辨率 | **4096** counts/rev（12 bit 磁编码，0.088°/step） |
| 减速比 | **320 : 1** |
| 齿轮虚位 | ≤ 0.5°（厂家值；实测回差见二·5） |
| 通信协议 | 飞特 SCS/STS 串行总线，半双工 TTL 单线，8N1，帧头 `FF FF` |
| 波特率 | **1,000,000** bps（出厂默认；范围 38400 – 1M） |
| 控制模式 | **模式 4「纯位置 PD（Sim2Real）」**（出厂默认）；另有 0 角度伺服 / 1 恒速 / 2 恒流 / 3 PWM（规格书写法；通用 STS 内存表是 2 PWM / 3 步进，以实机读出的底账为准） |
| P / I / D 增益 | 寄存器 **21 / 23 / 22**（STS 通用）。默认值 **待读舵机**；官方 XL330 固件 kp = 200，对标用 |
| 最大速度 | 空载 **113 RPM = 11.8 rad/s** @7.4V（92 RPM @6V）；固件限速寄存器 46（目标速度）**待读** |
| 最大 PWM / 输出 | 寄存器 16「最大力矩」，0.1% 单位，默认 1000 = 100% **待读** |
| 最大电流 | 过流保护**默认关**，阈值默认 0.5 A / 2 s 可设；堵转 **2.0 A** @7.4V（1.6 A @6V）；额定 900 mA（690 mA） |
| Kt | 7.5 kg·cm/A（0.74 N·m/A） |
| 堵转力矩 | **15 kg·cm = 1.47 N·m** @7.4V（12 kg·cm @6V）；额定 3.7 kg·cm = 0.363 N·m |

**换算关系**（STS 系列内存表惯例；**HD-1910 逐项待核对规格书 7-x 或实读**）：

| 量 | 寄存器 | 换算 |
|---|---|---|
| 位置 | 56（当前）/ 42（目标） | rad = (raw − 2048) × 2π / 4096 |
| 速度 | 58（当前）/ 46（目标） | raw 为 steps/s，bit 15 为方向 → rad/s = raw × 2π / 4096 |
| 负载 | 60 | **无量纲**，0.1% 满力矩，bit 10 为方向（0–1000 → 0–100%） |
| 电流 | 69 | STS3215 为 **6.5 mA/unit**；**HD-1910 待核对** |
| 电压 | 62 | **0.1 V** /unit |
| 温度 | 63 | **1 ℃** /unit |
| 使能 | 40 | 1 开 0 关。内存表写着「写 128 = 中位校准」，但 **HD-1910（固件 3.46）实测不认**：2026-09-20 四轮 15 颗，解锁且扭矩关着写 128，偏移一个没变，舵机照样回成功。协议手册 4.9 的表里 HLS ≥3.43 也是「不支持写 128」。校零走 **0x0B 位置校准指令**（可带设定值），见 [servo-web](../tools/servo-web/) |

### 5. IMU 与足底

| 项 | 值 | 出处 |
|---|---|---|
| IMU 型号 | **LSM6DSV16X**（自制 `imu_to_dxl` 板，总线 ID 200，SFLP 硬件融合出四元数） | 【逆向】 |
| 安装方向 | 芯片 **+Z → 躯干 +X**，芯片 +Y → 躯干 +Y，芯片 −X → 躯干 +Z（绕 Y +90°）；板子竖装、元件面朝前 | 【逆向】上游 `SflpDecoder` mount |
| 安装位置 | MJCF `imu` site 躯干系 **(−21.0, 0.1, −14.7)**；实物在锁扣处 X ≈ −30，**装机后量** | 【MJCF】【逆向】 |
| 足底材料 | 打印件 `sole_left/right`，**材料按打印设置**（官方未指定；jaw / mouth 才是 TPU） | 【BOM】 |

---

## 二、动态数据 —— 全部 **待实测**，下面是台架和前置

### 1. BAM 单舵机摆锤辨识

四条轨迹（`sin_time_square` / `lift_and_drop` / `up_and_down` / `sin_sin`）是 [BAM](https://github.com/Rhoban/bam) 工具的标准激励。官方 XL330 用 BAM **M6** 模型，参数（【逆向】`microduck_constants.py`）：`kp_fw=200`、`vin_range=(6.5, 8.2)`、`vin_min=6.0`、`delay 3–6 步`。

**推荐组合**（按 2S 电池工作区间和官方口径）：

| | 值 | 理由 |
|---|---|---|
| 电压 ×3 | **6.6 / 7.4 / 8.2 V** | 电池放空 / 标称 / 满电（避开 8.4 顶格） |
| P ×4 | 舵机默认 / 100 / **200** / 300 | 200 对标官方 XL330 固件 |
| 摆长 ×2 | 0.10 / 0.15 m | 与腿长（42 + 49 mm）同量级 |
| 负载 ×3 | 0 / 0.05 / 0.10 kg | 单腿 ~100 g |
| 采样 | **50 Hz**（与控制周期一致），每段 20 s | |

**台架**：URT-2 + 可调电源（7.4 V 限 2 A）+ 摆杆 + 记录脚本。每个采样点记 `timestamp / goal_position / position / speed / load / input_volts / torque_enable / temperature` —— 寄存器 42 / 56 / 58 / 60 / 62 / 40 / 63，一次读 56–63 连读 8 字节。

### 2. 阶跃响应 · 3. 电压响应 · 4. 低速 · 5. 回差 · 6. 重复性

同一台架。**回差**要外部角度参考 —— 手机水平仪 app 贴摆杆上或量角器，编码器在齿轮输出侧，测不到自己的间隙。

**先做这两个，成本最低**：
- 阶跃 ±10° 重复 5 次 → 命令延迟、上升时间、超调
- 回差 ±1° / ±2° 重复 5 次 → 跟厂家 ≤0.5° 对一下

### 7. 控制与通信时序

要主控跑起来 —— 官方 `robotd` 每 5 分钟打一次汇总（达成频率、抖动、总线占用、错误计数），`bench_dynamixel_bus` 单独测总线。**不打 HAT 用第三方转接板时这是第一个要看的数**：错误率不为 0 就是转接板方向切换跟不上 1 Mbps。

### 8. 电源与压降

五工况表，需要分流器或钳形表在电池正极。**同时记电池端和舵机总线端**，差值就是走线 + 保险丝 + 连接器的压降。

### 9. IMU 数据

要 `imu_to_dxl` 板回来、固件写好。静止 60 s 读 ID 200 寄存器 124–136（gyro 3 × i16 + 四元数 3 × fp16）。方向检查按第 5 节那个 mount 四元数，前后左右各倾 10° 看投影重力的符号。

### 10. 足底摩擦

**现在就能做** —— 打印的脚已经在手：倾斜平面法，脚放地板上慢慢抬，滑动瞬间量角，μ ≈ tan θ。木地板 / 瓷砖 / 地毯各 5 次。

---

**改动记录**：2026-09-12 首版，从算法侧空表填起。装机实测后逐项覆盖，覆盖时把【MJCF】改成【实测】并记日期。
