FromAIToReality/OpenMicroDuck/docs/电控采购清单.md

> **上游技术参考，不是本项目实测结论。** 来源：[fanhao375/microduck-replica](https://github.com/fanhao375/microduck-replica/blob/a23f4c18a4741a3cde5257e639960ea37bbadd8d/docs/%E7%94%B5%E6%8E%A7%E9%87%87%E8%B4%AD%E6%B8%85%E5%8D%95.md)。保留原作者及贡献者署名；正文中的“本项目”、实物、照片和测试记录属于上游。与我们的硬件不一致时，以[本项目说明](hardware.md)为准。

# 电控采购清单（国内 / 淘宝）

> **仓库里有四份清单加一份打印说明，各管各的：**
>
> | 文档 | 管什么 | 不管什么 |
> |---|---|---|
> | [BOM](../BOM.md) | **总表**：全部物料、数量（从 MJCF 的 geom 引用数出来的）、成本量级、还没解决的空白 | 具体买哪家、怎么打印 |
> | **电控采购清单**（就是这份） | 电控件**买哪家**：主控 / 摄像头 / ToF / 电源 / 两块 PCB / 线材，淘宝实链 + 避坑 | 数量依据、机械件 |
> | [机械采购清单](机械采购清单.md) | 机械件**买哪家**：轴承 / 紧固件 / 耗材，淘宝实链 | 电控件 |
> | [硬件规格速查](硬件规格速查.md) | **参数**：接口、电压、协议、软件侧必须对齐的值 | 价格和店铺 |
> | [print/README](https://github.com/fanhao375/microduck-replica/blob/a23f4c18a4741a3cde5257e639960ea37bbadd8d/print/README.md) | **打印件**：哪个零件打几份、文件名规则、打印参数 | 采购 |
>
> 装配用的件号与螺丝对应在 [CAD 仓库](https://github.com/fanhao375/microduck-replica-cad#装配-bom)。

> **快照时间：2026-09-04。** 价格与销量会变，链接可能失效，下单前自己核价。
> 机械件（轴承 / 紧固件 / 耗材）见 [机械采购清单](机械采购清单.md)。
>
> 本清单不含推荐背书，只是搜索结果记录。店铺信息（销量、年限）为抓取时的显示值。

---

## 先搞清楚：板子都装在哪

这一条直接影响你买什么规格的线，**很容易搞错**：

```
头（MJCF 里的 jaw_soft 刚体）
 ├── Raspberry Pi 形态主控板     ← 主控在头里，不在躯干
 ├── RPI Robot HAT               ← 叠在主控上方 7.3 mm
 ├── IMX219 摄像头 + M12 镜头     ← 距主控板中心约 13 mm，同一刚体，中间没有关节
 └── 喇叭

躯干（trunk_base）
 ├── 两颗 hip_yaw XL330          ← 内腔基本被这两颗占满
 ├── trunk_base 底板
 └── NP-F 电池 —— 外挂在机身后下方，71 mm 长有约 40 mm 悬在壳体外，
      由两片 power_support 从外面夹住

穿过三自由度脖子的是：舵机总线 + 从电池上来的 +BATT 供电线
```

**证据**：`robot_walk.xml:235` `mesh="elec_rpi_robot_hat_pcb"`、`:247` `mesh="pcb__raspberry_pi_zero_2_w"`
两个 geom 都在 `jaw_soft` body 内；两块 65×30 板 X/Y 完全对齐、Z 间距 7.3 mm，是标准的 Pi + HAT 叠层。

> ⚠️ **所以 MIPI 排线不过脖子，买最短的就够。** 真正的线束疲劳风险在**舵机总线和电源线过颈**上
> —— 那是承流线，风险比信号排线更值得重视。而官方**没有公开任何走线资料**。

---

## 一、主控 · Radxa Zero 3W

### 该买哪个配置

**结论：2G / 16G eMMC。** 推算依据：

**存储侧**

| 项 | 体积 | 依据 |
|---|---|---|
| Armbian headless rootfs | ~2 GB | `deploy/README.md:144` 确认是 headless 镜像；**2 GB 是外部经验值，仓库无依据** |
| **ONNX Runtime** | **~20 MB** | `docs/design/robotd-design.md:420` 原文：「ONNX Runtime is a board prerequisite … **~20 MB** in every artifact would enlarge every update for nothing」——**板级预装，不在 release 包里** |
| **GStreamer 栈**（`mediad` 用） | **~100 MB** | `docs/design/updater-design.md:901`「the GStreamer stack for `mediad`, which is **around 100 MB of apt**」 |
| RKNN 运行时 `.so` | 未知 | 仓库无依据，不编数字 |
| daemon 制品 + 保留的一份旧版本 | 量级 10¹ MB | `Cargo.toml:79`「**model artifacts will dwarf a few MB of binary**」；`keep_previous = 1` |
| **9 个运动策略 ONNX** —— 每个 **793,685 B ≈ 775 KiB** | **7 MB** | 实测。`alpha_stand` / `alpha_walking` / `alpha_sitstand` / `alpha_ground_pick` / `ball_kick_left` / `ball_kick_right` / `roller` / `roller_crouch` / `roulade` |
| `duck_detect.onnx` | 10.0 MB | 实测 10,477,940 B |
| `pet_detect.onnx` | 19 KB | 实测 20,201 B |
| journald 上限 `SystemMaxUse=200M` | **默认配置下不占盘** | `/var/log` 是 zram 设备（`deploy/README.md:14/402/437`）。但 README:454 给了退路：关掉 `armbian-zram-config` 后日志就落到 eMMC |
| **合计** | **≈ 3 – 4 GB** | |

→ **8 GB eMMC 够，16 GB 舒服，64 GB 毫无意义。**

> 💡 **升级机制不需要双份 rootfs。** 但**别叫它 A/B** —— 上游 `docs/design/updater-design.md:46`
> 专门澄清过：「Update granularity | **Application-level (not A/B image)** | Only daemon + model
> change; OS is static. A/B (RAUC/Mender) would be over-engineering.」
> 实际是**版本目录 + `current` 符号链接原子切换（`rename(2)`）+ 健康门禁 + 回滚**，
> `keep_previous = 1` 只多留一份旧 daemon。（`updater.toml` 的 `tag_prefix` 实际值是 `daemon-v`。）

**内存侧**

| 项 | 占用 |
|---|---|
| Armbian headless | ~250 MB（外部经验值） |
| robotd + ONNX Runtime + RKNN | 小 —— 策略模型只有 775 KiB/个 |
| 摄像头 / GStreamer 缓冲 + `duck_detect` | ⚠️ **`duck_detect.onnx` 跑 CPU 不跑 NPU**（`robotd.toml:324`「a `.rknn` runs on the NPU, an `.onnx` on the CPU」；NPU 版 `.rknn` 不在仓库里）。且 **RK3566 的 NPU 与 CPU 共用 DDR，没有独立显存** |
| ⚠️ `/var/log` 的 zram 设备 —— **吃 RAM 不是盘** | 需预留 |

→ **1 GB 能跑但紧，2 GB 舒服，8 GB 纯浪费。**

> ⚠️ **官方公布的是 1 GB / 32 GB，但那不等于复刻也该买这档。**
> 官方 2026-08-27 发布页列出 **1 GB / 32 GB eMMC**（正是 Radxa Zero 3W 的一个 SKU，
> 也反向佐证了主控判断）；但 `microduck/` 源码里查不到任何板卡 SKU —— 源码本来就不体现这个。
> **按上面的体量推算，复刻建议 2G/16G**：1 GB 要和 zram 日志设备分内存，跑起来偏紧。

### 渠道 —— 国内电商价格全线虚高

官方分销商 [ALLNET China](https://shop.allnetchina.cn/products/copy-of-radxa-zero-3w) 实价（USD，约 ¥7.2/$）：

| 配置 | 价格 | 约合 |
|---|---|---|
| 1G / 无 eMMC | $18 | ¥130 |
| 1G / 8G eMMC | $22 | ¥158 |
| **2G / 16G eMMC** | **$32.90** | **¥237** ⭐ |
| 4G / 32G eMMC | $50 | ¥360 |
| 8G / 32G eMMC | $70 | ¥504 |

（带排针 +$1。ALLNET 不供 8G/64G 规格。）

国内在售：

| 店铺 | 配置 | 价格 | 链接 |
|---|---|---|---|
| findboard旗舰店 | 8G+64G「套餐6」（含摄像头/电源/32G卡/HDMI线/散热） | **¥1469** | [tmall 752703346347](https://detail.tmall.com/item.htm?id=752703346347) |
| findboard旗舰店 | 8G+64G 裸板 | ¥1149 | 同上 |
| 鹭控自动化工控 | 未注明（议价） | ¥690 | [taobao 1044607515575](https://item.taobao.com/item.htm?id=1044607515575) |

**溢价 3–6 倍。** 建议走 ALLNET China、速卖通或瑞莎官方渠道；国内也可问
[mcuzone 杭州野芯科技店](https://item.taobao.com/item.htm?id=1055301489376)（做了整套 Zero 3W 扩展板，大概率有裸板货源）。

### 套餐别买

| 配件 | 值不值 |
|---|---|
| 摄像头（瑞莎自家 IMX219，单卖 ¥129.99） | ❌ 通用 IMX219 ¥32.8 就有 |
| 32G microSD | ❌ 有 eMMC 就用不上 |
| 电源适配器 | ❌ 机器是电池供电，只台面调试用 |
| microHDMI 线 | ❌ Microduck 跑 headless |
| 散热片 | ✅ 有用，但单买 [¥19.99](https://item.taobao.com/item.htm?id=788387010174) |

---

## 二、主控备选 · 立创·泰山派（评估过，**塞不进去**）

同为 **RK3566**，国内货源稳，常被问到。**但结论是不能用。**

**实价**（点开选中「2G+16G 单主板」SKU 后的真价；列表页 ¥22 / ¥45 / ¥195 全是最低 SKU 诱导）：

| 渠道 | 配置 | 实价 | 链接 |
|---|---|---|---|
| RK开发板（9年老店） | 2G+16G 单主板 | **¥428**（+¥10 运费） | [taobao 1017038620459](https://item.taobao.com/item.htm?id=1017038620459) |
| 电子元件shop（12年老店，46付款） | 2G+16G 单板 | **¥480.8**（免运费） | [taobao 800894187326](https://item.taobao.com/item.htm?id=800894187326) |
| 立创商城官方 | 2G+16G | **¥580**（原 ¥228，DDR 涨价上调） | [item.szlcsc.com/20558171](https://item.szlcsc.com/20558171.html) |
| **对比：Radxa Zero 3W** | 2G/16G | **≈¥237** | ALLNET China |

**四条都不利：**

| | 泰山派 | Radxa Zero 3W |
|---|---|---|
| **装得下吗** | ❌ **装不下** —— 主控装在**头里**，头壳整体只有 58.8 × 91.8 × 122.7 mm，<br>主控槽在 X 方向只有 30 mm，上面还压着一块 HAT。泰山派 **70 × 45** 没有位置 | ✅ 65 × 30，就是按这个槽设计的 |
| 2G+16G 实价 | ¥428–580 | **≈¥237** |
| **Armbian 镜像** | ❌ 官方部署脚本整套基于 Radxa 的 Armbian 镜像<br>（`overlay_prefix=rk35xx`、`armbian-zram-config`、netplan、升级器），要重写 | ✅ 直接用 |
| **设备树 overlay** | ❌ 全要重写 —— 40-pin 引脚复用是**板级映射**。<br>Microduck 依赖 `/dev/ttyS2`、`i2c3 @400kHz`、`i2s3_2ch`、MIPI CSI | ✅ 现成 |
| **HAT 机械兼容** | ❌ 70×45 vs Pi Zero 65×30，排针位置对不上，**HAT 得重画** | ✅ 同为 Pi Zero 形态 |
| SoC / NPU / rknn | ✅ 同为 RK3566，内核与 NPU 工作可复用 | ✅ |
| WiFi | AP6212（WiFi4 / BT4.x） | WiFi6 / BT5.4 |

**但它的开源资料值得收着**（不用买板也能下）：完整原理图 + PCB 是**嘉立创 EDA 格式**，
同一颗 RK3566 的电源树、DDR 布线、AP6212 接法都能直接打开看 —— 画 `imu_to_dxl`
或以后重画 HAT 时是现成的高质量参考。

- [立创开源硬件平台 · 泰山派工程](https://oshwhub.com/li-chuang-kai-fa-ban/li-chuang-tai-shan-pai-kai-fa-ban)
- [资料下载中心](https://openkits-wiki.easyeda.com/zh-hans/tspi-rk3566/download-center.html)

---

## 三、摄像头 · IMX219（MIPI CSI）

摄像头与主控**同在头部、同一刚体**，`setup-board.sh:748` 用的 overlay 是
`radxa-zero3-rpi-camera-v2`，`setup-rkaiq.sh:147` `SENSOR = imx219`。

> ⚠️ **是转 90° 不是倒装 180°。** `mediad/src/main.rs:82`：
> 「**90, because the head camera is mounted a quarter turn off**, and this is the one place
> that fact is written down.」`docs/project/media-bringup.md:472` 里的 180° 是 **alpha 机**的过时数据。

| 店铺 | 价格 | 销量 | 链接 |
|---|---|---|---|
| DECXIN旗舰店 | ¥32.8 | 100+ | [tmall 775872575316](https://detail.tmall.com/item.htm?id=775872575316) |
| 德创信摄像头 | ¥32.8 | 27 | [taobao 771618094322](https://item.taobao.com/item.htm?id=771618094322) |
| 盛成威科技（11年老店） | ¥38 | 84 | [taobao 596521821696](https://item.taobao.com/item.htm?id=596521821696) |
| 亚博智能（14年老店，有技术文档） | ¥44 | 15 | [taobao 709927597121](https://item.taobao.com/item.htm?id=709927597121) |
| 树莓派零售商（包邮，48h发） | ¥68 | 100+ | [taobao 760446989892](https://item.taobao.com/item.htm?id=760446989892) |
| findboard旗舰店（瑞莎官方版） | ¥129.99 | 9 | [tmall 874789708454](https://detail.tmall.com/item.htm?id=874789708454) |

### 排线：15 针 ⇄ 22 针转接（可能需要，**买最短的**）

⚠️ **官方手册没给接口规格。** `Radxa ZERO 3W Product Brief` Rev 1.10 §6.3 原文只有：

> "The Radxa ZERO 3W is equipped with a **1x4-lane MIPI CSI** connector for camera integration.
> This interface is designed to be backward-compatible with standard industrial camera peripherals."

没有引脚数、没有间距。但 Zero 3W 是树莓派 Zero 形态，CSI 座与 Micro HDMI 同边、布局与 Pi Zero
一致，**极可能是窄口 22 针 0.5 mm**，而通用 IMX219 模组随附的是**标准 15 针 1.0 mm**。

> 💡 **买 15 cm 甚至更短的就够** —— 摄像头和主控在同一个刚体里，相距约 13 mm，
> 排线**不穿过脖子**。别买 30 cm。

| 店铺 | 说明 | 长度 | 价格 | 链接 |
|---|---|---|---|---|
| **汇博视捷科技工厂店** | 15转22Pin 金手指 FPC，**4 cm 短版** | 4cm | **¥1.88** | [taobao 654755002992](https://item.taobao.com/item.htm?id=654755002992) |
| 摄像头生产厂家（11年老店） | Pi Zero Camera Cable | 16cm | ¥1.88 | [taobao 819560127110](https://item.taobao.com/item.htm?id=819560127110) |
| **Tytion（15年老店）** | 标题明确写 **15P 1.0 转 22P 0.5** | 15cm | ¥2.5 | [taobao 678057486394](https://item.taobao.com/item.htm?id=678057486394) |
| 树莓派精品销售商（13年老店，包邮） | 官方线，135/200/300/500 mm 可选 | 多档 | ¥5.8 | [taobao 784739658496](https://item.taobao.com/item.htm?id=784739658496) |

---

## 四、ToF 测距 · VL53L5CX 或 VL53L8CX（8×8 多区）

**固件只认这两颗，没有第三个。** `tof/src/sensor.rs` 里就一个 match，按 revision ID 分：

```rust
match revision_id {
    0x0C => L8cx,
    0x02 => L5cx,       // 官方注释：「大多数在用的鸭子装的就是这颗」
    _    => Unknown,    // 没有驱动，直接报错退出
}
```

认不出来时守护进程的原话是 `… which is neither a VL53L5CX nor a VL53L8CX`，然后退出。
固件里只编了两个 ULD 驱动 shim（`Driver::L5` / `Driver::L8`），别的芯片连驱动都没有，改 ID 也骗不过去。

I²C 地址候选 **`0x29` 或 `0x52`**（`tof/src/main.rs:107`，0x52 是官方原型机为了给 IMU 让地址挪过去的，
挪过的传感器掉电还在 0x52），挂在 i2c3 @ 400 kHz。HAT 上走 **JST SH 1.0 mm 4P**（Qwiic / Stemma QT）接口 J5–J8。

### 板子尺寸决定能不能塞进脸壳

同样是能用的芯片，模块板型差一倍多。脸壳（`face_part`）的 ToF 开孔是按特定板型做的，换板型就得改图：

| 模块 | 芯片 | 板子尺寸 | 重量 | 参考价 | 结论 |
|---|---|---|---|---|---|
| **VL53L5X V2 模块** | VL53L5CX | **15.8 × 10 mm** | 1.15 g | ¥44.5（带盖片 ¥49.5） | ✅ **首选**：固件认，板子最小，还最便宜 |
| VL53L8CX 模块（国内常见板型） | VL53L8CX | 33.4 × 10.2 mm | 1.7 g | ¥75 | ⚠️ **不推荐**：芯片没问题，但这块板 33.4 mm，脸壳装不下（2026-09-20 实测）。除非你找得到更短的 L8CX 板，或者愿意改外壳 |
| VL53L7CX 模块 | VL53L7CX | 26 × 11.5 mm | 1.3 g | ¥75 | ❌ **别买**：固件直接报错退出 |

**打印件的孔距是 20 mm，只有 L5CX 那块板对得上**（同事 2026-09-20 实测：打印件孔位 20 mm，
手上那块 L8CX 板是 28 mm，装不上）。孔在两端耳朵的圆心上，离端头约 2.3~2.4 mm，
所以 `24.7 − 2×2.35 ≈ 20`、`33.4 − 2×2.7 ≈ 28`。官方脸壳本来就是按 L5CX 设计的，
这也对得上固件源码里那句注释：「大多数在用的鸭子装的就是 L5CX 这颗」。

**选型顺序：先看芯片固件认不认（只有 L5CX / L8CX），再看孔距对不对得上（要 20 mm）。**
反过来先挑尺寸就会像我们一样，为了短买成 L7CX，退货重来。

「盖片」是装在传感器上方的黑色光罩（单卖 ¥5），防串扰用，装不装看外壳设计。

| 店铺 | 型号 | 价格 | 销量 | 链接 |
|---|---|---|---|---|
| 森科源电子 | VL53L8CX | ¥70 | 1 | [taobao 1025775539663](https://item.taobao.com/item.htm?id=1025775539663) |
| 深圳市渱雯电子 | VL53L8CX | ¥74.98 | 0 | [taobao 977907234039](https://item.taobao.com/item.htm?id=977907234039) |
| 都会明武电子（包邮，回头客2万） | VL53L7CX / **L8CX** | ¥75 | 100+ | [taobao 942554129061](https://item.taobao.com/item.htm?id=942554129061) |
| 深圳优信电子（技术文档，包邮，对公） | VL53L8CX | ¥78.5 | 31 | [taobao 967946231167](https://item.taobao.com/item.htm?id=967946231167) |
| 勇泰发电子（11年老店，包邮） | VL53L8CX | ¥84.8 | 14 | [taobao 939165242465](https://item.taobao.com/item.htm?id=939165242465) |
| 归吉星旗舰店 | ST 官方 P-NUCLEO-53L8A1 评估套件 | ¥98 | 1 | [tmall 725486284128](https://detail.tmall.com/item.htm?id=725486284128) |

> ⚠️ **别买成 VL53L0X。** 搜「VL53L5CX」出来的绝大多数是 **VL53L0X —— 单点测距**，固件不认。
> `TOF050C / 200C / 400C` 那一类（¥2.79 起）也是单点的 L0X / L1X，便宜、板子小，但固件一样不认。
>
> ⚠️ **VL53L7CX 不是 L8CX 的短版。** L7 是 90° 宽视场的另一颗芯片，revision ID 对不上，
> 固件直接报错退出。2026-09-20 就是为了避开 L8CX 那块 33.4 mm 的长板买成了 L7CX，只能退。
> 短又能用的是 **L5CX**（15.8 × 10 mm）。有些链接把 L5 / L7 / L8 混在一个宝贝里，**选 SKU 看清**。
>
> 见过一条 ¥8 的「VL53L5CX」标题里同时写着「79GHz 雷达传感器」—— 关键词堆砌的坑货；
> 还见过 ¥5 的「VL53L5X V2」，点进去是**盖片**，不是模块。
>
> 到货怎么验：接上板子看 `tof` 守护进程打印的型号，或者直接读 revision ID，**只有 `0x02`（L5CX）
> 和 `0x0C`（L8CX）是对的**。

---

## 五、电源

| 件 | 店铺 | 价格 | 销量 | 链接 |
|---|---|---|---|---|
| **NP-F 电池仓（取电用）** | 腾壶旗舰店 | ¥17.8 | 99 | [tmall 658975825526](https://detail.tmall.com/item.htm?id=658975825526) |
| **NP-F 供电扣板**（Type-C 快充） | 拓普赛旗舰店 | ¥19 | 58 | [tmall 926961598924](https://detail.tmall.com/item.htm?id=926961598924) |
| NP-F550 电池本体 | 唯卓仕（国标 3C，带电量显示） | ¥52.8 首单 | 900+ | 搜「唯卓仕 NP-F550」 |

> 💡 **这两条正好补上上游缺的一环。** 官方只给了打印件 `power_support`（×2），
> **没有触点模型**，取电方案原本要自己解决 —— 直接买现成扣板即可。
>
> ⚠️ **是 NP-F550 不是 F970。** 上游网格文件名叫 `np_f970` 是误导：实测包围盒
> **38.6 × 20.6 × 70.8 mm** 就是 F550 的尺寸（索尼官方规格：F550 = 38.4×20.6×70.8，
> F970 = 38.4×**60.0**×70.8）。源码全库 grep 只有 2 处命中、**都是 NP-F550**
> （`robotd-design.md:572`、`duck-control/src/model.rs:108`「NP-F550, 2S Li-ion」），F970 零命中。
>
> 电池**外挂在机身后下方**，71 mm 长有约 40 mm 悬在躯干壳体下沿之外，由两片
> 83.5 mm 长的 `power_support` 从外面夹住。

### 降压模块（不打 HAT 时给主控供 5 V）

HAT 上的 `U9 AP63205` 是给主控出 5 V 的，[不打 HAT](不打HAT.md) 就得买个现成模块顶上。

| 件 | 规格 | 价格 | 搜索词 | 链接 |
|---|---|---|---|---|
| **UBEC 5V/3A**（首选） | 输入 **≥ 覆盖 6–8.4 V**，输出 5 V 3 A，带屏蔽和磁环 | ¥10–15 | 「UBEC 5V 3A 2S」 | *待补* |
| MP1584EN 模块（备选） | 输入 4.5–28 V，输出 5 V 固定或可调，标 3 A（无散热实际 ~2 A） | ¥3–5 | 「MP1584EN 5V」 | *待补* |

**买之前看这三个数，不看牌子：**

1. **输入电压下限 ≤ 6 V** —— 2S 电池带载能跌到 6.6 V，舵机同时启动时更低。很多 UBEC 标「2–6S」，实际下限写的是 7 V，**2S 快没电时它先掉出稳压、主控重启**。商品页找「输入电压」那一行，下限必须 ≤ 6 V
2. **输出电流 ≥ 2 A 连续** —— Radxa Zero 3W 跑 NPU + 摄像头 + WiFi 峰值 1 A 出头，官方 HAT 用的就是 2 A 的 AP63205。标 3 A 的小模块无散热实际 1.5–2 A，所以 UBEC 优先
3. **同步降压** —— 效率 90%+。**别买 LM2596**：150 kHz 非同步、压差要 1.5 V 以上，6 V 进 5 V 出已经在边缘，还发热

输入端并一个 **470 µF / 16 V** 电解，缓冲 15 颗舵机同时启动时的压降 —— 见 [不打 HAT · 第 3 步](不打HAT.md#第-3-步--电源每接一段量一次)。

---

## 六、两块 PCB

### RPI Robot HAT —— 买不到，只能打样；但你不一定需要它

**官方不单卖。** Pollen 只卖整机 Microduck，HAT 没有零售页。oshwhub 上也没搜到有人复刻。

**① 忠实打样** —— 官方给了完整生产文件（Gerber + BOM + 贴片坐标，Apache-2.0）。
实测核对：**4 层板**（`F_Cu / In1_Cu / In2_Cu / B_Cu`）、板框 **65.0 × 30.9 mm**、圆角 **R3.5**、
BOM **47 行 / 123 颗**（其中 5 行 9 颗 DNP）、实际贴装 **113 个位置**。加 SMT 成本几百元起且有起订量。

**② 用现成模块顶掉 —— ¥50 以内**

HAT 实际功能（逐条对原理图核过）：

| 功能 | 还需要吗 | 现成替代 |
|---|---|---|
| **舵机总线半双工 TTL** —— U5 `74LVC1G08` + U6 `SN74LVC1G125` + U7 `SN74LVC1G126`，<br>由 `DynUART_Tx`/`DynUART_Rx`/`Dynamixel_dir` 控方向 | ✅ 必需 | 见下表 |
| **配电** —— `+BATT` 直供舵机；U9 `AP63205` + L4 6.8µH → `+5V` 上 40-pin 给主控；<br>U3 `XC6206P182` → `+1V8` 给 codec | ✅ 必需 | 现成 UBEC（5V/3A 以上） |
| **音频** —— U2 `TLV320AIC3104`（i2c3 0x18 + i2s3_2ch）、U1 `PAM8406D` 功放、<br>MK1 MEMS 麦克风、Wago 端子接 5W 喇叭与外接麦 | ❓ 看需求 | **不要录音喇叭就整块省掉** |
| **传感器扩展** —— J5–J8 JST SH 1mm 4P（Qwiic/Stemma）接 ToF | ✅ 需要 | 直接挂 i2c3，几根线 |
| 板载 U11 `BMI088` | ❌ **贴了但软件不用**（`i2c3-pihat.dts:11`「dormant」、`:31`「unused but still connected」） | — |
| U4 `CAT24C32` EEPROM | ❌ **DNP 不贴** —— 所以这块板**不是自识别 HAT** | — |

**舵机连接器**：J13 / J14 = **JST EH 3P**（TTL，经 TH1 100R 热敏到 `+BATT`）；
J3 / J11 = **JST EH 4P**（RS-485，由 U8 `SIT3088E` 驱动，直接 `+BATT`），原理图旁注 **「3A max」**。

**半双工总线转接板**（走飞特路线直接对口）：

| 店铺 | 说明 | 价格 | 链接 |
|---|---|---|---|
| Fashion脖子（13年老店，90付款） | 串口总线舵机驱动板，**适用 ST/SC 系列** | **¥22** | [taobao 1005305041207](https://item.taobao.com/item.htm?id=1005305041207) |
| 众灵科技企业店（200+付款） | ZLink USB/TTL 调试板 + 总线舵机转接 | ¥22.5 | [taobao 570100064201](https://item.taobao.com/item.htm?id=570100064201) |
| 芯板坊（7年老店） | 微雪 串口总线舵机驱动板，适用 ST/SC | ¥24 | [taobao 954634564409](https://item.taobao.com/item.htm?id=954634564409) |
| 灵影智能企业店（200+付款） | ST/SC 飞特总线舵机 TTL 驱动板 `TTL_Adapter_(A)` | ¥26 | [taobao 983866781632](https://item.taobao.com/item.htm?id=983866781632) |

> 💡 **走飞特路线的话这条特别值得考虑。** `imu_to_dxl` 要重画、策略要重训、设备树也要改 ——
> HAT 同样该重新评估。¥22 的转接板 + 一个 UBEC 就顶掉了「舵机总线」和「配电」两件必需功能。
> 代价是失去板载音频。

### imu_to_dxl —— 自绘

STM32G031F8P6 + LSM6DSV16X + 半双工缓冲，对外表现成总线从机（Dynamixel 侧 ID 200）。
协议与寄存器布局已完整还原，见 [硬件方案逆向](硬件方案逆向.md)。

- **打样成本**：2 层板，嘉立创约 ¥25–40（不含贴片）
- **双协议**：要同时支持飞特与 Dynamixel 的话，**硬件不变、固件分支** ——
  两者物理层完全相同（半双工单线 TTL / 1 Mbps / 3 线），差别只在包格式
  （V2 包头 `FF FF FD 00` + CRC-16；飞特 `FF FF` + `~sum`）
- ✅ **接口与脚序已由官方规格书确认** —— 飞特《HL-2915-C002 串型规格书》A/0（2026-02-27）
  第 4 页 6-7 项：连接器 **`AMP-3`**，**`1=GND / 2=Vcc / 3=Signal/TTL`**，与 Dynamixel 一致。
  `HD-1910-C001.stp` 里连接器零件名为 `AMP-3P`，且该装配体含 `HL-2915-C002_ASM`，两款共用平台。
  <br>同规格书还确认：半双工异步、8bit/1stop/无校验、**出厂默认 1 Mbps**、ID 0–253（默认 1）、
  信号高电平 **2–5 V**（本板 74LVC 输出 3.3 V 在窗口内；输入耐 5.5 V 也扛得住舵机的 5 V）
  <br>⚠️ 该规格书是 HL-2915-C002（**12 V**），电气参数不可套用到 HD-1910（5–8.4 V）
  <br>⚠️ 「飞特 = TTL 单线」只对 STS/SCS/HL 成立 —— 官方手册写明 **SMS 系列走 RS485、默认 115200**
- **连接器壳体仍要实物试插** —— 飞特线材标 **5264 端子**，官方 HAT 用 **JST EH**，
  两者**都是 2.5 mm 间距**但不同系列，卡扣和壳体外形不同。舵机和线到手后试插一次，
  插不上就把 J1/J2 从 `B3B-EH-A`（`C160259`）换成 5264-3P。
  PR #12 那版图上是 JST PH 2.0 mm，**间距就不对，要改**
- **C6（LDO 输入电容）耐压 10 V → 25 V** —— 总线满电 8.4 V，10 V 余量不够（MLCC 还有直流偏压衰减）
- **C5 用 4.7 µF 不是 100 nF** —— ST DS12992 Rev 3 Fig.13 对 `VDD/VDDA` 的要求是
  `1 × 100 nF + 1 × 4.7 µF`，两颗一样的 100 nF 并联不顶用。选立创基础库 `C19666`
- **U1 的 2、3 脚留有源晶振焊盘（不贴）** —— TSSOP20 没引出 `OSC_OUT`，无源晶振接不了；
  HSI16 精度最坏 −1.85%/+1.55%（Table 41），1 Mbps 够用但余量不多
- **DATA 线加 TVS** —— 带电插拔舵机是常态
- **协议靠软件自动识别，不加拨码开关/跳线** —— 两家包头都是 `FF FF`，Dynamixel V2 后面跟 `FD 00`，飞特跟的是 `ID`+`LENGTH`（LENGTH 恒 ≥ 2，所以 `FD 00` 无歧义）。收前 3 包投票锁定，之后按锁定协议收发。拨码开关在会走路的机器人里是振动失效点，而且这板一辈子只配一次
- **J3 用 6P 不用 4P** —— 多出的 4/5 脚是 `USART1_TX/RX`（U1 脚 16/17 重映射），插个 5 块钱 USB-TTL 就能看 printf。G031 没有 USB 外设，加 USB 口要多一颗桥接芯片，不值

---

## 七、线材与工具

| 件 | 店铺 | 说明 | 价格 | 链接 |
|---|---|---|---|---|
| **舵机总线连接线** | 深圳飞特舵机工厂店 | 三针四针 **5264 接口** | **¥1.8** | [taobao 616460581906](https://item.taobao.com/item.htm?id=616460581906) |
| 舵机线材 | 鸿翊电子舵机工厂店 | 飞特串口总线，3针/4针 5264 端子 | ¥2.5 | [taobao 769633088382](https://item.taobao.com/item.htm?id=769633088382) |
| 舵机连接线（多长度） | 松甲科技（300+付款） | 母对母 **5264-3P**，10/15/20/30/50/70 cm | ¥2 | [taobao 587191439333](https://item.taobao.com/item.htm?id=587191439333) |
| **FE-URT-1 调试板** | 深圳飞特舵机工厂店（官方店） | USB 转 485/TTL | **¥45** | [taobao 603181554943](https://item.taobao.com/item.htm?id=603181554943) |
| URT-2 调试板 | 深圳飞特舵机厂家 | 同类 | ¥45 | [taobao 575365901461](https://item.taobao.com/item.htm?id=575365901461) |
| URT 调试板（第三方） | 云驱者科技企业店 | 同类 | ¥40 | [taobao 712781832610](https://item.taobao.com/item.htm?id=712781832610) |

> **调试板是必需品** —— 舵机到货第一件事是实测总线时序。
>
> ⚠️ **这不是飞特独有的问题。** 官方 Dynamixel 路径同样是**每设备一次应答延迟** ——
> `duck-control/src/model.rs:84-86` 写着 XL330 出厂 `return_delay_time = 250`，
> 即 **500 µs/设备**，「Across **16 devices** that is **8 ms per tick — 40% of a 20 ms budget**」，
> 官方的解法是把这个寄存器写 0（在 `EXPECTED_REGISTERS` 里）。
> **飞特侧已查清**：STS/SCS 有 `SYNC READ`（`0x82`），且 Return Delay Time 出厂就是 0 ——
> 见 [硬件方案逆向 · 飞特 STS/SCS 协议对照](硬件方案逆向.md)。所以更要实测，不能假定它一定更慢。

---

## 八、避坑

1. **摄像头排线别买长的** —— 主控和摄像头同在头部、同一刚体，MIPI 线不过脖子。4–15 cm 足够。
2. **摄像头是转 90° 不是 180°** —— 见上文。
3. **VL53L0X 冒充 VL53L5CX** —— 搜出来大多是单点的 L0X，固件不认；L7CX 也不是 L8CX。
4. **Radxa 裸板溢价** —— 官方分销 $22–70（¥158–504），淘宝在售 ¥690–1469。换渠道。
5. **泰山派装不进去** —— 不只是贵，是头部根本没有 70×45 的位置。
6. **¥8 的飞特 STS3215 / ¥22 的泰山派** —— 都是 SKU 诱导，点进去最低档是配件。
7. **乐泰 243 低于 ¥15 的要当心假货**（见 [机械采购清单](机械采购清单.md)）。

---

## 未验证项

- 全部价格、销量、店铺信息与链接有效性（2026-09-04 快照）
- Pollen 是否单卖 HAT
- Zero 3W 的 CSI 座究竟是 15P 还是 22P（官方文档未给，本文标为「极可能 22P」）
- 泰山派的规格、价格、开源工程内容
