FromAIToReality/OpenMicroDuck/cad/BOM/装配BOM.xlsx

序号 | 类别 | 名称 | 原文件名 | 材料 |  | 数量 | 单价 | 总格 | 网址
一、3D打印件（需打印）
1 | 3D打印件 | 头部上壳 | top_head_shell_头部上壳.stp | PLA |  | 1 |  | 139
2 | 3D打印件 | 头部下壳 | bottom_head_shell_头部下壳.stp | PLA |  | 1
3 | 3D打印件 | 面部零件 | face_part_面部零件.stp | PLA |  | 1
4 | 3D打印件 | 下巴 | jaw_下巴.stp | PLA |  | 1
5 | 3D打印件 | 软下巴 | jaw_soft_软下巴.stp | PLA | 建议改用TPU软料 | 1
6 | 3D打印件 | 软嘴顶部 | soft_mouth_top_软嘴顶部.stp | PLA | 建议改用TPU软料 | 1
7 | 3D打印件 | 眼睛 | noenoeil_眼睛.stp | PLA |  | 1
8 | 3D打印件 | 颈部 | neck_颈部.stp | PLA | 建议铝合金 | 2
9 | 3D打印件 | 颈部俯仰 | neck_pitch_颈部俯仰.stp | PLA |  | 1
10 | 3D打印件 | 躯干底座 | trunk_base_躯干底座.stp | PLA | 建议铝合金 | 1
11 | 3D打印件 | 左壳 | left_shell_左壳.stp | PLA |  | 1
12 | 3D打印件 | 右壳 | right_shell_右壳.stp | PLA |  | 1
13 | 3D打印件 | 髋部左 | hip_l_髋部左.stp | PLA |  | 2
14 | 3D打印件 | 偏航转横滚 | yaw2roll_偏航转横滚.stp | PLA |  | 1
15 | 3D打印件 | 偏航横滚运动 | yaw_roll_motion_偏航横滚运动.stp | PLA |  | 1
16 | 3D打印件 | 腿部 | leg_腿部.stp | PLA |  | 2
17 | 3D打印件 | 左上腿 | left_upper_leg_左上腿.stp | PLA |  | 1
18 | 3D打印件 | 右上腿 | right_upper_leg_右上腿.stp | PLA |  | 1
19 | 3D打印件 | 上腿加固板 | upper_leg_rigidity_plate_上腿加固板.stp | PLA | 建议铝合金 | 2
20 | 3D打印件 | 左脚 | foot_left_左脚.stp | PLA |  | 1
21 | 3D打印件 | 右脚 | foot_right_右脚.stp | PLA |  | 1
22 | 3D打印件 | 左脚底 | sole_left_左脚底.stp | PLA |  | 1
23 | 3D打印件 | 右脚底 | sole_right_右脚底.stp | PLA |  | 1
24 | 3D打印件 | 脚踝左 | ankle_left_脚踝左.stp | PLA |  | 1
25 | 3D打印件 | 脚踝右 | ankle_right_脚踝右.stp | PLA |  | 1
26 | 3D打印件 | 脚踝左(V1备选) | ankle_l_v1_脚踝左V1.stp | PLA |  | 1
27 | 3D打印件 | 脚踝右(V1备选) | ankle_r_v1_脚踝右V1.stp | PLA |  | 1
28 | 3D打印件 | 合体轮胎 | 合体轮胎.stp | PLA |  | 4
29 | 3D打印件 | 滚轮叶片 | roller_blade_滚轮叶片.stp | PLA |  | 2
30 | 3D打印件 | 电机支架 | motor_support_电机支架.stp | PLA |  | 1
31 | 3D打印件 | 电源支架 | power_support_电源支架.stp | PLA |  | 1
32 | 3D打印件 | 香蕉形PCB锁扣 | banana_pcb_locker_香蕉形PCB锁扣.stp | PLA |  | 1
33 | 3D打印件 | 轴承滚轮 | bearing_roll_轴承滚轮.stp | PLA | 建议铝合金 | 2
二、外购标准件（无需打印） |  |  |  |  |  |  |  | 0 | 网址
1 | 外购件 | Radxa Zero 3W 主控板 |  | 电子件 |  | 1 | 309 | 309
2 | 外购件 | 64GB TF 卡 |  | 电子件 |  | 1 | 60 | 60
3 | 外购件 | 树莓派机器人HAT电路板 |  | 电子件 |  | 1 | / | 0
4 | 外购件 | imu_to_dxl电路板 |  | 电子件 |  | 1 | / | 0
5 | 外购件 | 飞特HD1901M舵机 |  | 电子件 |  | 15 | / | 0
6 | 外购件 | 飞特舵机URT2调试板 |  | 电子件 |  | 1 | 45 | 45
7 | 外购件 | NP-F550电池 |  | 电子件 |  | 1 | 17 | 17
8 | 外购件 | 电池座 |  | 电子件 |  | 1 | 83 | 83
9 | 外购件 | 2.5mm香蕉插头PCB铜镀金 |  | 电子件 |  | 2 | 1.6 | 3.2
10 | 外购件 | banana PCB |  | 电子件 |  | 1 | / | 0 | 嘉立创
11 | 外购件 | IMX219摄像头模块 |  | 光学件 |  | 1 | 46.8 | 46.8
12 | 外购件 | VL53L8CX ToF 模块 |  | 电子件 |  | 1 | 49.5 | 49.5
13 | 外购件 | 扬声器 |  | 电子件 |  | 1 | 3.8 | 3.8
14 | 外购件 | 轴承 10×15×3 |  | 标准件 |  | 3 | 2.8 | 8.4
15 | 外购件 | 轴承 16×22×4 |  | 标准件 |  | 11 | 3.5 | 38.5
16 | 外购件 | 轴承 6×12×3 | 轮滑鞋用轴承 | 标准件 |  | 4 | 0.88 | 3.52
17 | 外购件 | 螺丝M2×5 |  | 标准件 |  | 1包 | 3.05 | 3.05
18 | 外购件 | 螺丝M2×6 |  | 标准件 |  | 1包 | 4.05 | 4.05
19 | 外购件 | 螺丝M2.5×6 |  | 标准件 |  | 1包 | 3.93 | 3.93
20 | 外购件 | 螺丝M2.5×8 |  | 标准件 |  | 1包 | 2.08 | 2.08
21 | 外购件 | 乐泰螺纹胶243 |  | 标准件 |  | 1 | 9 | 9
合计：3D打印件 33 项 / 外购件 21项 |  |  |  |  |  |  |  | 828.83
