FromAIToReality/OpenMicroDuck/cad/step/leg_腿部-FT.STEP

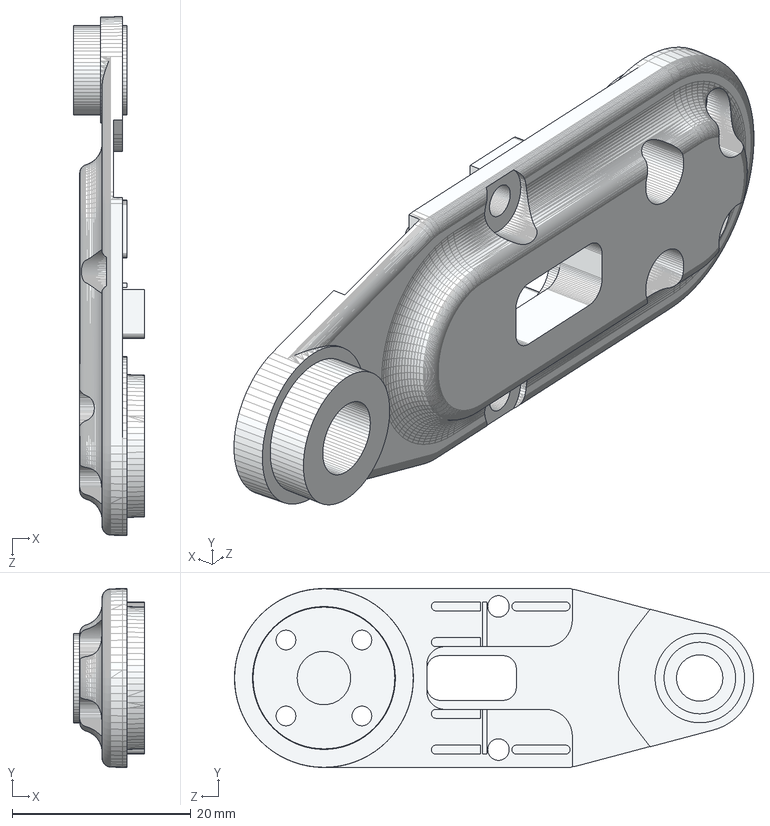
[picture p34: CAD file, 2026-10-11]
cad/step/leg_腿部-FT.STEP
7.95 x 20.0 x 58.0 mm
