FromAIToReality/OpenMicroDuck/software/training/src/mjlab_microduck/robot/xl330_test_bench/assets/arm.stl

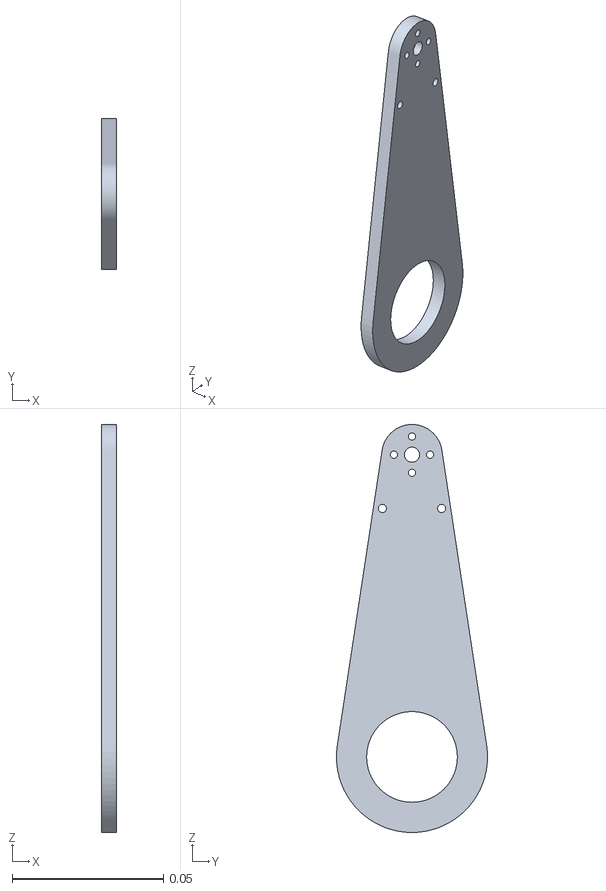
[picture p36: CAD file, 2026-09-28]
software/training/src/mjlab_microduck/robot/xl330_test_bench/assets/arm.stl
0.005 x 0.05 x 0.135
