FromAIToReality/OpenMicroDuck/cad/print/upstream-FT-P2S-PLA-20260915.3mf

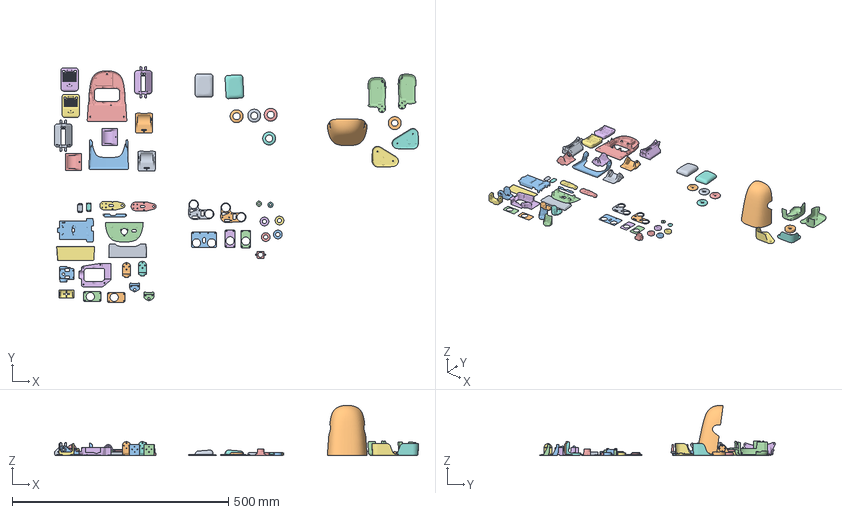
[picture p37: CAD file, 2026-09-28]
cad/print/upstream-FT-P2S-PLA-20260915.3mf
840.8 x 544.5 x 116.0 mm
ankle_l_v1_脚踝左V1.stl
ankle_r_v1_脚踝右V1.stl
banana_pcb_locker_香蕉形PCB锁扣.stl
bearing_roll_轴承滚轮.stl x 2
bottom_head_shell_头部下壳.stl
foot_left_左脚.stl
foot_right_右脚.stl
hip_l_髋部左.stl x 2
jaw_soft_软下巴.stl
jaw_下巴.stl
left_shell_左壳.stl
m12_lens_holder_M12镜头座.stl
motor_support_电机支架.stl
neck_pitch_颈部俯仰.stl
neck_颈部.stl x 2
noenoeil_眼睛.stl
power_support_电源支架.stl
right_shell_右壳.stl
rim_轮辋.stl x 4
roller_blade_滚轮叶片.stl x 2
soft_mouth_top_软嘴顶部.stl
sole_left_左脚底.stl
sole_right_右脚底.stl
top_head_shell_头部上壳.stl
trunk_base_躯干底座.stl
face_part_面部零件.stp
tire_轮胎.stl x 4
轴承12×6×3.STEP x 2
ankle_right脚踝右.STEP
ankle_left_脚踝左.STEP
right_upper_leg_右上腿-FT.STEP
left_upper_leg_左上腿-FT.STEP
01-upper_leg_rigidity_plate_上腿加固板-FT.STEP x 2
99-yaw_roll_motion_偏航横滚运动-F.STEP
bearing_roll_轴承滚轮-FT.STEP x 2
leg_腿部-FT.STEP x 2
