FromAIToReality/OpenMicroDuck/cad/step/face_part_面部零件-FT1适配瑞莎原版摄像头 改了孔距.STEP

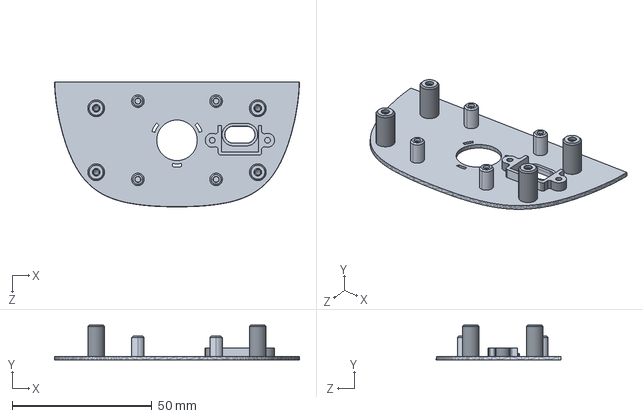
[picture p38: CAD file, 2026-10-11]
cad/step/face_part_面部零件-FT1适配瑞莎原版摄像头 改了孔距.STEP
87.7 x 12.5 x 44.6 mm
