FromAIToReality/OpenMicroDuck/software/training/src/mjlab_microduck/robot/microduck/assets/rim.stl

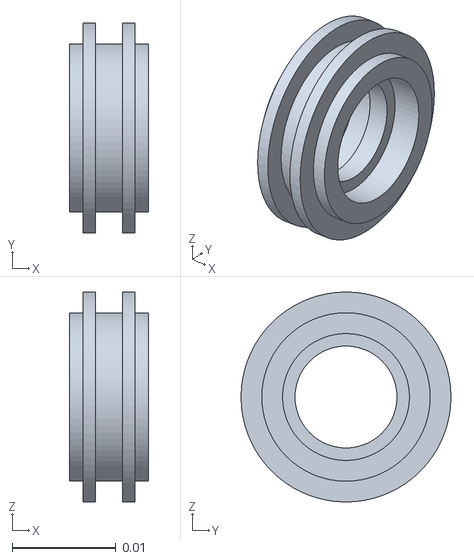
[picture p39: CAD file, 2026-09-28]
software/training/src/mjlab_microduck/robot/microduck/assets/rim.stl
0.0076 x 0.0202 x 0.0202
