FromAIToReality/OpenMicroDuck/cad/step/合体轮胎.STEP

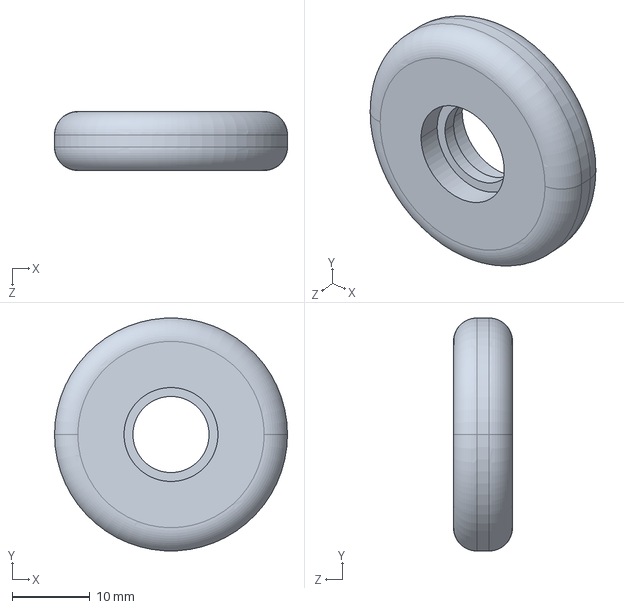
[picture p40: CAD file, 2026-10-11]
cad/step/合体轮胎.STEP
30.0 x 30.0 x 7.60 mm
