FromAIToReality/OpenMicroDuck/software/training/src/mjlab_microduck/robot/microduck/assets/top_head_shell.stl

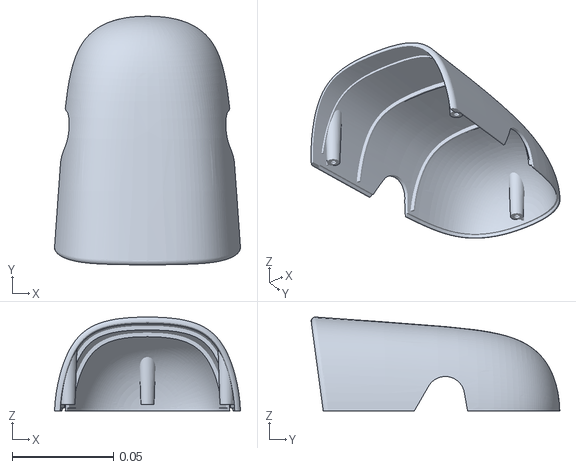
[picture p41: CAD file, 2026-09-28]
software/training/src/mjlab_microduck/robot/microduck/assets/top_head_shell.stl
0.0918 x 0.123 x 0.0463
