FromAIToReality/OpenMicroDuck/software/training/src/mjlab_microduck/robot/xl330_test_bench/assets/spacer.stl

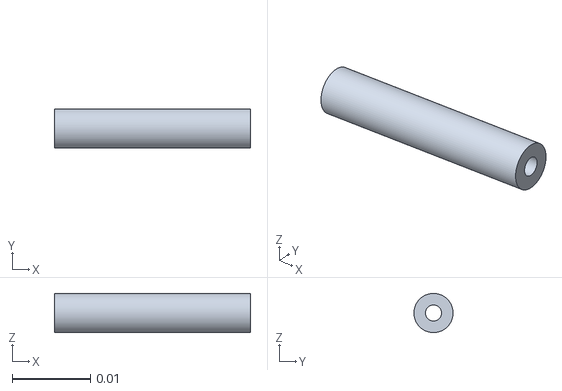
[picture p42: CAD file, 2026-09-28]
software/training/src/mjlab_microduck/robot/xl330_test_bench/assets/spacer.stl
0.025 x 0.005 x 0.005
