FromAIToReality/OpenMicroDuck/cad/step/bearing_roll_轴承滚轮-FT.STEP

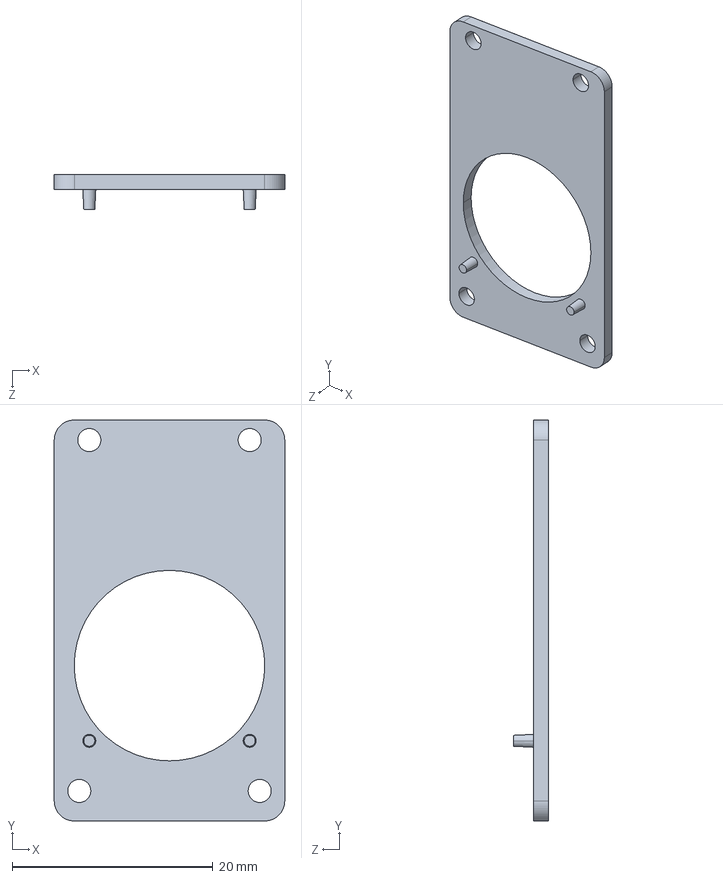
[picture p43: CAD file, 2026-10-11]
cad/step/bearing_roll_轴承滚轮-FT.STEP
23.0 x 40.0 x 3.50 mm
