FromAIToReality/OpenMicroDuck/cad/step/99-yaw_roll_motion_偏航横滚运动-F.STEP

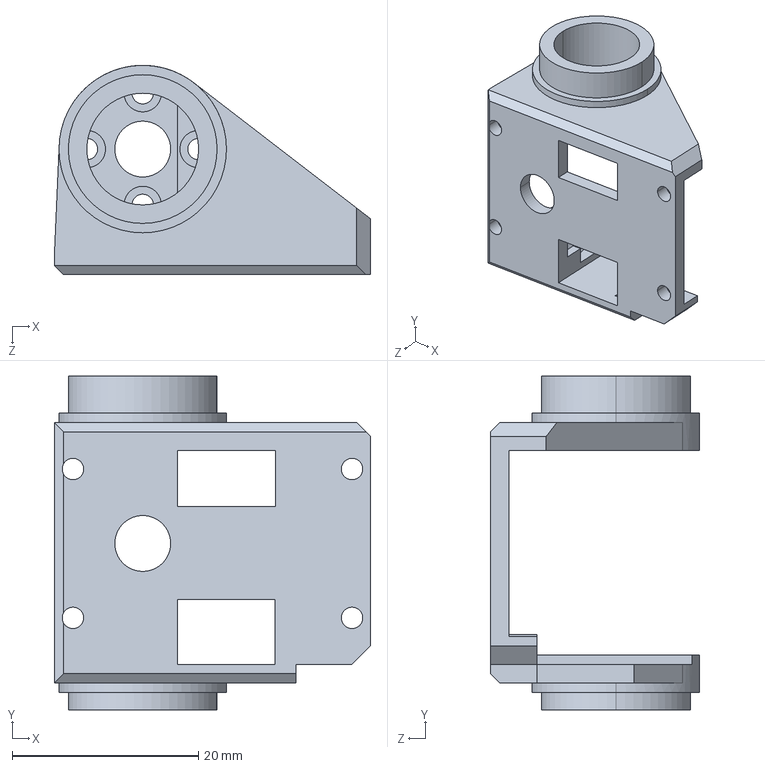
[picture p46: CAD file, 2026-10-11]
cad/step/99-yaw_roll_motion_偏航横滚运动-F.STEP
34.0 x 35.9 x 22.5 mm
