FromAIToReality/OpenMicroDuck/software/training/src/mjlab_microduck/robot/xl330_test_bench/assets/weight.stl

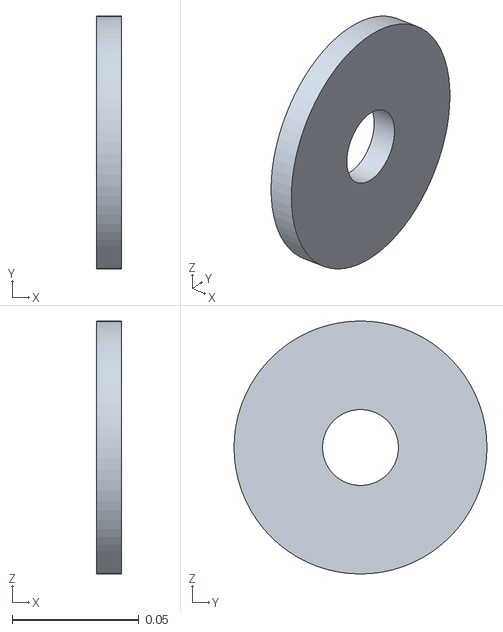
[picture p48: CAD file, 2026-09-28]
software/training/src/mjlab_microduck/robot/xl330_test_bench/assets/weight.stl
0.01 x 0.1 x 0.1
