FromAIToReality/OpenMicroDuck/cad/step/ankle_left_脚踝左-FT.STEP

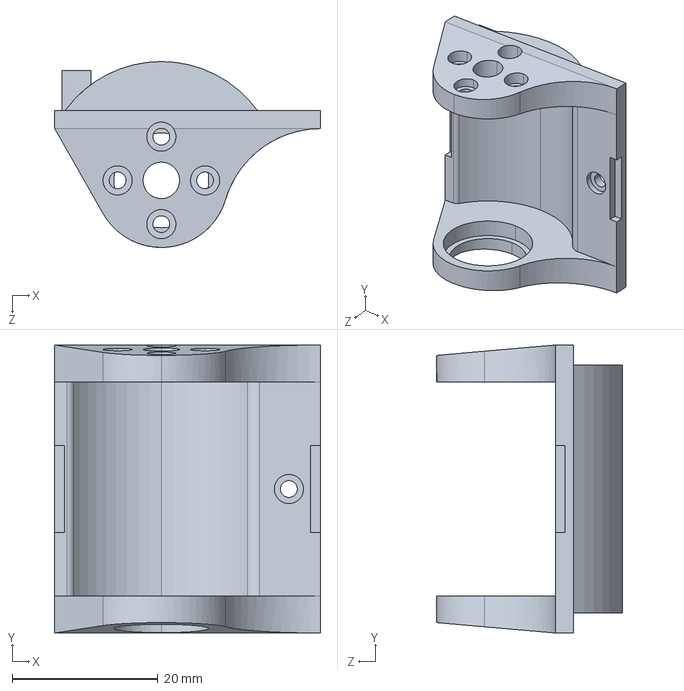
[picture p49: CAD file, 2026-10-11]
cad/step/ankle_left_脚踝左-FT.STEP
36.5 x 39.5 x 25.5 mm
