FromAIToReality/OpenMicroDuck/software/training/src/mjlab_microduck/robot/microduck/assets/left_shell.stl

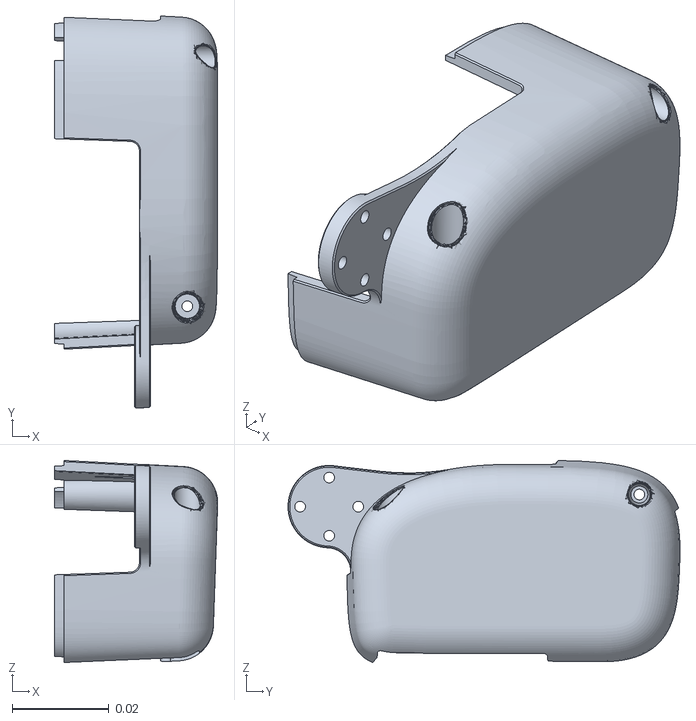
[picture p50: CAD file, 2026-09-28]
software/training/src/mjlab_microduck/robot/microduck/assets/left_shell.stl
0.0337 x 0.0809 x 0.0417
