FromAIToReality/OpenMicroDuck/cad/step/ankle_right脚踝右1-FT.STEP

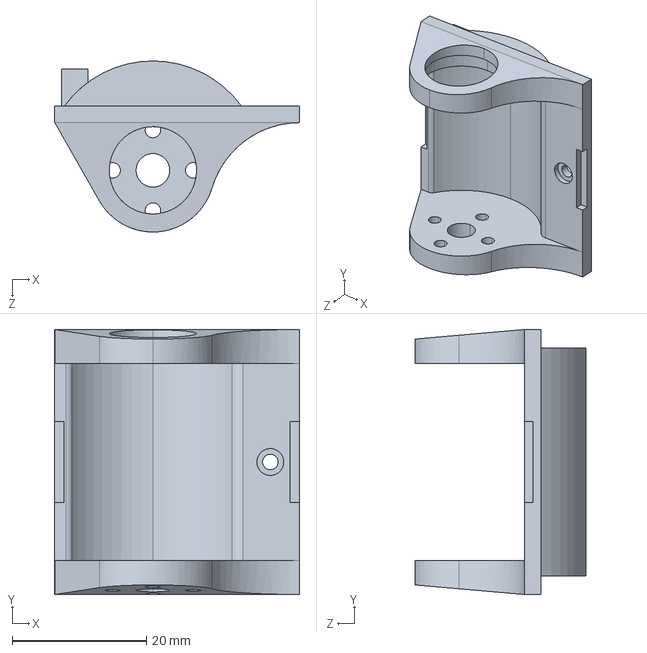
[picture p52: CAD file, 2026-10-11]
cad/step/ankle_right脚踝右1-FT.STEP
36.5 x 39.5 x 25.5 mm
