FromAIToReality/OpenMicroDuck/software/training/src/mjlab_microduck/robot/microduck/assets/bottom_head_shell.stl

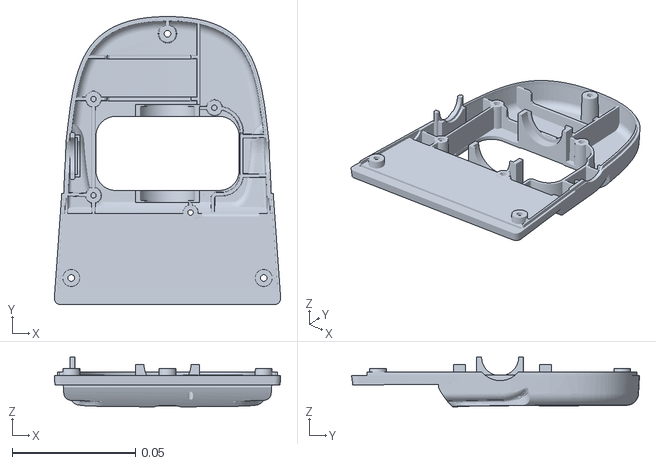
[picture p53: CAD file, 2026-09-28]
software/training/src/mjlab_microduck/robot/microduck/assets/bottom_head_shell.stl
0.0918 x 0.117 x 0.0201
