FromAIToReality/OpenMicroDuck/software/training/src/mjlab_microduck/robot/microduck/assets/right_upper_leg.stl

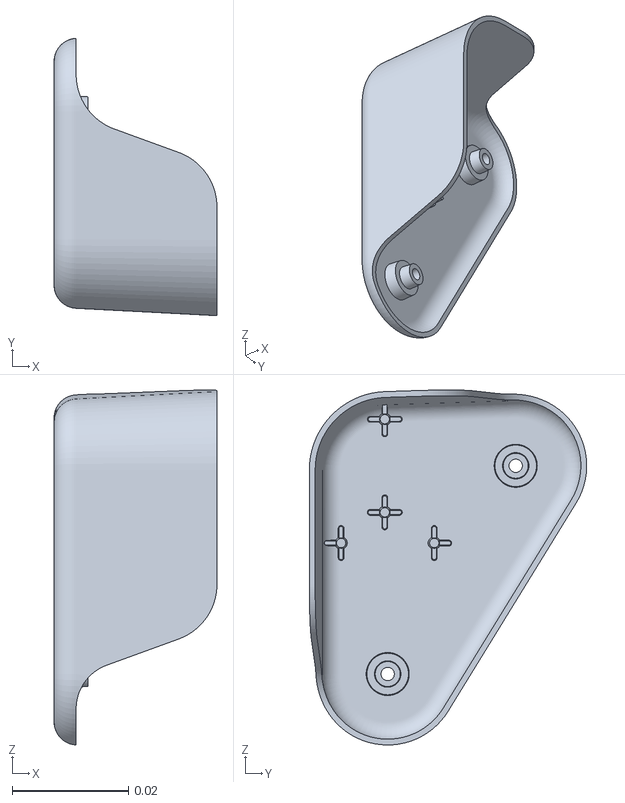
[picture p55: CAD file, 2026-09-28]
software/training/src/mjlab_microduck/robot/microduck/assets/right_upper_leg.stl
0.028 x 0.0477 x 0.061
