FromAIToReality/OpenMicroDuck/cad/step/left_upper_leg_左上腿-FT.STEP

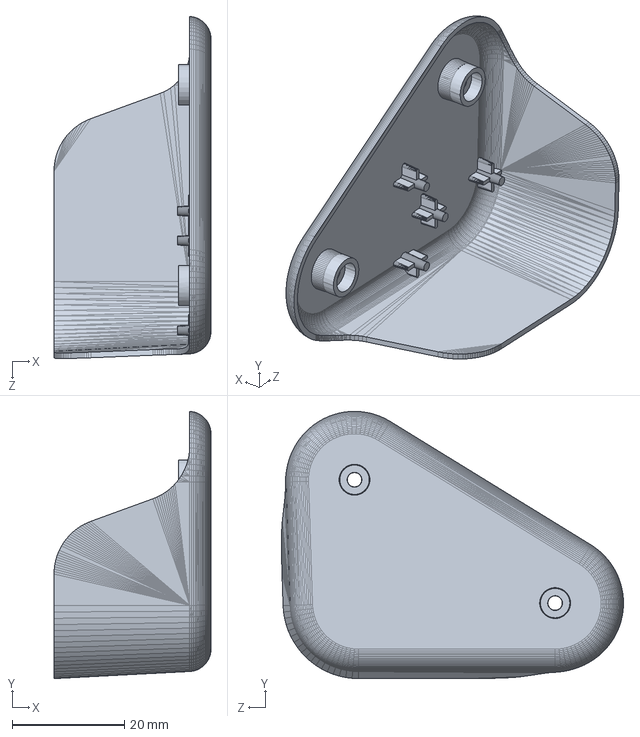
[picture p56: CAD file, 2026-10-11]
cad/step/left_upper_leg_左上腿-FT.STEP
28.0 x 47.7 x 61.0 mm
