FromAIToReality/OpenMicroDuck/software/training/src/mjlab_microduck/robot/microduck/assets/speaker.stl

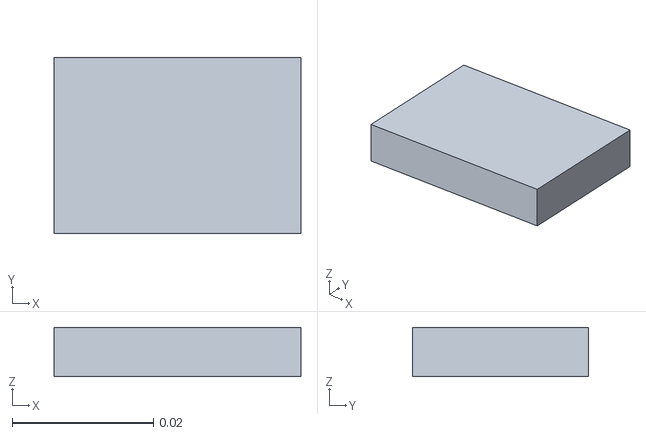
[picture p57: CAD file, 2026-09-28]
software/training/src/mjlab_microduck/robot/microduck/assets/speaker.stl
0.035 x 0.025 x 0.007
