FromAIToReality/OpenMicroDuck/software/training/src/mjlab_microduck/robot/xl330_test_bench/assets/bench_holder.stl

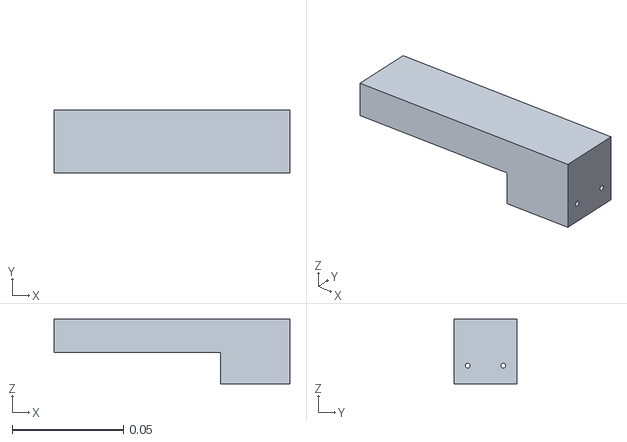
[picture p58: CAD file, 2026-09-28]
software/training/src/mjlab_microduck/robot/xl330_test_bench/assets/bench_holder.stl
0.106 x 0.0282 x 0.0292
