FromAIToReality/OpenMicroDuck/cad/step/yaw2roll_偏航转横滚-FT.STEP

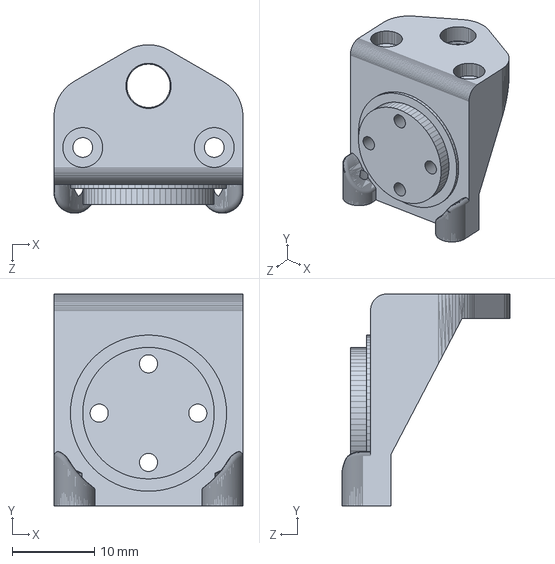
[picture p59: CAD file, 2026-10-11]
cad/step/yaw2roll_偏航转横滚-FT.STEP
23.0 x 25.8 x 20.5 mm
