FromAIToReality/OpenMicroDuck/software/training/src/mjlab_microduck/robot/microduck/assets/jaw.stl

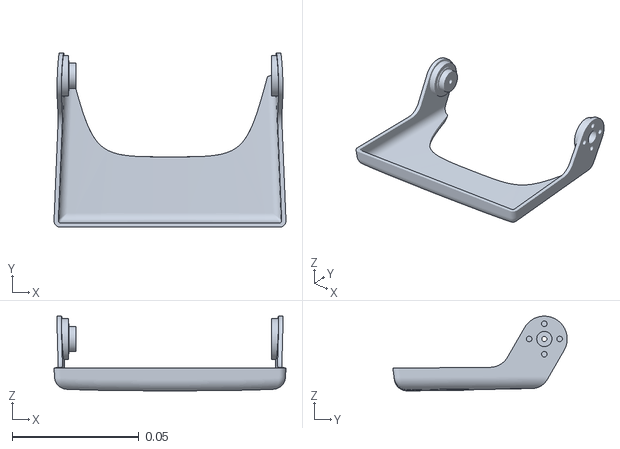
[picture p61: CAD file, 2026-09-28]
software/training/src/mjlab_microduck/robot/microduck/assets/jaw.stl
0.0914 x 0.0687 x 0.0294
