FromAIToReality/OpenMicroDuck/software/training/src/mjlab_microduck/robot/microduck/assets/ankle_right.stl

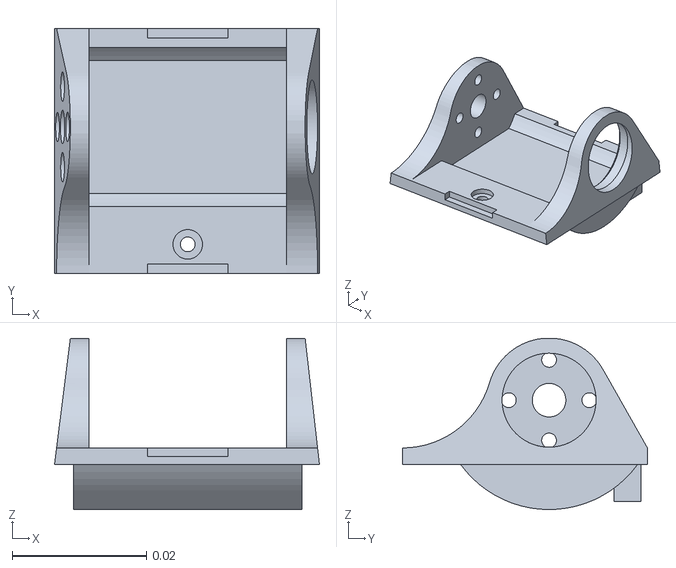
[picture p62: CAD file, 2026-09-28]
software/training/src/mjlab_microduck/robot/microduck/assets/ankle_right.stl
0.0395 x 0.0365 x 0.0255
