FromAIToReality/OpenMicroDuck/software/training/src/mjlab_microduck/robot/microduck/assets/right_shell.stl

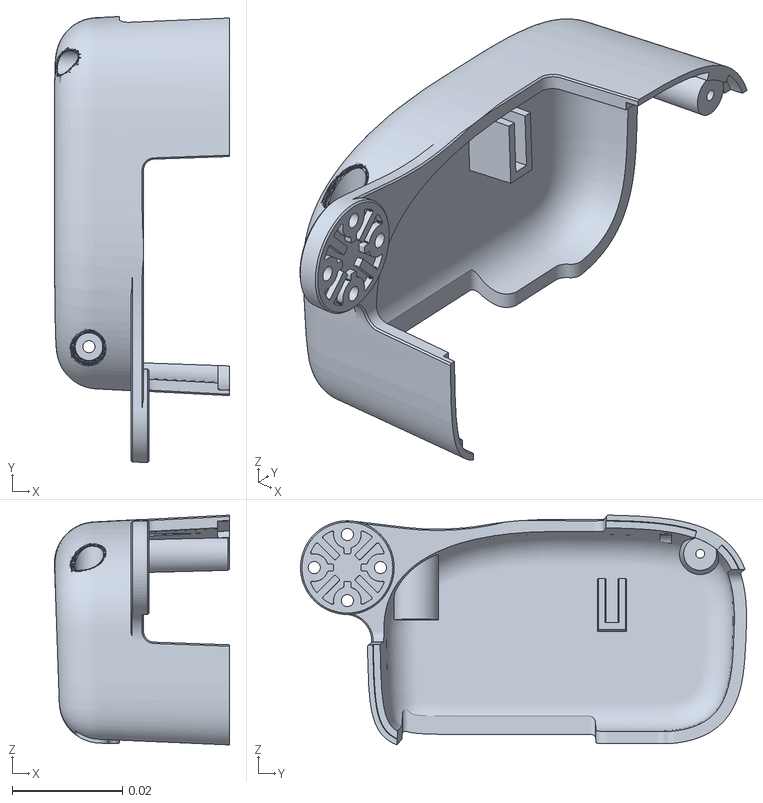
[picture p63: CAD file, 2026-09-28]
software/training/src/mjlab_microduck/robot/microduck/assets/right_shell.stl
0.0318 x 0.0809 x 0.0417
