FromAIToReality/OpenMicroDuck/software/training/src/mjlab_microduck/robot/microduck/assets/seeed_bearing__configuration_default.stl

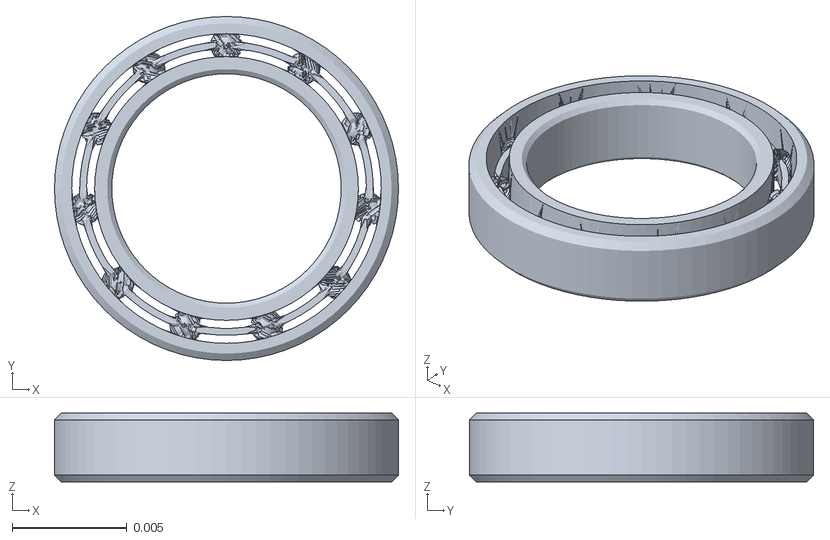
[picture p64: CAD file, 2026-09-28]
software/training/src/mjlab_microduck/robot/microduck/assets/seeed_bearing__configuration_default.stl
0.015 x 0.015 x 0.003
