FromAIToReality/OpenMicroDuck/software/training/src/mjlab_microduck/robot/microduck/assets/leg.stl

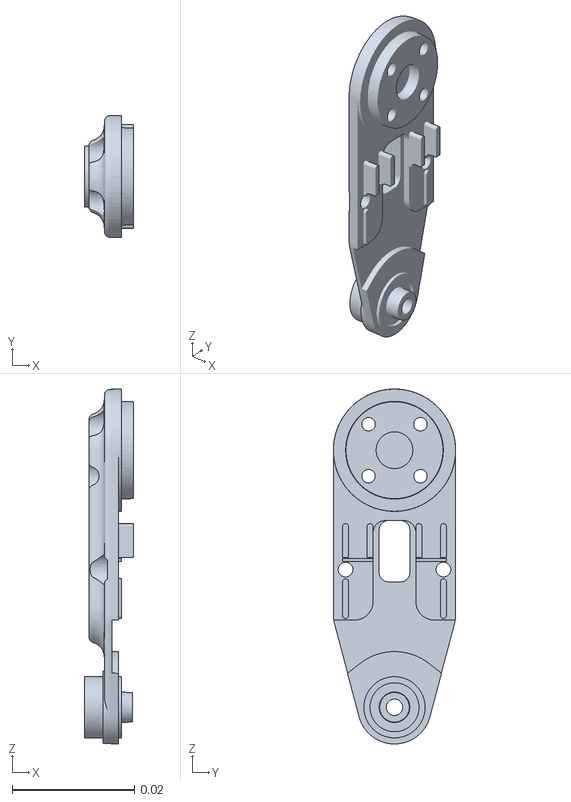
[picture p65: CAD file, 2026-09-28]
software/training/src/mjlab_microduck/robot/microduck/assets/leg.stl
0.00795 x 0.02 x 0.058
