FromAIToReality/OpenMicroDuck/software/training/src/mjlab_microduck/robot/microduck/assets/neck_pitch.stl

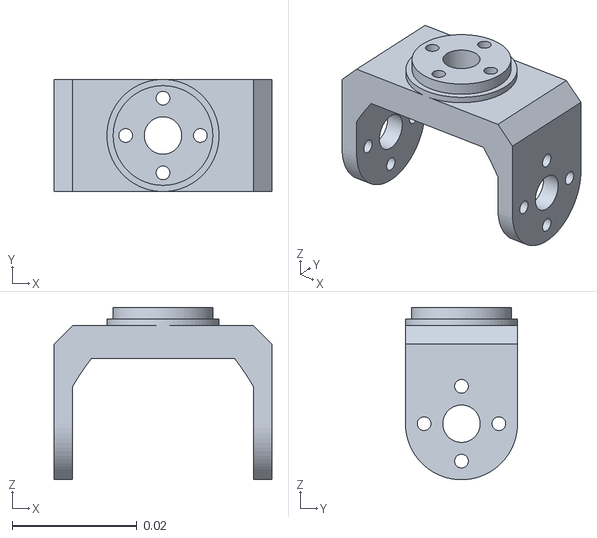
[picture p66: CAD file, 2026-09-28]
software/training/src/mjlab_microduck/robot/microduck/assets/neck_pitch.stl
0.035 x 0.018 x 0.0277
