FromAIToReality/OpenMicroDuck/software/training/src/mjlab_microduck/robot/microduck/assets/hip_l.stl

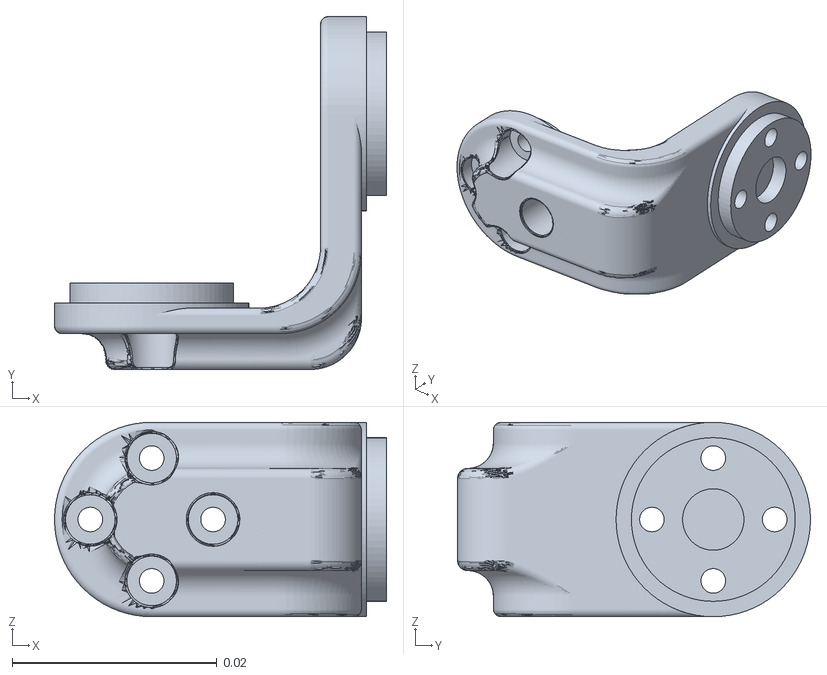
[picture p67: CAD file, 2026-09-28]
software/training/src/mjlab_microduck/robot/microduck/assets/hip_l.stl
0.0325 x 0.0345 x 0.019
