FromAIToReality/OpenMicroDuck/software/training/src/mjlab_microduck/robot/microduck/assets/power_support.stl

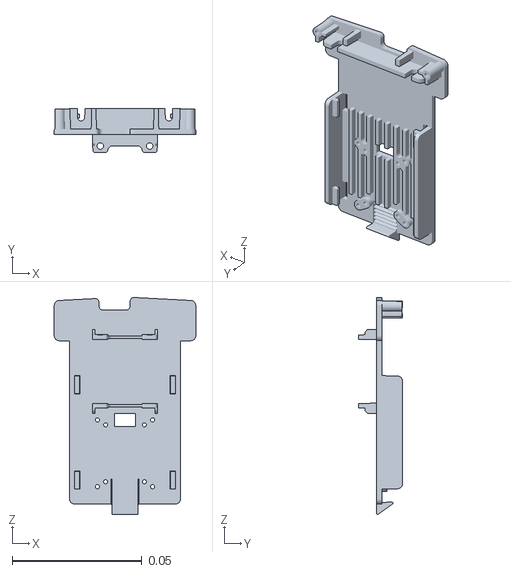
[picture p68: CAD file, 2026-09-28]
software/training/src/mjlab_microduck/robot/microduck/assets/power_support.stl
0.0545 x 0.017 x 0.0835
