FromAIToReality/OpenMicroDuck/software/training/src/mjlab_microduck/robot/microduck/assets/trunk_base.stl

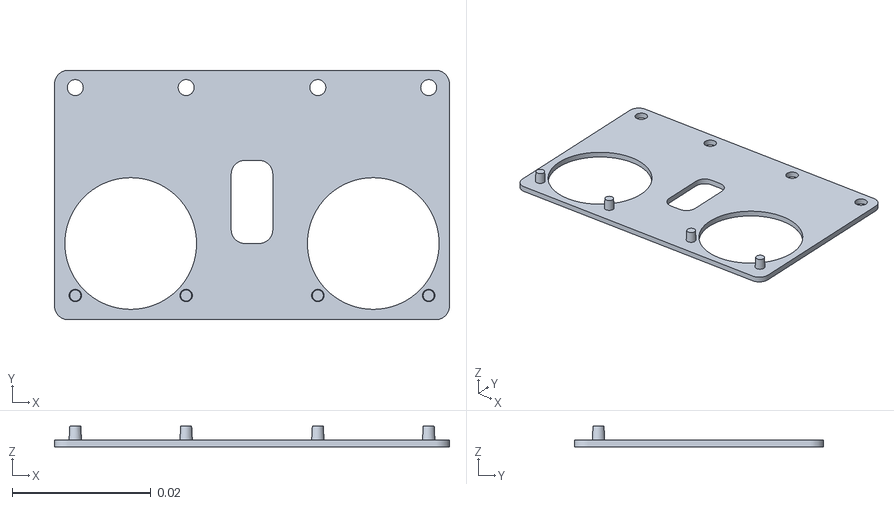
[picture p69: CAD file, 2026-09-28]
software/training/src/mjlab_microduck/robot/microduck/assets/trunk_base.stl
0.057 x 0.036 x 0.003
