FromAIToReality/OpenMicroDuck/software/training/src/mjlab_microduck/robot/microduck/assets/noenoeil.stl

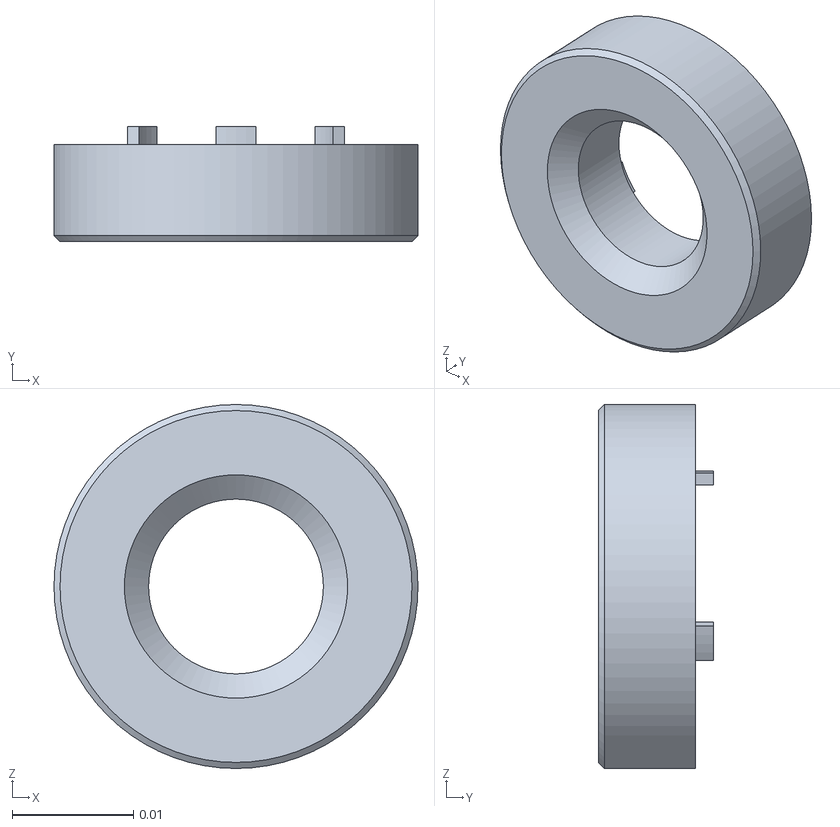
[picture p71: CAD file, 2026-09-28]
software/training/src/mjlab_microduck/robot/microduck/assets/noenoeil.stl
0.03 x 0.0095 x 0.03
