FromAIToReality/OpenMicroDuck/software/training/src/mjlab_microduck/robot/microduck/assets/neck.stl

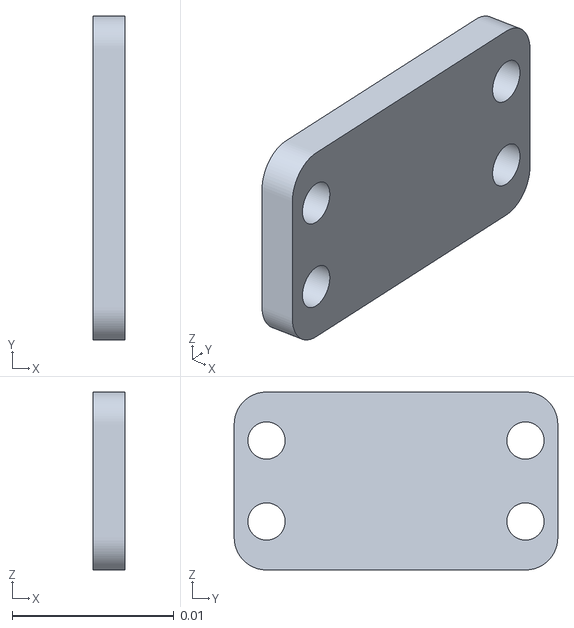
[picture p72: CAD file, 2026-09-28]
software/training/src/mjlab_microduck/robot/microduck/assets/neck.stl
0.002 x 0.02 x 0.011
