FromAIToReality/OpenMicroDuck/software/training/src/mjlab_microduck/robot/microduck/assets/yaw2roll.stl

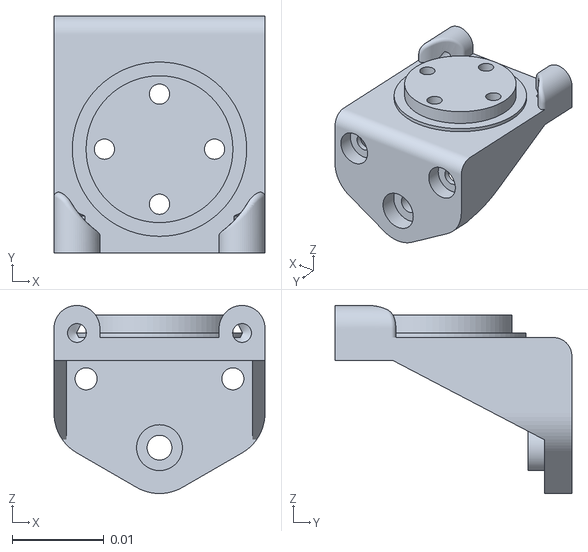
[picture p75: CAD file, 2026-09-28]
software/training/src/mjlab_microduck/robot/microduck/assets/yaw2roll.stl
0.023 x 0.0258 x 0.0205
