FromAIToReality/OpenMicroDuck/software/training/src/mjlab_microduck/robot/microduck/assets/lens.stl

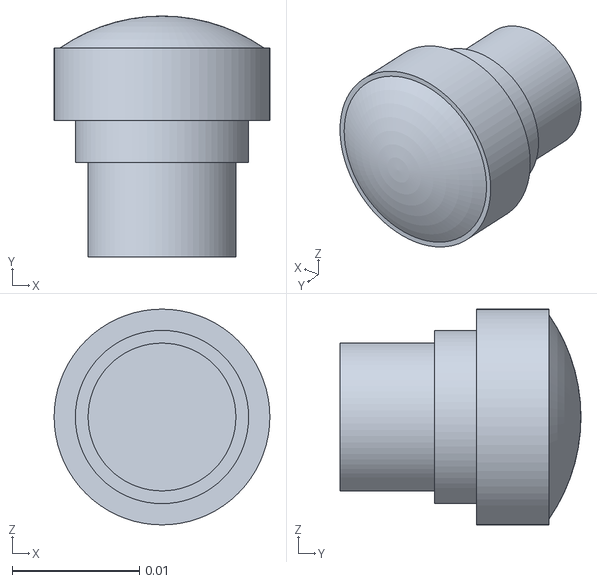
[picture p77: CAD file, 2026-09-28]
software/training/src/mjlab_microduck/robot/microduck/assets/lens.stl
0.0169 x 0.0189 x 0.0169
