FromAIToReality/OpenMicroDuck/software/training/src/mjlab_microduck/robot/microduck/assets/motor_support.stl

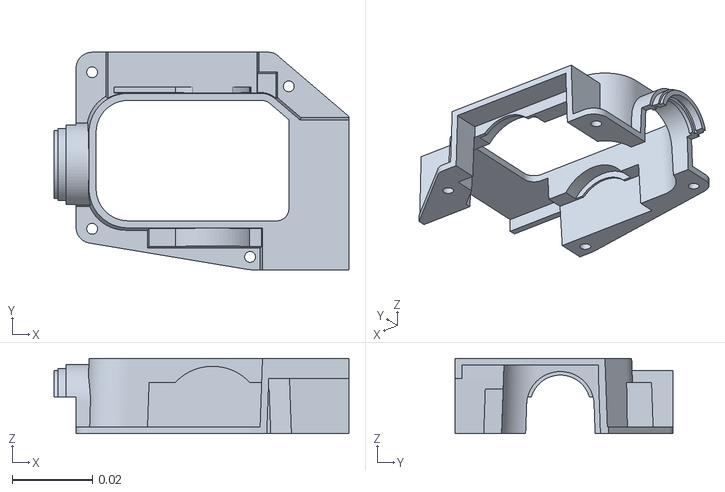
[picture p78: CAD file, 2026-09-28]
software/training/src/mjlab_microduck/robot/microduck/assets/motor_support.stl
0.0735 x 0.0542 x 0.0188
