FromAIToReality/OpenMicroDuck/software/training/src/mjlab_microduck/robot/microduck/assets/roller_blade.stl

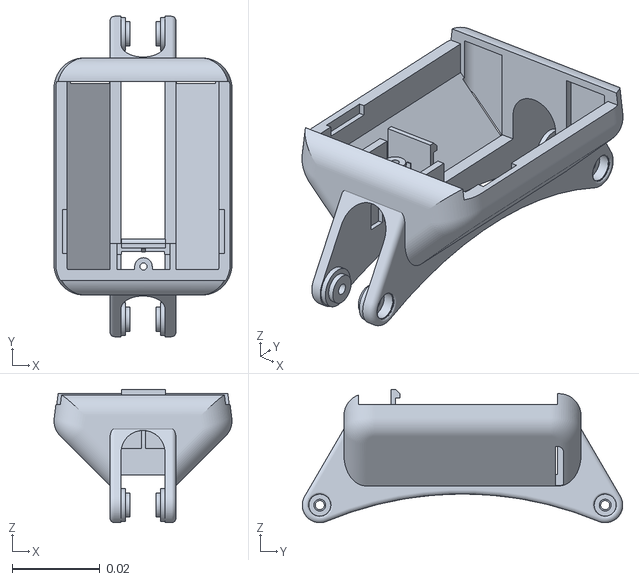
[picture p80: CAD file, 2026-09-28]
software/training/src/mjlab_microduck/robot/microduck/assets/roller_blade.stl
0.0405 x 0.073 x 0.0304
