FromAIToReality/OpenMicroDuck/software/training/src/mjlab_microduck/robot/microduck/assets/face_part.stl

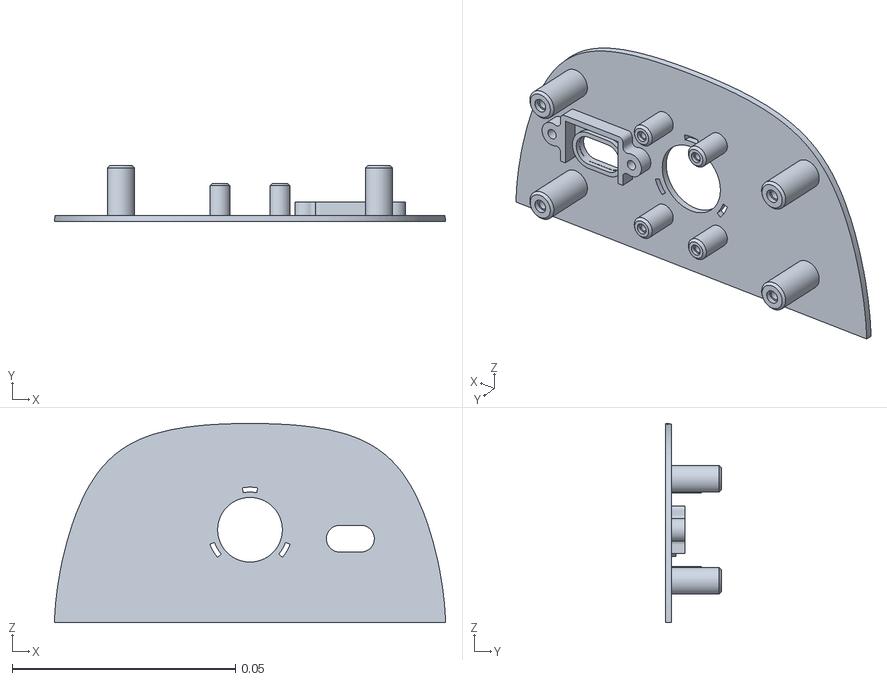
[picture p81: CAD file, 2026-09-28]
software/training/src/mjlab_microduck/robot/microduck/assets/face_part.stl
0.0877 x 0.0125 x 0.0446
