FromAIToReality/OpenMicroDuck/software/training/src/mjlab_microduck/robot/microduck/assets/np_f970.stl

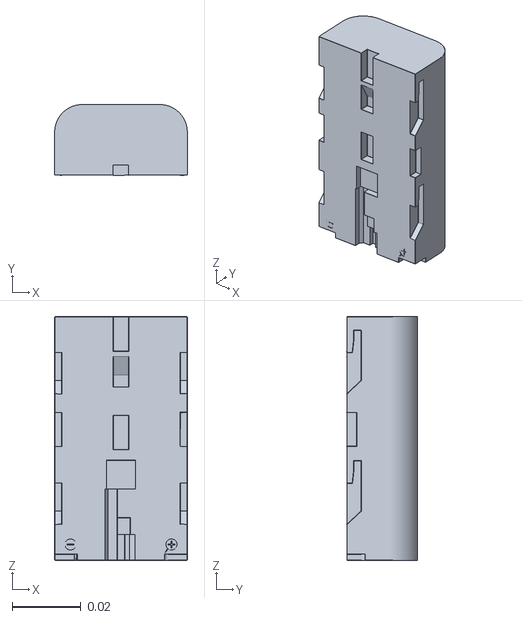
[picture p83: CAD file, 2026-09-28]
software/training/src/mjlab_microduck/robot/microduck/assets/np_f970.stl
0.0386 x 0.0206 x 0.0708
