FromAIToReality/OpenMicroDuck/software/training/src/mjlab_microduck/robot/microduck/assets/bearing_roll.stl

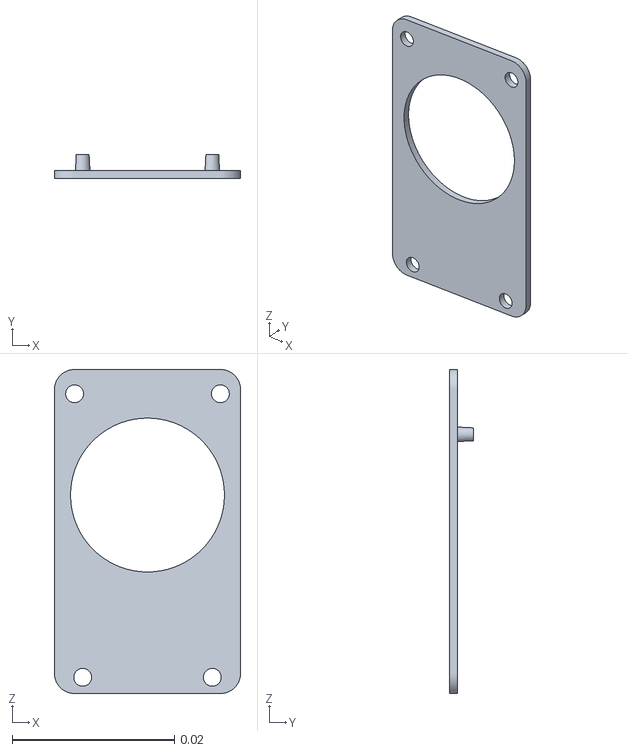
[picture p84: CAD file, 2026-09-28]
software/training/src/mjlab_microduck/robot/microduck/assets/bearing_roll.stl
0.023 x 0.003 x 0.04
