FromAIToReality/OpenMicroDuck/software/training/src/mjlab_microduck/robot/microduck/assets/tire.stl

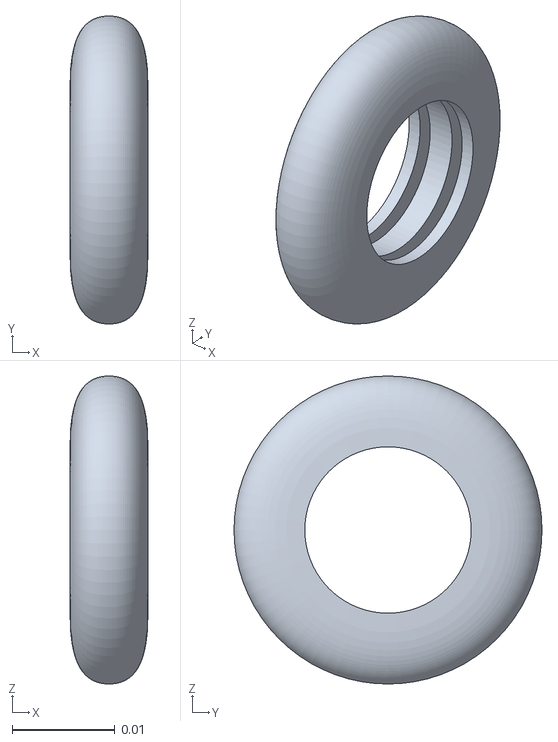
[picture p85: CAD file, 2026-09-28]
software/training/src/mjlab_microduck/robot/microduck/assets/tire.stl
0.0076 x 0.03 x 0.03
