FromAIToReality/OpenMicroDuck/software/training/src/mjlab_microduck/robot/microduck/assets/yaw_roll_motion.stl

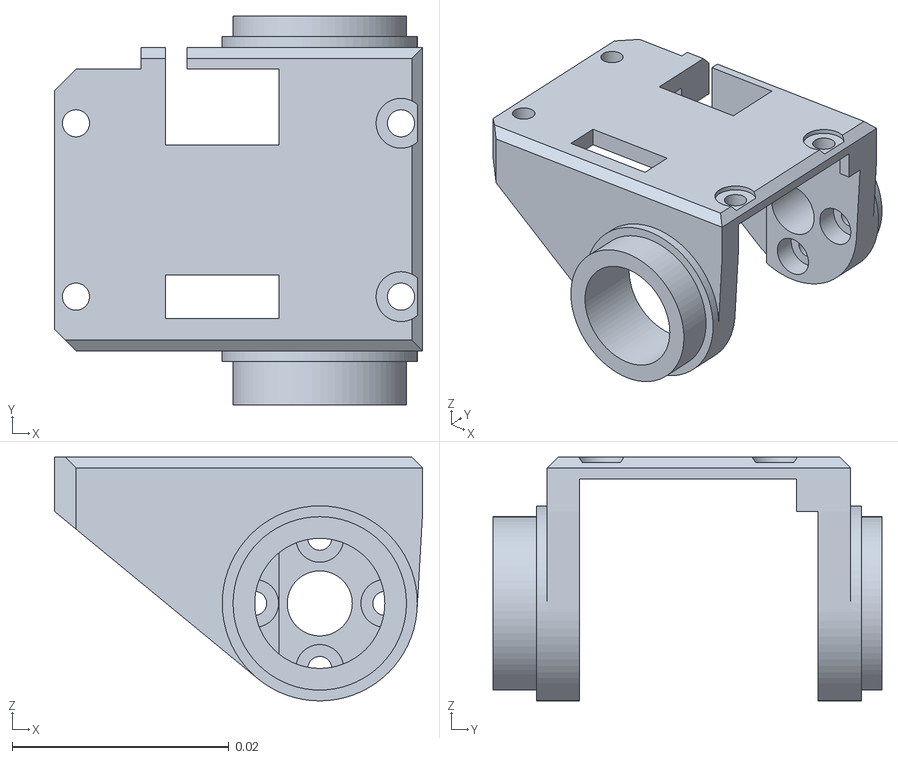
[picture p86: CAD file, 2026-09-28]
software/training/src/mjlab_microduck/robot/microduck/assets/yaw_roll_motion.stl
0.034 x 0.0359 x 0.0225
