FromAIToReality/OpenMicroDuck/software/training/src/mjlab_microduck/robot/microduck/assets/banana_pcb_locker.stl

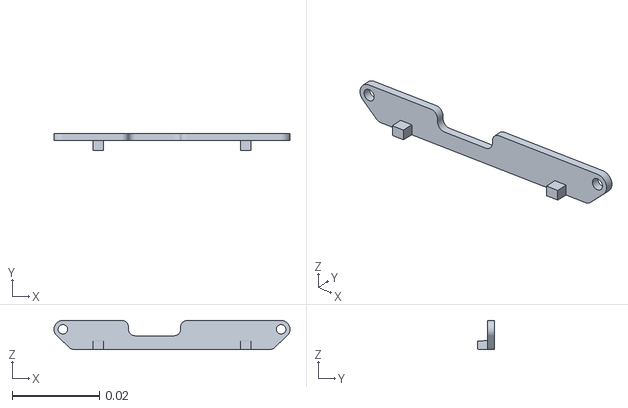
[picture p88: CAD file, 2026-09-28]
software/training/src/mjlab_microduck/robot/microduck/assets/banana_pcb_locker.stl
0.0541 x 0.0038 x 0.00665
