FromAIToReality/OpenMicroDuck/software/training/src/mjlab_microduck/robot/microduck/assets/elec_rpi_robot_hat_pcb.stl

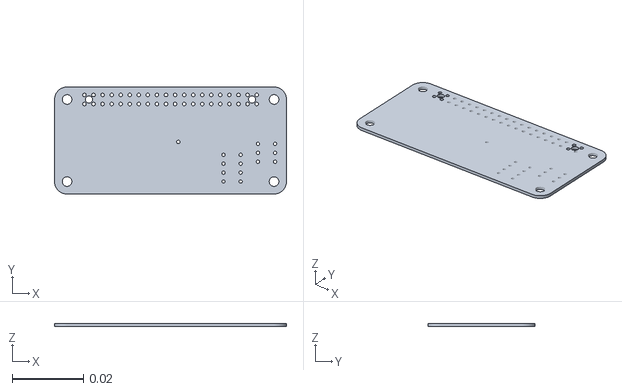
[picture p89: CAD file, 2026-09-28]
software/training/src/mjlab_microduck/robot/microduck/assets/elec_rpi_robot_hat_pcb.stl
0.065 x 0.03 x 0.00084
