FromAIToReality/OpenMicroDuck/docs/reference-validation.md

# 技术资料补充检查

2026-09-28，在第一轮代码整合后补充 89 个技术资料文件，详见[逐文件来源及哈希](../provenance/reference-import-manifest.json)。

- 已核对来源仓库当前 master 提交与本地归档均为 `a23f4c18a4741a3cde5257e639960ea37bbadd8d`，无需重复下载相同版本。
- 全部新增文件存在，发布哈希与补充清单一致；单文件大小检查和基本凭据/私人路径模式检查通过。
- 全部本地 Markdown 目标路径检查通过；20 处未导入目标改为固定上游链接，逐项确认这些目标在原始快照中存在。
- 新增参考文档顶部标明原作者来源，实测、照片、采购和设计结论不冒充本项目记录。
- 不导入上游加群二维码和推广素材。用户要求保留的本项目交流群图片仍在首页。
- 做卡脚本未执行，公开默认账户密码已在导航提示必须更改；未进行任何设备写入。
- 本轮不改变已导入的舵机和训练程序，未新增实机或训练测试结果。新增 Rust 工具和辅助分析脚本未编译/运行。
- 仅验证资料归档和链接路径，没有重新认证电气安全、板卡兼容性、价格或采购链接商品规格。历史资料中的结论可能随版本变化。
