FromAIToReality/OpenMicroDuck/调试记录.md

> **上游技术参考，不是本项目实测结论。** 来源：[fanhao375/microduck-replica](https://github.com/fanhao375/microduck-replica/blob/a23f4c18a4741a3cde5257e639960ea37bbadd8d/%E8%B0%83%E8%AF%95%E8%AE%B0%E5%BD%95.md)。保留原作者及贡献者署名；正文中的“本项目”、实物、照片和测试记录属于上游。与我们的硬件不一致时，以[本项目说明](docs/hardware.md)为准。

# 调试记录

**简体中文**

> **当前状态：Armbian 起来了、WiFi 通了、ttyS2 有了、官方运行时装上，下一步舵机总线接主控**
> 最后更新：2026-09-17

[构建日志](构建日志.md) 记的是**机械**：打印、试装、公差。
这份记的是**电气与软件**：先是**一步一步的操作手册**（拿到货怎么配、怎么接、怎么测），下面是**按日期的过程**（做了什么、看到什么、下一步是什么）。

结论性的坑单独整理在 [踩坑记录](踩坑记录.md)。板子和芯片是什么、为什么这么选，在 [硬件入门](docs/硬件入门.md)。

---

## 进度

| 日期 | 阶段 | 状态 | 备注 |
|---|---|---|---|
| 2026-09-10 | 舵机 + 调试板到货 | ⚠️ 遇到问题 | 调试板 TTL 口跟舵机 2.0 mm 线不匹配 |
| 2026-09-12 | 主控、ToF、电池、电池仓、SD 卡、排针、摄像头到齐 | ✅ 完成 | 排针已焊到 Radxa 上 |
| 2026-09-12 | 舵机装机械件 | ✅ 完成 | **HD-1910 跟 XL330 有结构差异**，改件重打后可适配 |
| 2026-09-13 | 15 颗配 ID | ✅ 完成 | 用剪开的舵机线飞到 URT-2，一颗颗配 |
| 2026-09-13 | 台架通总线（URT-2 ↔ Radxa） | 🔨 进行中 | 电源 7.4V 进 URT-2，USB 进 Radxa host 口 |
| 2026-09-16 | 主控裸板上电 | ✅ 完成 | 无异常 |
| 2026-09-16 | 主控刷机（2G 板 / microSD） | ❌→✅ | Armbian 官方镜像在 V1.12 板上起不来（引导程序），换瑞莎引导后 09-17 起来，见下 |
| 2026-09-17 | 官方脚本 setup-board / migrate-network / install | ✅ 完成 | ttyS2、NetworkManager、ONNX Runtime、daemon 0.13.0 |
| 2026-09-17 | 整机 15 颗上总线（URT-2 ↔ 电脑） | ✅ 完成 | 0 超时 0 校验错，15 颗同步读 4.8 ms；卡了一小时的是 URT-2 上电顺序 |
| 2026-09-17 | 网页调试台 `tools/servo-web/` | ✅ 完成 | 滑块、姿态、序列、3D 跟随、重心显示、寄存器导出 |
| 2026-09-18 | 校零、站姿、缩起来 ↔ 站起来序列 | 🔨 进行中 | 能自己站起来坐下（[视频](https://github.com/fanhao375/microduck-replica/blob/a23f4c18a4741a3cde5257e639960ea37bbadd8d/assets/%E9%A6%96%E6%AC%A1%E4%B8%8A%E7%94%B5-2026-09-18.mp4)）；零位还有 4 颗要重校，方向反的 4 颗用页面 ± 翻 |
| 2026-09-17 | `imu_to_dxl` 板到货、上电 | ✅ 完成 | 3.3 V 正常。J4/J5 座子间距对但**外壳跟飞特线不匹配**，削掉外壳能插，v2 换座 |
| — | 不打 HAT 飞线接主控 | 📋 计划中 | 等转接板、降压模块；步骤已写好 ↓ |

图例：📋 计划中 · 🔨 进行中 · ✅ 完成 · ⚠️ 遇到问题 · ❌ 此路不通

---

## 手头有的

| 东西 | 数量 | 状态 |
|---|---|---|
| 飞特 HD-1910-C001 | 15 | ✅ 到货 2026-09-10 |
| 飞特 FE-URT-2 调试板 | 1 | ✅ 到货 2026-09-10 |
| Radxa Zero 3W 2 GB（裸板，无 eMMC） | 1 | ✅ 到货 2026-09-12，**排针已焊** |
| Radxa Zero 3W 8 GB + 64 GB eMMC | 1 | 📦 月底 |
| NP-F550 电池 + 电池仓 | — | ✅ 到货 2026-09-12 |
| VL53L8CX ToF | 1 | ✅ 到货 2026-09-12 |
| 摄像头 | 1 | ✅ 到货 2026-09-12 |
| 高耐久 microSD | — | ✅ 到货 2026-09-12 |
| 2×20 排针 | — | ✅ 到货并焊上 |
| `imu_to_dxl` PCB + SMT | 5 | ✅ 到货 2026-09-17，¥629.72；上电 3.3 V 正常，连接器封装有问题 |
| 读卡器、5 V 降压模块 | — | ✅ 到货 2026-09-16 |
| 转接线、半双工转接板 | — | 📋 待买（台架先用 URT-2 顶） |

---

## 飞特资料在哪

本地 `飞特-HD1910/` 只有规格书 PDF、DWG、STP。**软件和手册在 Gitee，不在官网**：

| 要什么 | 在哪 |
|---|---|
| **FD 调试软件** + **CH340 驱动** | **仓库里就有：[`tools/飞特/`](https://github.com/fanhao375/microduck-replica/tree/a23f4c18a4741a3cde5257e639960ea37bbadd8d/tools/%E9%A3%9E%E7%89%B9)**（FD 1.9.8.5 + 驱动，MIT，带 sha256）。原始出处 [gitee.com/ftservo/fddebug](https://gitee.com/ftservo/fddebug) |
| 例程 / 通信协议 / 内存表 | [gitee.com/ftservo](https://gitee.com/ftservo) 各仓库 |
| 官网软件页（备用） | [feetech.cn/software.html](https://www.feetech.cn/software.html) |
| 入手教程 PDF | [先看这里-入手教程](https://www.feetech.cn/Data/feetechrc/upload/file/20220618/%E5%85%88%E7%9C%8B%E8%BF%99%E9%87%8C-%E5%85%A5%E6%89%8B%E6%95%99%E7%A8%8B2-1.pdf) |

---

## 舵机配置 · 拿到货一步一步做

**目标**：15 颗 HD-1910 每颗设好 ID、打开保护、贴上标签，装机时拿起来就知道它是哪个关节。

### 需要什么

| 东西 | 说明 |
|---|---|
| HD-1910-C001 × 15 | 出厂 ID **全是 1** |
| FE-URT-2 调试板 + USB-C 线 | 用左边两个白色 3 针口（丝印 `TTL-Bus`，`G V1 S`）。右边 4 针是 RS485，不用 |
| 一根剪开的舵机线 | 调试板的口跟舵机 2.0 mm 线**插不上**，得飞线。15 根牺牲一根 |
| 电源 | 三选一，见第 3 步。**只配 ID 的话 USB 就够** |
| 软件 | [`tools/飞特/`](https://github.com/fanhao375/microduck-replica/tree/a23f4c18a4741a3cde5257e639960ea37bbadd8d/tools/%E9%A3%9E%E7%89%B9)：FD 1.9.8.5 + CH340 驱动，Windows |
| 万用表 | 量电压、查线序 |
| 标签纸 + 笔 | 第 7 步用 |

### 第 1 步 · 装软件

```
1  插上 URT-2 → 设备管理器「端口」里出现 USB-Enhanced-SERIAL CH343 (COMx)，记下号
   URT-2 是 CH343，Win10/11 自带驱动，不用装。没出现才装 tools/飞特/CH340_URT.rar（老款 URT-1 用）
2  解压 tools/飞特/FD1.9.8.5(250729).7z → 直接运行，不用安装
```

### 第 2 步 · 飞线

剪一根舵机线，一头是 2.0 插头、另一头三根裸线。**认脚号，别认颜色**：

```
舵机线                       URT-2
脚 1  Signal / TTL    →    S     焊到板背面白口 S 脚的焊点上（临时：线头镀锡后插进白口 S 孔）
脚 2  Vcc             →    V1    蓝色接线端子
脚 3  GND             →    G     蓝色接线端子
```

- **中间那根一定是 V**，飞特和 Dynamixel 在这点上一致 —— V 放错才会烧
- S 和 G 接反了**不会烧**，只是搜不到，对调即可
- 脚 1 在插头上有小三角或缺口标记，或看舵机本体插座旁丝印

### 第 3 步 · 供电

**URT-2 上那个拨码是 TTL 信号电平（3.3 / 5 V）选择，不是供电切换。** 拨 5 V（HD-1910 认 2–5 V，余量大）。
USB 插上时 V1 端子上有 5 V（实测 2026-09-12）。2026-09-17 查了厂家资料：URT-2 有两个接线端子，**V1 是 TTL 总线的外接电源输入，标称 DC 4.8–12 V**；V2 是 RS485 的，DC 12–24 V。URT-1 说明书的接线照片就是 USB 和外接电源同时接的。既然规格允许 12 V 进 V1，V1 和 USB 5 V 之间就不可能是直通，应该是二极管隔离，USB 单独插时才把 5 V 送到 V1。所以两种接法都行：

| 用什么 | 怎么接 | 什么时候用 |
|---|---|---|
| **USB 5 V** | 什么都不接，V1 自带 5 V | **配 ID、改参数**。HD-1910 从 4 V 起工作，空载够 |
| 可调开关电源 / 电池 → **V1 端子** | + 进 V1、− 进 G，舵机线直接插 TTL-Bus 口。厂家标准接法 | 15 颗一起，台架 |
| 可调开关电源 / 电池 → 舵机 | + 直接接舵机 V，− 接舵机 G **和** URT-2 的 G（共地），V1 空着 | 不想让电流过 URT-2 的端子和走线时（15 颗堵转能到十几安，端子标 6 A） |

⚠️ 别超 8.4 V，那是 HD-1910 的上限，不是 URT-2 的。

⚠️ **上电顺序：先插 USB，再给舵机上电。** 反了总线会被压在 2.1 V，一颗都不应答，见[踩坑记录 · 工具](踩坑记录.md#工具)。

**别在满电 8.4 V 的电池上做堵转测试** —— 那是 HD-1910 电压上限，零余量。

### 第 4 步 · 搜舵机

```
1  FD 里选第 1 步记下的 COM 口
2  波特率 1000000
3  点「打开」
4  只接一颗舵机（飞好线那根）
5  点「搜索」→ 列表里出现 ID 1，型号 HD-1910
```

搜不到，按顺序查：驱动装没装 → COM 口选对没 → 波特率是不是 1000000 → S 线接触好不好（临时插孔的最可疑）→ S/G 是不是反了。

### 第 5 步 · 改参数

切到「编程」页（EPROM）。**每颗都改这几项，别的别动：**

| 参数 | 出厂 | 改成 | 为什么 |
|---|---|---|---|
| **ID** | 1 | **按下表** | 官方运行时按这个 ID 找关节 |
| **过流保护** | 关 | **开** | 装机后堵转是常事，不开就是烧舵机 |
| **过压保护** | 关 | **开** | 8.4 V 满电落在 4–10 V 窗口内，不会误触发 |
| 过热保护 | 开（80 ℃） | 不动 | — |
| 波特率 | 1 Mbps | 不动 | 出厂就是官方要的 |
| 运行模式 | 模式 4 纯位置 PD | 不动 | 正是强化学习落地要的那个 |
| Return delay | 0 | 不动 | STS 系列上这项不起作用 |
| 中位 | — | **装机时再校** | 整机装完用调试台按官方折叠校（见第 9 步前「缩着能不能当标定基准」一节）。FD 的「中位校准」只会把当前位置当 2048，只能在腿伸直时用 |

改完点「保存」。

**ID 对照表** —— 来自上游 `duck-control/src/model.rs`，注释说数值是「对着硬件量出来的」：

| ID | 关节 | ID | 关节 | ID | 关节 |
|---|---|---|---|---|---|
| **10** | 右髋 yaw | **20** | 左髋 yaw | **30** | 颈俯仰 |
| **11** | 右髋 roll | **21** | 左髋 roll | **31** | 头俯仰 |
| **12** | 右髋 pitch | **22** | 左髋 pitch | **32** | 头 yaw |
| **13** | 右膝 | **23** | 左膝 | **33** | 头 roll |
| **14** | 右踝 | **24** | 左踝 | **34** | 嘴 |

**记法**：十位 = 部位（1 右腿 · 2 左腿 · 3 颈头），个位 = 从躯干往末端数（0 髋 yaw → 4 踝）。
ID 200 是 `imu_to_dxl` 板，固件里写死，不在这里配。

### 第 6 步 · 验证

```
1  断电（拔 USB 或关电源）
2  重新上电
3  再点「搜索」→ 新 ID 出现了才算写进去了
```

这步别省，EPROM 参数要断电重启才确定。

### 第 7 步 · 贴标签，下一颗

标签写**关节名 + ID**（比如「左膝 23」），别只写数字。15 颗长得一模一样。
拔掉，换下一颗，回第 4 步。一颗约两分钟。

### 第 8 步 · 看它转（可选）

搜到舵机后在主页面点它，拉位置滑杆它就跟着转。USB 5 V 空载能转但没力；接了 7.4 V 才是真实工况。

### 2026-09-17 · 第一次整机上总线，记一个「缩起来」姿态

URT-2 + 网页调试台（`tools/servo-web/`）第一次把装好的鸭子 15 颗全读通：0 超时 0 校验错，7.2 V，30–40 °C。校零后扭矩全关、鸭子躺着让关节自然垂到底，读到的就是它「缩起来」的姿态，存在 `tools/servo-web/poses/缩起来-2026-09-17.json`：

| ID | 关节 | 舵机值 | 相对零位 |
|---|---|---|---|
| 20 | left_hip_yaw | 2084 | +3.2° |
| 21 | left_hip_roll | 1997 | -4.5° |
| 22 | left_hip_pitch | 772 | -112.1° |
| 23 | left_knee | 1058 | -87.0° |
| 24 | left_ankle | 2247 | +17.5° |
| 30 | neck_pitch | 1473 | -50.5° |
| 31 | head_pitch | 1094 | -83.8° |
| 32 | head_yaw | 2059 | +1.0° |
| 33 | head_roll | 2012 | -3.2° |
| 34 | mouth | 2047 | -0.1° |
| 10 | right_hip_yaw | 2018 | -2.6° |
| 11 | right_hip_roll | 2109 | +5.4° |
| 12 | right_hip_pitch | 3195 | +100.8° |
| 13 | right_knee | 3032 | +86.5° |
| 14 | right_ankle | 1782 | -23.4° |

看得出来的两件事：左右腿的髋 pitch、膝是镜像的（左 −112° / −87°，右 +101° / +87°），跟 MJCF 里左右腿正方向相反的约定一致；颈 −50°、头 −84° 是头垂到胸前。这套数以后可以当"收纳姿态"直接发。

### 2026-09-18 · 从缩起来到站姿怎么动（官方模型正解）

用 `tools/servo-web/model/model.json`（微调过的官方 MJCF）做正解，条件：脚底前后不倾、脚底点前后位置跟官方站姿一样。结果是一条直线：**髋 = −26° + 膝/2，踝 = +26° + 膝/2**（左腿；右腿全部反号，模型约定）。腿太短（大腿 42 mm、小腿 49 mm），膝弯到 +60° 躯干也只降 3 cm。

| 膝（模型约定） | 髋 | 踝 | 躯干比站姿 |
|---|---|---|---|
| −60° | −56° | −4° | 高 10 mm |
| 0° | −26° | +26° | 0（官方站姿） |
| +30° | −10° | +40° | 低 16 mm |
| +60° | +6° | +54° | 低 33 mm |

**重心（用官方 robot_walk.xml 的质量）**：整机 744 g，脚底在脚 site 前 34 mm、后 20 mm。站姿时重心投影离脚尖 34 mm、离脚跟 20 mm；半蹲（膝 +60）到站姿整条路余量都在 17 mm 以上；头颈每 10° 重心只挪 2.4 mm；髋每多前倾 5°（踝反向 5° 保持脚平）脚往前挪、脚尖余量 +5 mm。按模型，慢慢站不该往前倒，真机倒了先查零位偏差（右髋 27°、左踝 28°）和电池装没装。页面 3D 里现在实时画重心投影（绿点 + 虚线）和两脚支撑区，出了支撑区变红，右下角报四个方向的余量。

**真机方向跟模型不一样的关节要用页面上的 ± 翻**：2026-09-18 对着缩起来的照片核，膝（23、13）、颈 pitch（30）、头 pitch（31）是反的，踝待验。序列文件里写的是模型约定的相对角度，页面发之前按 ± 换算。

从缩起来（髋 −112 / 膝 −87 / 踝 +17）站起来的顺序，做成了页面上的序列「站起来」（`poses/站起来-序列.json`）：

1. 抬头 1 s：颈、头 pitch 到 +20°。头占整机三分之一重量，趁身子还坐在桌上先摆到站姿位置。
2. 展腿脚放平 3 s：以实机站姿为基准，膝 +60 / 髋 +30 / 踝 +30（模型约定，左腿；右腿反号）。脚从身后翻到身下踩住桌面，身体被顶起约 9 cm，这一步最关键，第一次托着做。
3. 站直 2 s：沿脚平那条线到官方站姿。三个角同时线性变，脚全程平，身高只涨 10 mm。

页面加了「过渡时间」：所有姿态、站姿、回零位都从当前实际位置线性插过去，20 Hz 发同步写，不再一下跳。前提是舵机方向跟模型一致（待查 8），先单颗试 22 号往负方向是不是大腿往前抬。

### 2026-09-22 · 缩着能不能当标定基准（官方模型精确网格求交）

群里的讨论：官方零位是腿伸直，悬空手扶着摆没有参考点，一两度就摔；能不能拿缩着当基准。用官方模型把每个腿关节往折叠方向转到零件碰上（fcl 精确网格，不用凸包，[`tools/fold_contact`](tools/fold_contact/)）：

- 顶住关节的**都是脚和踝**，不是关节自己的限位，所以停在哪跟别的关节有关：膝在髋 0° 时 70.7° 碰上，髋 90° 时 89.6° 碰上
- **踝缩着时没被定住**，膝和髋都折到底后还有约 20° 能动，缩着校不了踝
- 官方 FOLD（髋、膝 ±90°）的膝几乎就是接触点，1.57 rad（89.95°）会让踝顶进大腿舵机约 0.36°（接触在 89.59°）；9/20 存的「缩」左膝换算约 88°，跟这个接触点对得上
- FOLD 的颈 / 头 pitch 是 57°，**不是接触点**：腿折好后颈要转到 66.6° 颈舵机才碰上躯干外壳，57° 前后都空着
- 这是 XL330 原版几何，飞特版改过 8 个件，要拿飞特版模型再算或在 SolidWorks 里量

分析结论：缩着只能当髋、膝的参考，而且摆法要写死。零点仍然是官方的 2048，官方代码和策略不用加补偿 —— 缩着只是参考点，不是新零点。

**最后定的做法**（调试台 0.14.0 起的基准「官方折叠（头颈摆正）」，0.15.0 按审查修过）：

- 腿按官方 FOLD 摆：膝折到踝刚贴上大腿舵机（零件顶住，每次都一样），髋 pitch 用直角尺摆到跟躯干垂直，髋 yaw / roll、踝 0°
- 头颈不按官方 FOLD 的 57°（不是接触点、靠眼睛摆不准），改成摆正：脖子竖直、头平视，嘴闭上
- **15 颗一起标**，扭矩关着用手摆。目标：± 全 −1 时 22 / 23 = 1025、12 / 13 = 3071，其余 2048；写进舵机 EEPROM（0x0B 带目标值 = 「当前位置就是这个读数」），零点照样是官方的 2048
- 膝按官方 1.57 rad 算，实际摆到接触点 89.59°，零点差约 0.36°（4 步），忽略
- 确认框逐颗列「现在 → 写成、差几度」；差 30° 以上再确认一次，**不拦**：装舵盘时转了半圈会差 180°，校准正好纠回来；方向 ± 设反了也差 180° 左右，那样校进去是错的，先用手掰一下看 3D 转向核 ±
- 校完扭矩还是关着，用手展开再开扭矩不会跳（0.15.0 起开扭矩前先把目标对准当前位置）

### 第 9 步 · 装机、归零、试行程

**零点是什么**：机器人**笔直站立**的姿态 —— 腿是直的柱子、脚平放、脖子竖直、头平视。这是 MJCF 里所有关节 = 0 的位置，对应舵机 **2048**。

**站姿不是零点。** 官方站立姿态（`DEFAULT_POSITION`）是从零点加的偏移：髋 pitch ±26°、踝 ∓26°、颈和头 pitch +20°。这是软件的事，**别把站姿校成 2048**。

**每个关节的做法**：

```
1  舵机 FD 里先转到 2048，再装舵盘（舵盘齿位对不准就近，误差归下一步）
2  把关节摆到「直」的位置，用手扶着
3  FD 编程页 →「中位校准」→ 当前位置定义为 2048（或 `tools/servo-web/` 网页调试台的「中位校准」按钮，装好以后用手扶直再点，同一个指令）
4  锁紧螺丝
5  FD 从 2048 慢慢拉到下表的上下限，看结构件碰不碰、线扯不扯
6  碰了记下那颗的实际角度 —— 比软件限位小是正常的，那才是这台机器的真实行程
```

**行程表** —— 来自 MJCF `robot_walk.xml` 的 `range`，这是**软件限位**，机械上能不能到要试。HD-1910 是 4096 步 / 360°，1° ≈ 11.4 步：

| ID | 关节 | 行程 | 舵机值（2048 为零） |
|---|---|---|---|
| 10 / 20 | 髋 yaw | 右 −30 ~ +25°　左 −25 ~ +30° | 右 1707 ~ 2332　左 1764 ~ 2389 |
| 11 / 21 | 髋 roll | ±22° | 1798 ~ 2298 |
| 12 / 22 | 髋 pitch | ±90° | 1024 ~ 3072 |
| 13 / 23 | 膝 | ±90° | 1024 ~ 3072 |
| 14 / 24 | 踝 | ±90° | 1024 ~ 3072 |
| 30 | 颈 pitch | −90 ~ +60° | 1024 ~ 2731 |
| 31 | 头 pitch | ±90° | 1024 ~ 3072 |
| 32 | 头 yaw | ±170° | 114 ~ 3982 |
| 33 | 头 roll | ±25° | 1764 ~ 2332 |
| 34 | 嘴 | −5°（闭）~ +30°（开） | 1991 ~ 2389 |

髋 yaw 左右不对称是镜像 —— 两条腿往外转 30°、往内转 25°。嘴不在 MJCF 里（策略不控制它），范围来自 `model.rs` 的 `MOUTH_CLOSED / MOUTH_OPEN`。

⚠️ **正负方向哪边是哪边，跟舵机装的朝向有关**，官方运行时里每颗有方向和偏移量（`motor.rs`，注释说是「对着硬件量的」）。试干涉的时候两个方向都拉到底就行，不用管符号。

---

---

## 不打 HAT · 飞线接主控

**单独成文了 → [docs/不打HAT.md](docs/不打HAT.md)**。很多人觉得 HAT 打样太贵，那份就是替代方案：¥70 的模块、一步一步接、哪步会烧东西。
这里只记做的时候发生了什么。

---

## 2026-09-10 · 舵机和调试板到了

**到了什么**：15 颗 HD-1910-C001，一块 FE-URT-2 调试板（USB-C，TTL 和 RS485 口都有）。

**第一个问题**：舵机原装线是 **2.0 mm 3P**（规格书写的 AMP2.0-3P），调试板左边那两个白色 TTL 口**比这个大，插不上**。板子没给 2.0 的口。

**怎么办**：买「舵机转接线 2.0 转 2.5 3P」。等线的期间要动手就剪两根线对焊。
`imu_to_dxl` 板的 J4/J5 是 PH 2.0 mm，跟舵机线是配的，**不受影响** —— 只是这块调试板的口不对。

**下一步**：转接线到了逐个配 ID。**一次只接一颗**（出厂 ID 全是 1），改完贴标签。
顺手把每颗的过流、过压保护打开（出厂默认关）。波特率和运行模式出厂就是对的，不动。
步骤和 ID 表见上面 [舵机配置 · 拿到货一步一步做](#舵机配置--拿到货一步一步做)。

---

## 2026-09-12 · 器件到齐，主控排针焊好，舵机开始装机械件

**到了什么**：Radxa Zero 3W（2 GB 裸板）、ToF、电池、电池仓、microSD、排针、摄像头。加上 09-10 的舵机和调试板，**除了 `imu_to_dxl` 板（立创还在做）和飞线模块（降压、转接板、转接线），全齐了**。

**做了什么**：
- 2×20 排针焊到 Radxa 上了
- 开始把飞特 HD-1910 往机械件里装

**发现的问题**：**HD-1910 跟原版 XL330 在结构上有差异**（压腿那一处）。同事改了结构件重新打印，改后能装。
具体哪个件、改了哪里、改了多少 —— *待补*（拍照、量尺寸，写进 [构建日志](构建日志.md)，同时在 [执行器选型](docs/执行器选型.md) 的 HD-1910 那节加一条「机械上不是直接替换，要改件」）。

**算法侧发来训练前数据采集清单** → 填好的在 [docs/HD-1910训练前数据清单.md](docs/HD-1910训练前数据清单.md)，仓库有的全填了，台架项标了怎么测。

**下一步**：
- 舵机继续装，装完一条腿先量一次活动范围
- 配 ID —— 转接线还没到，先按 [上面第 2 步](#第-2-步--飞线) 剪一根舵机线飞过去。**今天先做这个**
  - ✅ 线飞好了，拨码拨到 USB 侧，G–V1 量到 5 V
  - ✅ 插电脑出 **COM5**，芯片是 **CH343**（不是 CH340），Win 自带驱动直接认 —— 手册第 1 步已改
- 主控刷机 —— **没读卡器，做不了**。卡是 microSD，板子自己不能当读卡器用；笔记本没 SD 槽的话得买一个（USB 3.0 的）。到了按 [不打 HAT · 第 1 步](docs/不打HAT.md#第-1-步--主控点亮什么都别接) 点亮

---

## 2026-09-13 · 15 颗全配完、全装上，开始台架

**做了什么**：15 颗 HD-1910 全部配好 ID、开了过流过压保护、装进机身。

**台架接法**（不用降压模块，Radxa 用充电头）：
- 可调电源 7.4 V 限 2 A → **直接接舵机总线 V/G**，URT-2 的 G 也接电源负极共地，**V1 端子空着**
- URT-2 拨码 = 信号电平，拨 5 V（之前写的「外接侧」是错的，那板子没有供电切换）
- URT-2 USB-C → Radxa **host** 口（不是电源口）
- Radxa 电源口 → 5V/2A 充电头（**别用电脑 USB，500 mA 不够**）

**下一步**：`dmesg` 看 CH343 出没出 `ttyACM0` → Python 扫 ID 10–34 → 15 颗全应答 → 官方运行时。

---

## 2026-09-16 · 主板上电，烧卡

**做了什么**：
- Radxa Zero 3W 裸板上电，正常。排针 2.54 mm，跟 DXF 里的孔距对上（两排 y = 25.41 / 27.95 mm）。
- 读卡器、5 V 降压模块到了。
- 烧 Armbian 26.8.1 trixie minimal（sha256 校验过）。Rufus 便携版，认 `.img.xz`，2 分钟写完。截图在 [`assets/flash/`](assets/flash/)，步骤写进了 [不打 HAT · 第 1 步](docs/不打HAT.md#第-1-步--主控点亮什么都别接)。

**踩的坑**：想用 `wsl --mount` 把 `.not_logged_in_yet` 写进烧好的卡，报 `ERROR_FILE_NOT_FOUND`，WSL 挂不上 USB 读卡器。改成**先把预设塞进镜像再烧**，脚本放在 [`tools/radxa/`](tools/radxa/)，不用管理员。记在 [踩坑记录](踩坑记录.md)。

**瑞莎资料**：原理图 / 产品简介 / 2D DXF / 3D STP / 元件位置图都下了，本地 `Radxa-Zero3W/`。**没有 PCB 源文件**，位置图和 DXF 里也没标 pin 1。认 pin 1 靠万用表：OTG 口供电，量排针四个角，3.3 V 那个是 pin 1，它旁边 5 V 的是 pin 2。

**下一步**：卡插上开机 → 路由器里找 `radxa-zero3` → `ssh duck@IP` → 插 URT-2 看 `dmesg`。

---

## 2026-09-16 ～ 17 · 主板点亮，九张卡

**结果**：Armbian 26.2.1 vendor 在板上跑起来了，WiFi 自动连、ssh 能进、`/dev/ttyS2` 出来了、插电脑多一个 USB 串口，Pollen 官方三个脚本跑完，daemon 0.13.0 装上。做卡一键化在 [`tools/radxa/`](tools/radxa/)。

**过程**（按时间）：
- 09-16 晚：Rufus 烧 Armbian 26.8.1，WiFi 预设塞进镜像。开机灯双闪，局域网里没有它。以为是 WiFi：路由器 WPA3 混合、AIC8800 不支持 GCMP-256、5G 频段、两套驱动打架，一版版改，烧了四次，都没有。
- USB 串口这条路也试了：`g_serial` + `dwc3-peripheral`，电脑看不见设备。
- 读卡：把卡的根分区拷出来挂上看，**根分区一个字节没被写过**，首次开机标记还在，分区没扩容。也就是内核起了心跳但从没挂上系统盘。前面改 WiFi 的四版全是无用功，问题在更前面。
- 换底子到 26.2.1（官方指定版本）、去掉 SDR104，都不行。做了「黑匣子」initramfs（进 initramfs 灯灭、找到盘常亮、失败快闪、内核日志写到卡的分区外区域），结果灯一直双闪，连 initramfs 都没进。
- 09-17 零点：瑞莎官方镜像（b1，2025-07）烧上，同一张卡同一块板，两分钟连上 WiFi。ssh 进去看：SD 卡跑 SDR104 正常，WiFi 是 AIC8800D80/DS2，设备树跟 Armbian 的逐项比对基本一样。板子、卡、供电、设备树全排除。
- 比引导程序：Armbian 用主线 U-Boot 2025.10 + DDR 固件 v1.21（2024-01），瑞莎用 rk U-Boot 2017.09-51 + DDR v1.23（2024-09）+ BL31 v1.45。板子是 2024-11 的 V1.12。
- 把瑞莎镜像的扇区 64～32767（idbloader + u-boot.itb）覆盖到 Armbian 卡上，加一个 `/boot/extlinux/extlinux.conf`，**第九张卡起来了**。灯：双闪 → 灭 → 常亮，局域网里 `192.168.0.102`，电脑上多了 COM5。
- 然后按官方 `install-by-hand.md`：extlinux 挂 `uart2-m0` + `dwc3-peripheral`、控制台放 tty1、mask 掉 ttyS2/ttyFIQ0 的 getty；WiFi 改成 Armbian 标准 netplan 写法；`setup-board.sh`（aic3x 编解码器 DKMS、ONNX Runtime 1.28、ToF udev 规则）→ `migrate-network.sh`（NetworkManager）→ 重启 → 再各跑一次 → `install.sh`（daemon 0.13.0）。板子走电脑的 Clash 代理下 GitHub。

**踩的坑**都进了[踩坑记录](踩坑记录.md)：引导程序、GCMP-256、dwc3-peripheral、GitHub 代理、首次开机预设缺变量。

**下一步**：第 4 步舵机总线接主控（URT-2 走 USB，或飞线到 pin 8/10 用 `/dev/ttyS2`），`robotctl health` 看 15 颗舵机。

**躯干 IMU 两条路线**（2026-09-17 定下来并行）：

| | A · `imu_to_dxl` 小板 | B · GY-BNO085 模块直飞主板 |
|---|---|---|
| 硬件 | 自绘板，已到货，3.3 V 正常，连接器封装待改 | ¥66 现成模块，I2C 接 40 针 pin 3/5（跟 ToF 同一条 i2c3），3.3 V 取 pin 1 |
| 软件要做的 | STM32 固件：ID 200 寄存器协议 + IMU 融合，**目前没有公开固件，从零写** | robotd 里加一个 I2C IMU 源（Rust），BNO085 片内融合直接出四元数 |
| 对官方运行时 | 协议兼容，robotd 不改 | robotd 改 IMU 后端 |
| 共同要做 | 飞特舵机协议移植（robotd 说的是 Dynamixel） | 同左 |

原型机时代（树莓派 Zero 2 W 版）就是 I2C 接 BNO055，B 路线有先例。先买一块，`i2cdetect -y 3` 看到 0x4A、Python 读出四元数就算通。
