FromAIToReality/OpenMicroDuck/cad/print/history-legacy/README.md

# 旧版排盘预览

这五张图来自本地整理资料，仅保留作历史对照，不对应当前 2026-09-30 的六盘打印工程。

请使用 [CAD 首页的当前六盘预览](../../README.md#当前盘位预览) 和 [当前 3MF](../microduck-FT-BambuStudio-20260930.3mf)。
