FromAIToReality/OpenMicroDuck/(commit log)

2026-09-28 docs: establish attributed HD1910 integration and CAD download guide
    [upstream-FT-P2S-PLA-20260915.3mf]
2026-09-28 feat: import upstream HD1910 training and servo simulation baseline
    [ankle_l_v1.stl, ankle_left.stl, ankle_r_v1.stl, ankle_right.stl, arm.stl, axis.stl, banana_pcb_locker.stl, bearing_roll.stl]
2026-09-28 docs: add procurement wiring servo protocols and assembly references
    [磁编码SMS&STS&HTS-十六进制指令生成表-250508.xlsx]
2026-09-28 docs: feature assembly PDF and cover on homepage
2026-10-11 Refresh FT CAD assets and remove promotional download links
2026-10-11 Publish organized CAD guide and complete release archive
